mvalancy/j501-agx-orin/docs/README.md

[J501 AGX Orin](../README.md) / **docs**

# Docs

Reference material for reviewing and building the enclosure. Most of these files are generated by
[`tools/write_docs.py`](../tools/write_docs.py) from the CAD model, so edit the model, not the tables.

<p align="center">
  <a href="assembly/">Assembly step 3: heat-set inserts</a>
</p>

| File | What it is |
|---|---|
| [`assembly/`](assembly/) | Step pictures for [ASSEMBLY.md](../ASSEMBLY.md) |
| [`BOM.csv`](BOM.csv) | Bill of materials: printed parts, hardware and electronics, with dimensions |
| [`fastener-sources.csv`](fastener-sources.csv) | Where each fastener comes from, and how closely its model matches |
| [`check-sheet.pdf`](check-sheet.pdf) | Dimensioned drawings to check printed parts against |
| [`engineering-review.html`](engineering-review.html) | Every table below on one filterable page (download it, or run `tools/serve_preview.py`) |
| [`cad-agent-report.html`](cad-agent-report.html) | Pass or fail for every part, print file and design check |
| [`measurement-register.csv`](measurement-register.csv) | Every dimension the design relies on, and whether it was measured or assumed |
| [`cutout-register.csv`](cutout-register.csv) | Every cutout in the plates and walls, and what it is for |
| [`feature-review.csv`](feature-review.csv) | Feature-by-feature printability review |
| [`connector-inventory.csv`](connector-inventory.csv) | Connectors and components on the carrier, from the schematic |
| [`model-search.csv`](model-search.csv) | Where each vendor model was found, and which are still missing |
| [`img/hero/`](img/hero/) | The animated README banner, drawn from the STEP files by [mvalancy/mvalancy's `tools/hero`](https://github.com/mvalancy/mvalancy/tree/22437c66382b9fb908806cc1010b3036e4385004/tools/hero) |

GitHub shows the `.csv` files as searchable tables. The `.html` pages show as source on GitHub; open them locally to read them.

## Folders

| Folder | What is in it |
|---|---|
| [`assembly/`](assembly/) | Step pictures for ASSEMBLY.md |
