mvalancy/j501-agx-orin/preview/README.md

[J501 AGX Orin](../README.md) / **preview**

# Renders

Every picture of the Rev 0.9 design, rendered from the CAD by [`tools/render.py`](../tools/render.py). Click a picture for full size.

The same renders are on the local review site, which adds STL, 3MF and Bambu Studio download buttons:
`python tools/serve_preview.py` serves [`index.html`](index.html). The print files themselves are in [`exports/`](../exports/).

**Sections:** [Assembled](#assembled) · [Structure](#structure) · [Storage and cables](#storage-and-cables) · [Printed parts](#printed-parts) · [Hardware and electronics](#hardware-and-electronics) · [Carrier connectors](#carrier-connectors)

## Assembled

<table>
<tr>
<td width="33%" valign="top"><a href="assembled.png">Assembled: flush shell, framed I/O plates, finger-safe hex roof</a><br><b>Assembled</b>: flush shell, framed I/O plates, finger-safe hex roof</td>
<td width="33%" valign="top"><a href="exploded.png">Exploded: sliding plates captured by the lid, cooler tied to the floor</a><br><b>Exploded</b>: sliding plates captured by the lid, cooler tied to the floor</td>
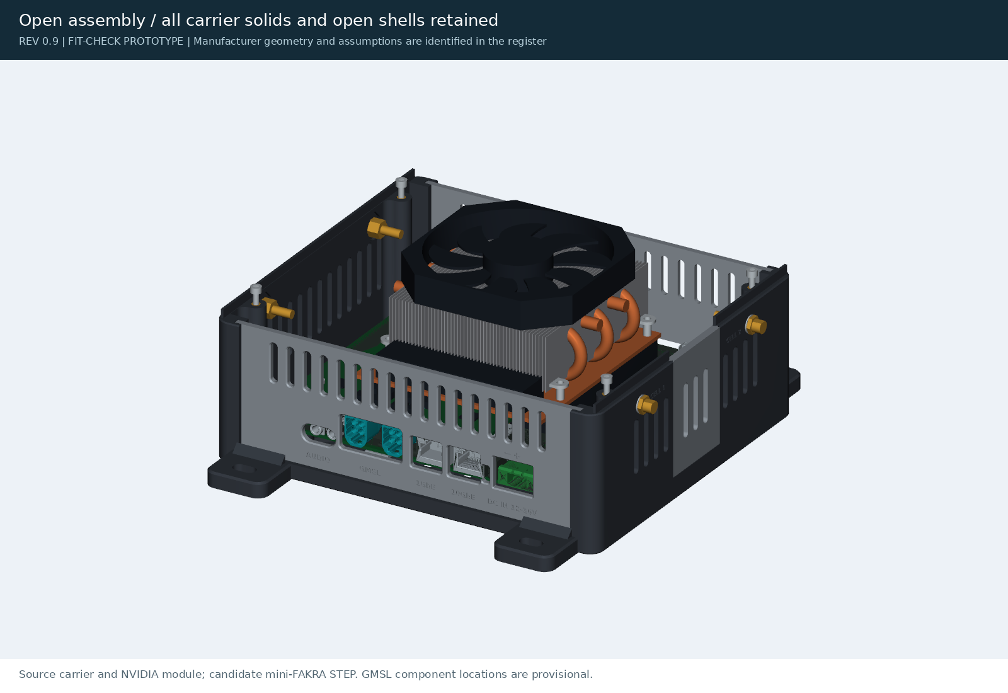
[picture p26: preview/open.png]
Open: every carrier solid and open shell kept
<td width="33%" valign="top"><br><b>Open</b>: every carrier solid and open shell kept</td>
</tr>
<tr>
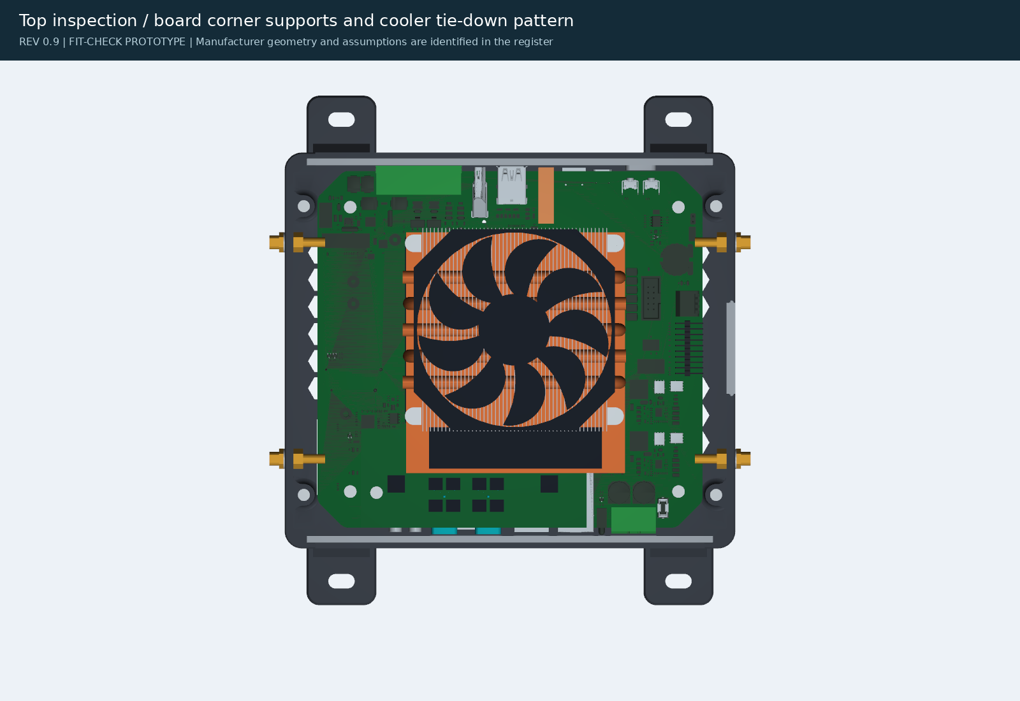
[picture p27: preview/top.png]
Top: board corner supports and cooler tie-down pattern
<td width="33%" valign="top"><br><b>Top</b>: board corner supports and cooler tie-down pattern</td>
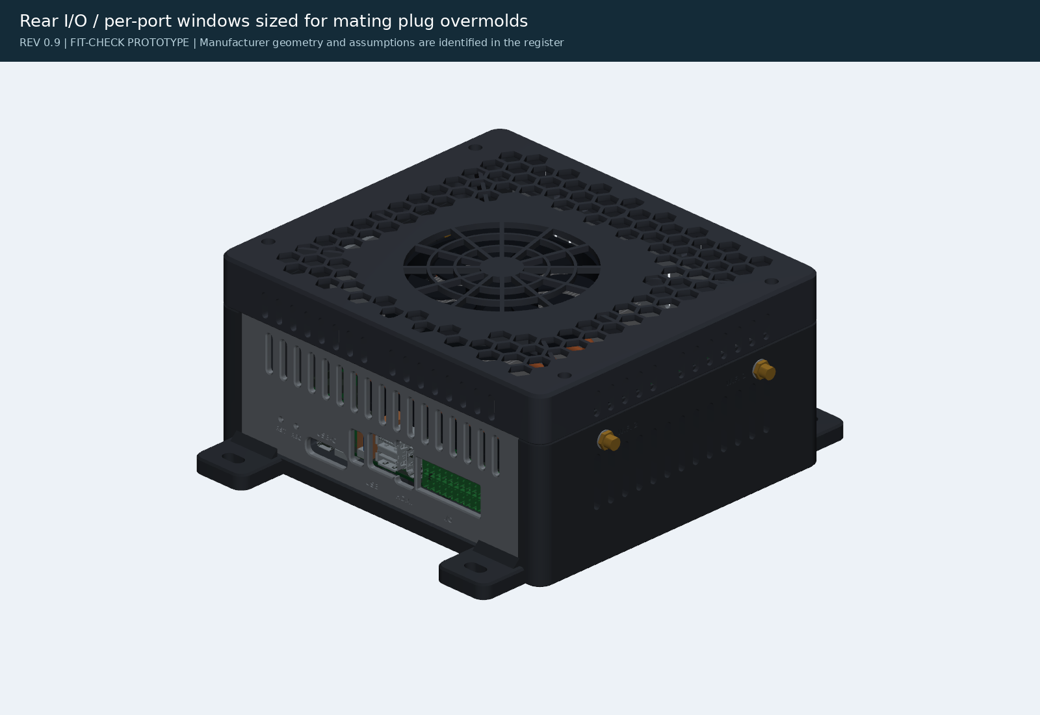
[picture p28: preview/rear.png]
Rear I/O: per-port windows sized for plug overmolds
<td width="33%" valign="top"><br><b>Rear I/O</b>: per-port windows sized for plug overmolds</td>
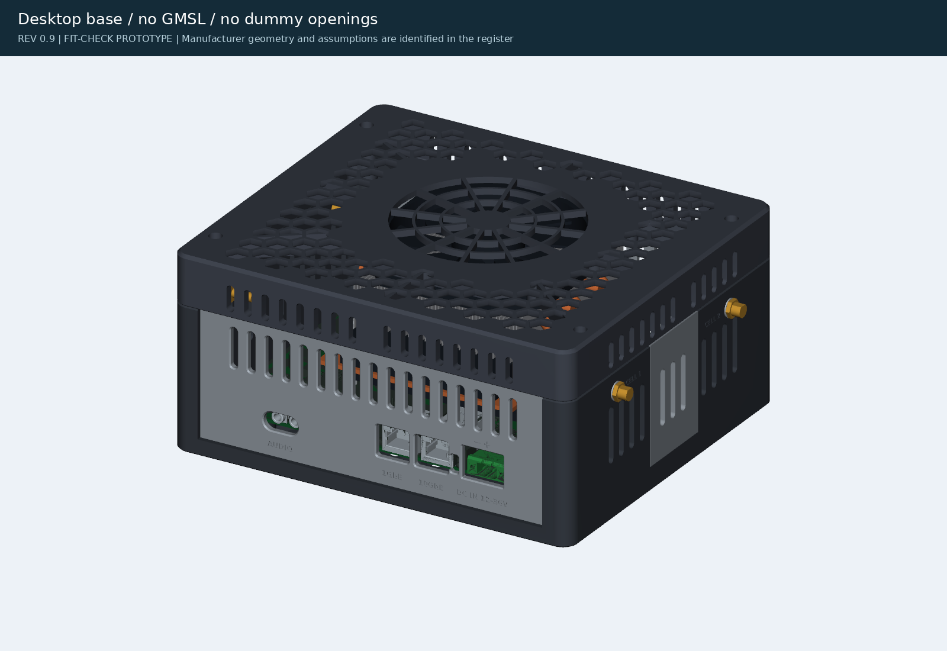
[picture p29: preview/no-gmsl.png]
Desktop, no GMSL: no dummy openings
<td width="33%" valign="top"><br><b>Desktop, no GMSL</b>: no dummy openings</td>
</tr>
<tr>
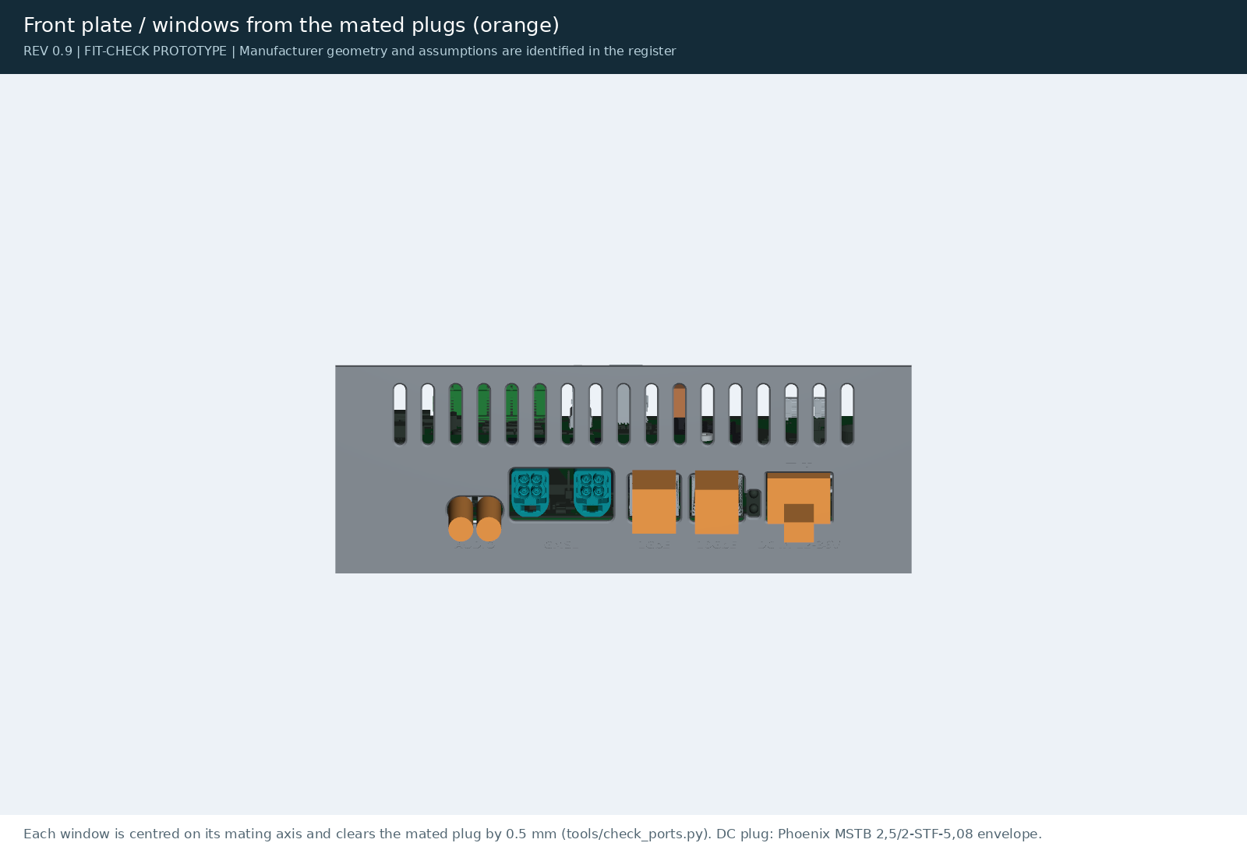
[picture p30: preview/front-fit.png]
Front plate: one window per connector group
<td width="33%" valign="top"><br><b>Front plate</b>: one window per connector group</td>
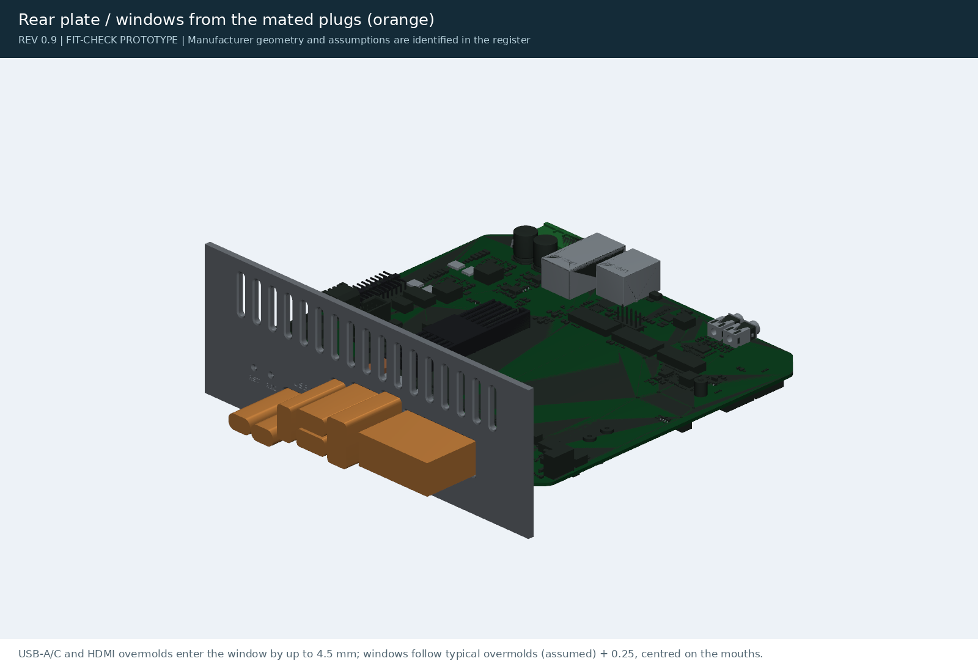
[picture p31: preview/rear-fit.png]
Rear plate: windows sized to plug overmolds
<td width="33%" valign="top"><br><b>Rear plate</b>: windows sized to plug overmolds</td>
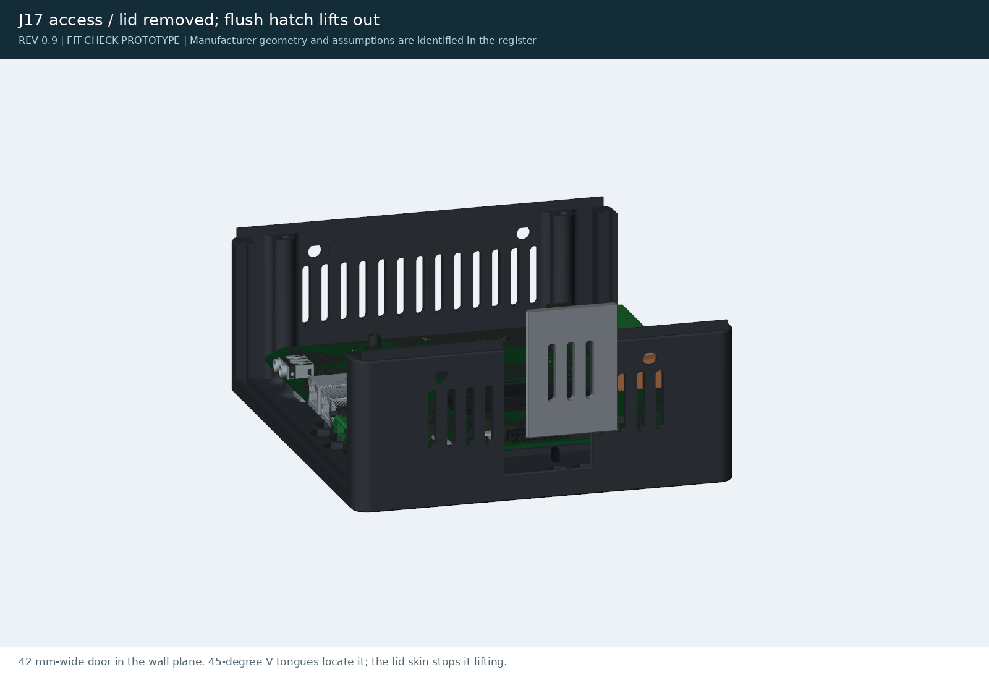
[picture p32: preview/side-access.png]
J17 access: lid off, the flush hatch lifts out
<td width="33%" valign="top"><br><b>J17 access</b>: lid off, the flush hatch lifts out</td>
</tr>
<tr>
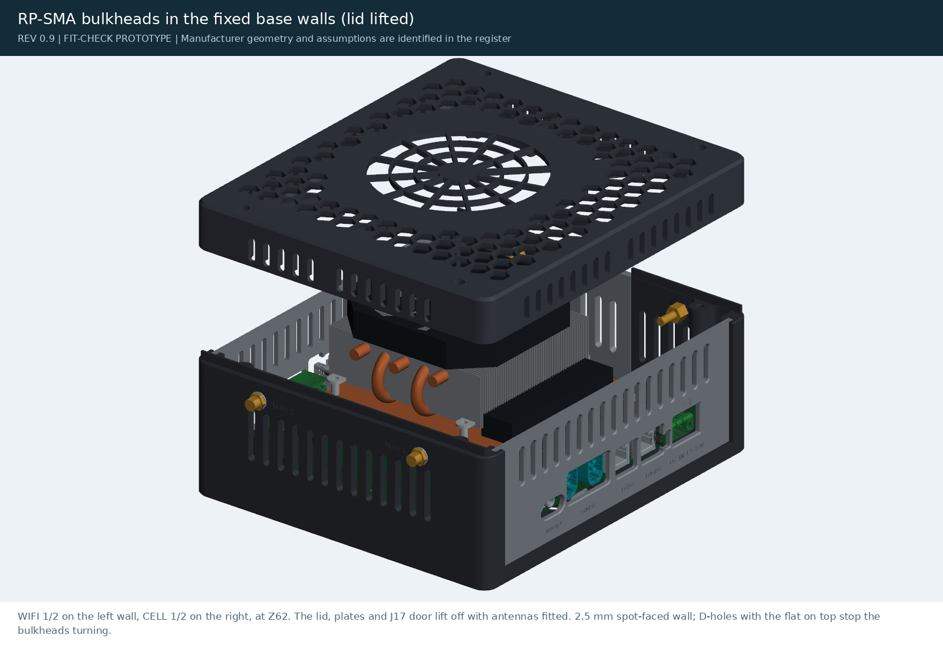
[picture p33: preview/antennas.png]
Antennas: RP-SMA bulkheads in the fixed base walls
<td width="33%" valign="top"><br><b>Antennas</b>: RP-SMA bulkheads in the fixed base walls</td>
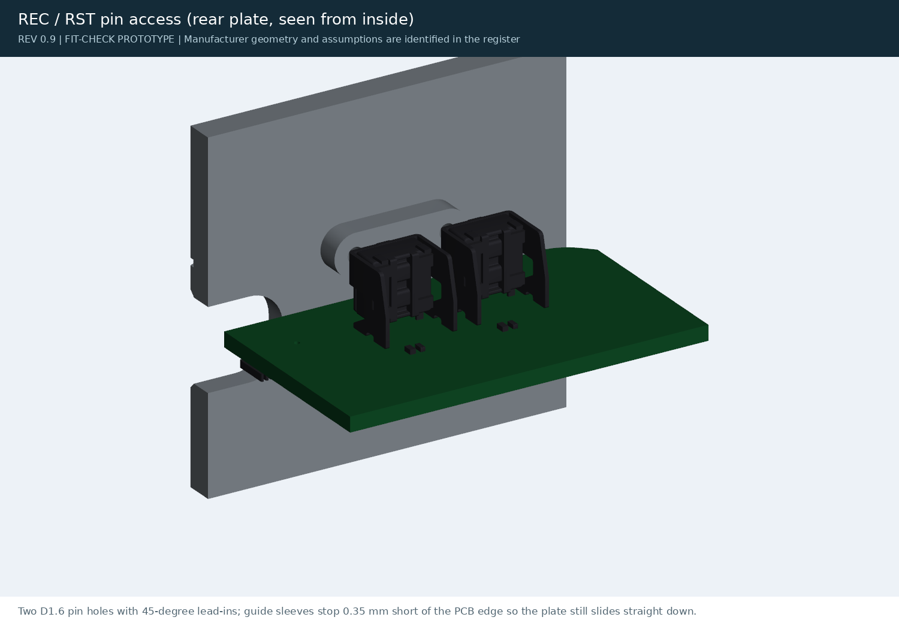
[picture p34: preview/service-buttons.png]
Reset and recovery: pin access through the rear plate
<td width="33%" valign="top"><br><b>Reset and recovery</b>: pin access through the rear plate</td>
<td width="33%"></td>
</tr>
</table>

## Structure

<table>
<tr>
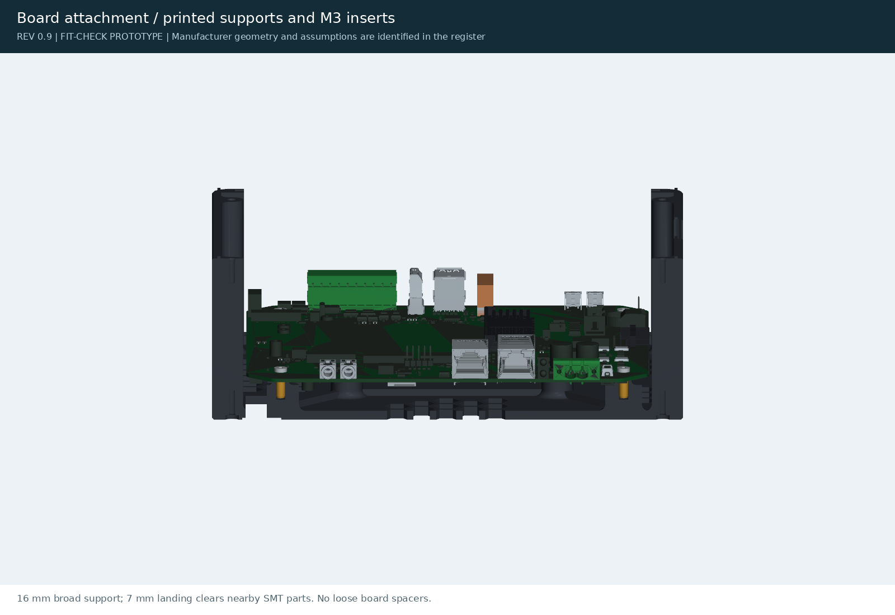
[picture p35: preview/board-mount.png]
Board mounting: printed supports and M3 inserts
<td width="33%" valign="top"><br><b>Board mounting</b>: printed supports and M3 inserts</td>
<td width="33%" valign="top"><a href="heatsink-tiedown.png">Cooler tie-down: section; the weight of the cooler goes into the floor</a><br><b>Cooler tie-down</b>: section; the weight of the cooler goes into the floor</td>
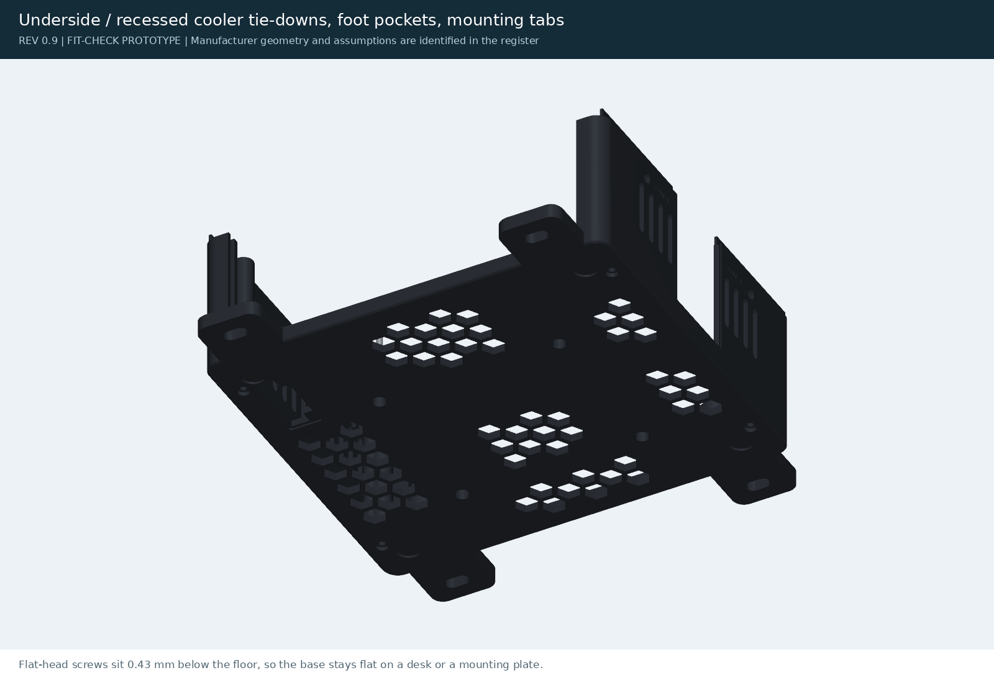
[picture p36: preview/bottom.png]
Underside: recessed tie-down screws, foot pockets, mounting tabs
<td width="33%" valign="top"><br><b>Underside</b>: recessed tie-down screws, foot pockets, mounting tabs</td>
</tr>
<tr>
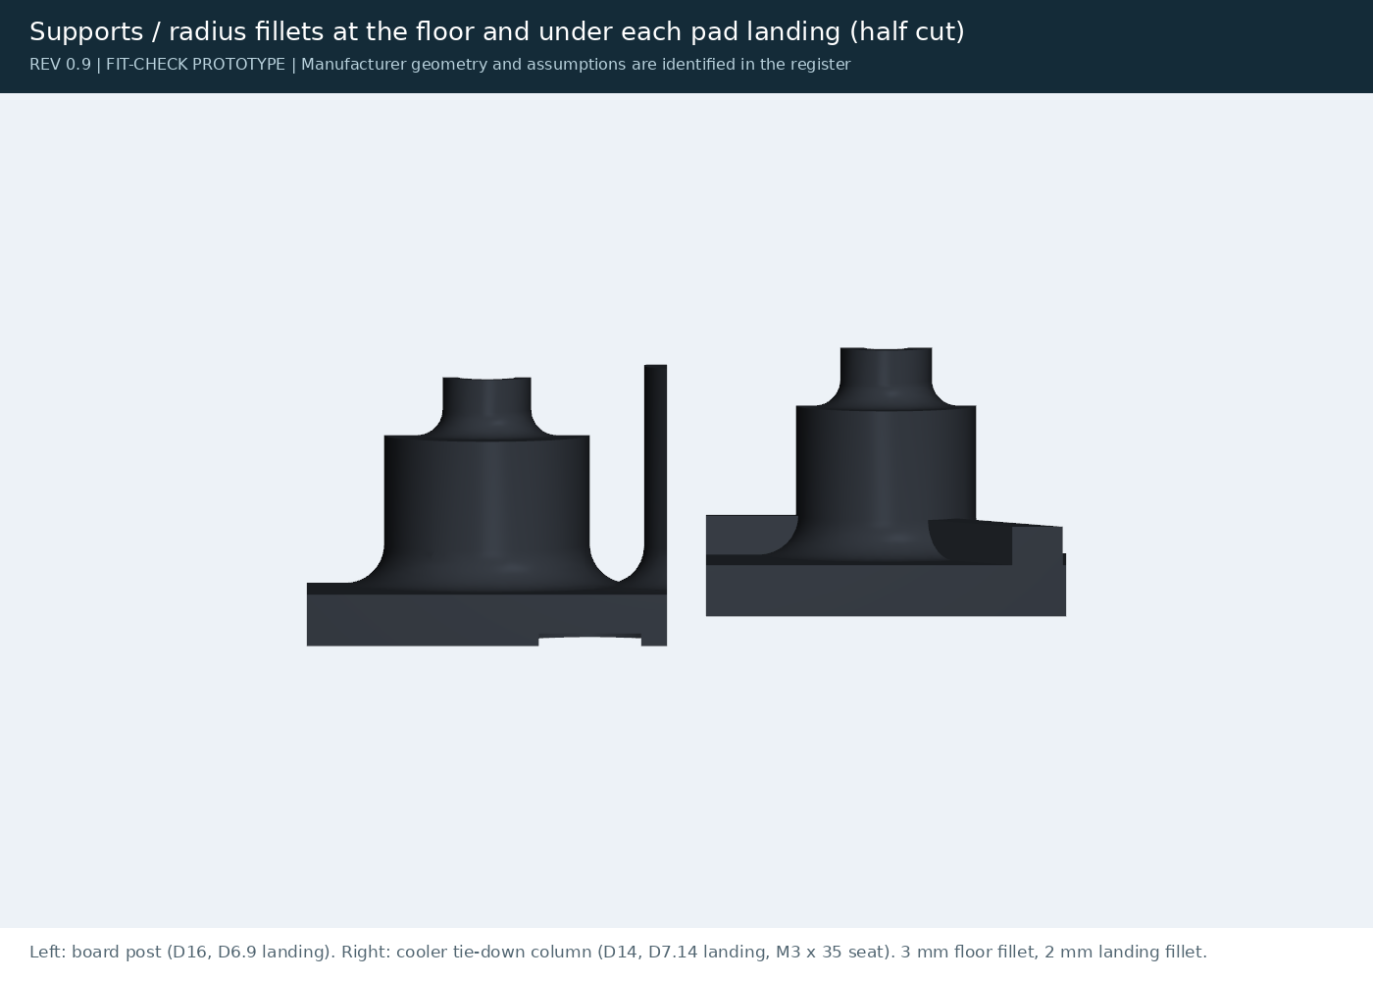
[picture p37: preview/support-detail.png]
Supports: radius fillets at the floor and under each pad (half cut)
<td width="33%" valign="top"><br><b>Supports</b>: radius fillets at the floor and under each pad (half cut)</td>
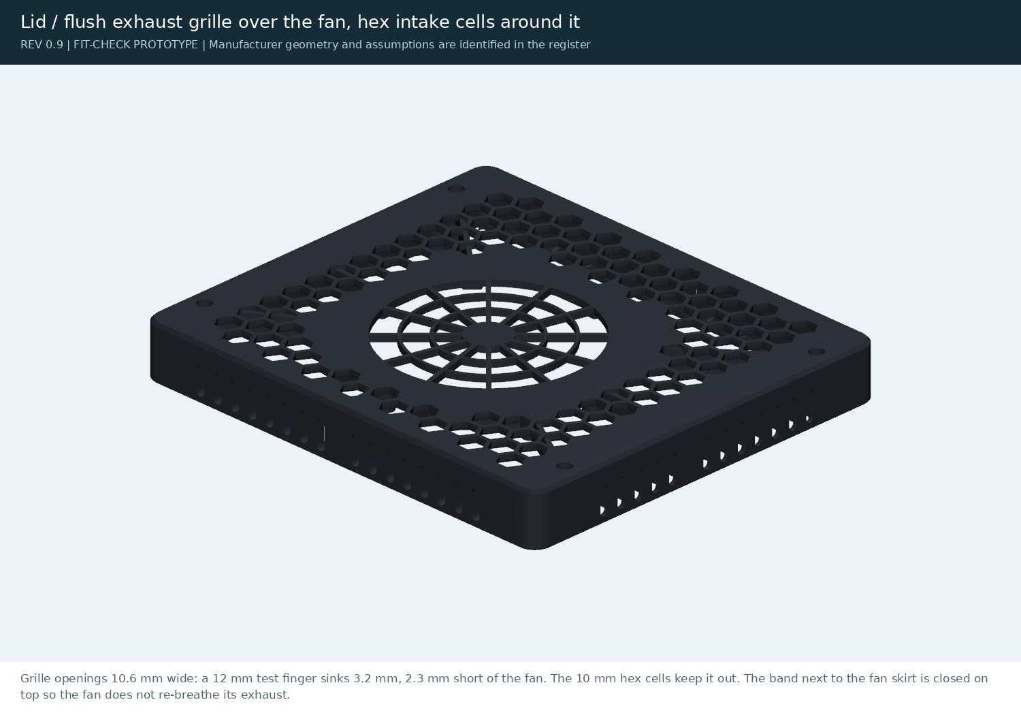
[picture p38: preview/lid-detail.png]
Lid: honeycomb grille over the cooler fan
<td width="33%" valign="top"><br><b>Lid</b>: honeycomb grille over the cooler fan</td>
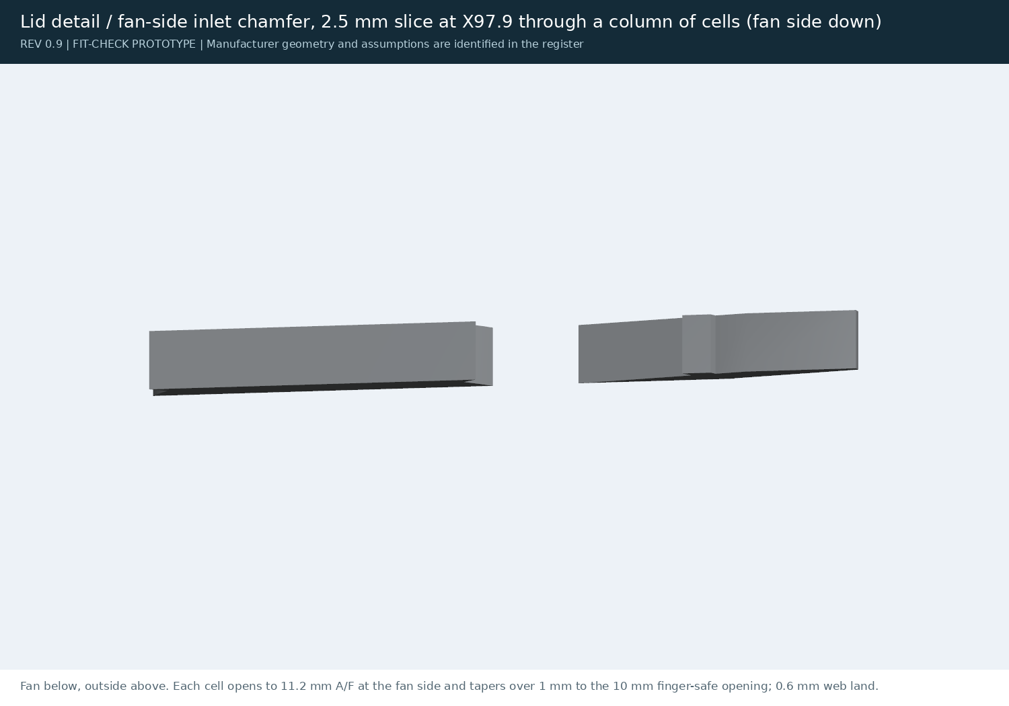
[picture p39: preview/hex-inlet.png]
Lid inlet: fan-side chamfer on the grille cells
<td width="33%" valign="top"><br><b>Lid inlet</b>: fan-side chamfer on the grille cells</td>
</tr>
<tr>
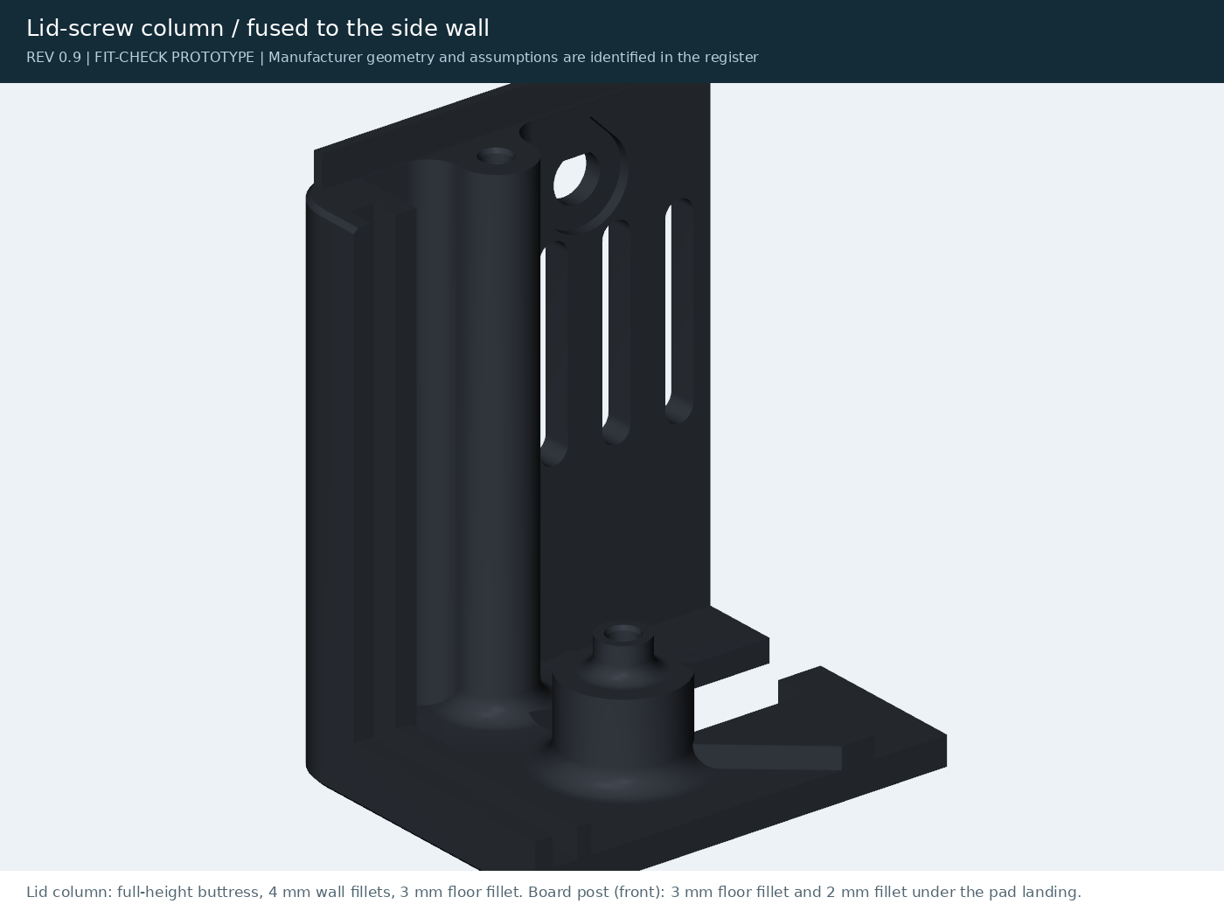
[picture p40: preview/lid-column-detail.png]
Lid-screw column: fused to the side wall
<td width="33%" valign="top"><br><b>Lid-screw column</b>: fused to the side wall</td>
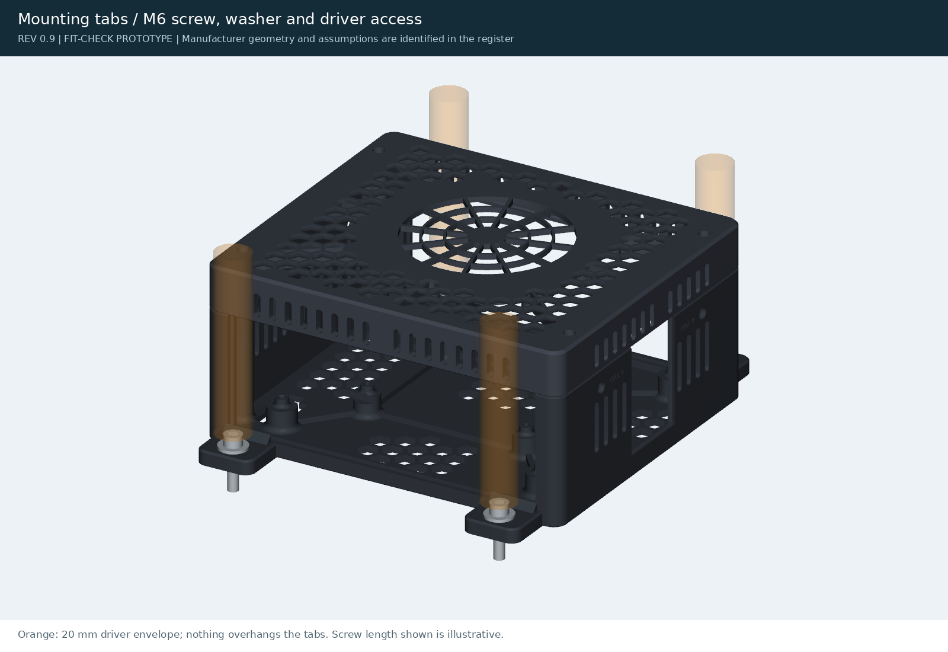
[picture p41: preview/mount-clearance.png]
Mounting tabs: M6 screw, washer and driver access
<td width="33%" valign="top"><br><b>Mounting tabs</b>: M6 screw, washer and driver access</td>
<td width="33%"></td>
</tr>
</table>

## Storage and cables

<table>
<tr>
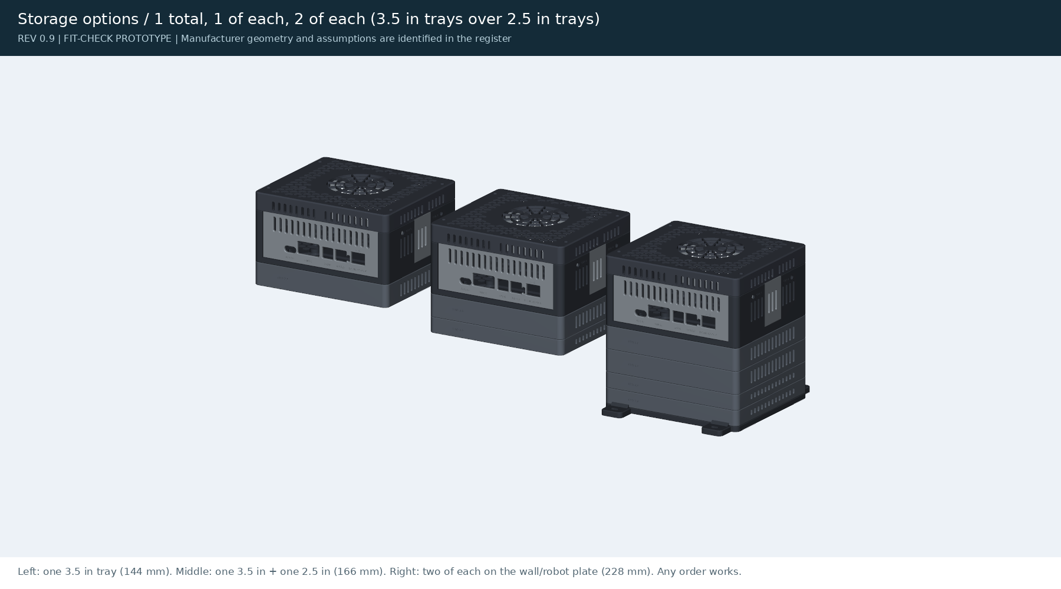
[picture p42: preview/storage-configs.png]
Storage options: 1 tray, 1 of each, 2 of each
<td width="33%" valign="top"><br><b>Storage options</b>: 1 tray, 1 of each, 2 of each</td>
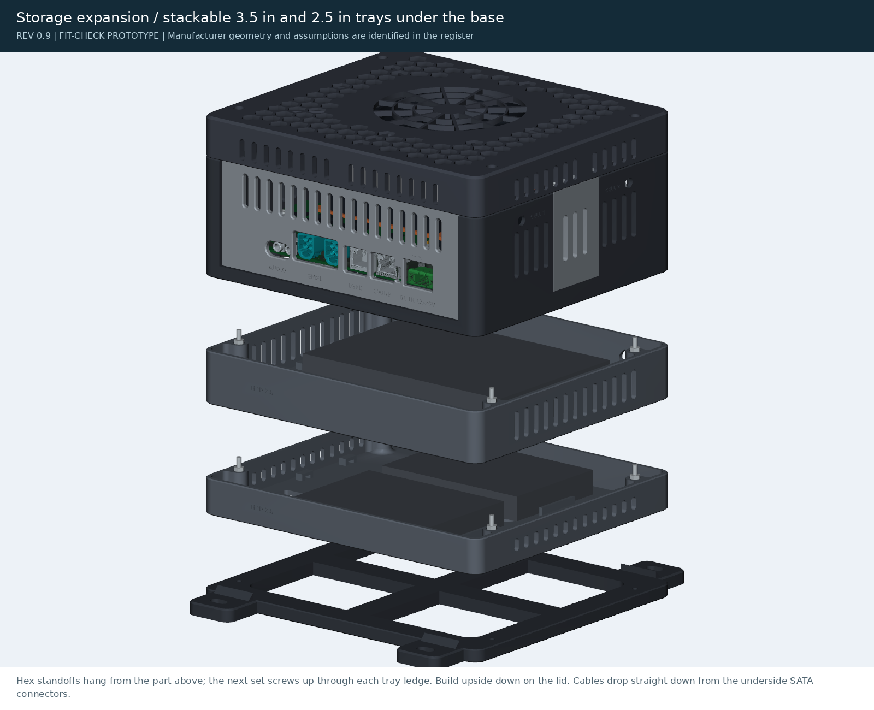
[picture p43: preview/storage-exploded.png]
Storage, exploded: trays stack under the base
<td width="33%" valign="top"><br><b>Storage, exploded</b>: trays stack under the base</td>
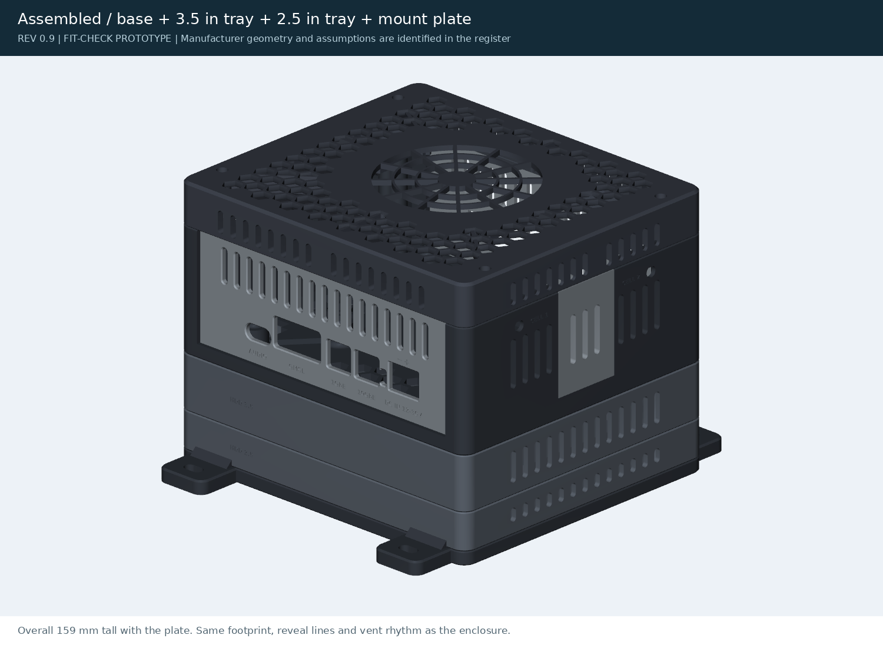
[picture p44: preview/storage-stack.png]
Stack: base, 3.5 in tray, 2.5 in tray, mounting plate
<td width="33%" valign="top"><br><b>Stack</b>: base, 3.5 in tray, 2.5 in tray, mounting plate</td>
</tr>
<tr>
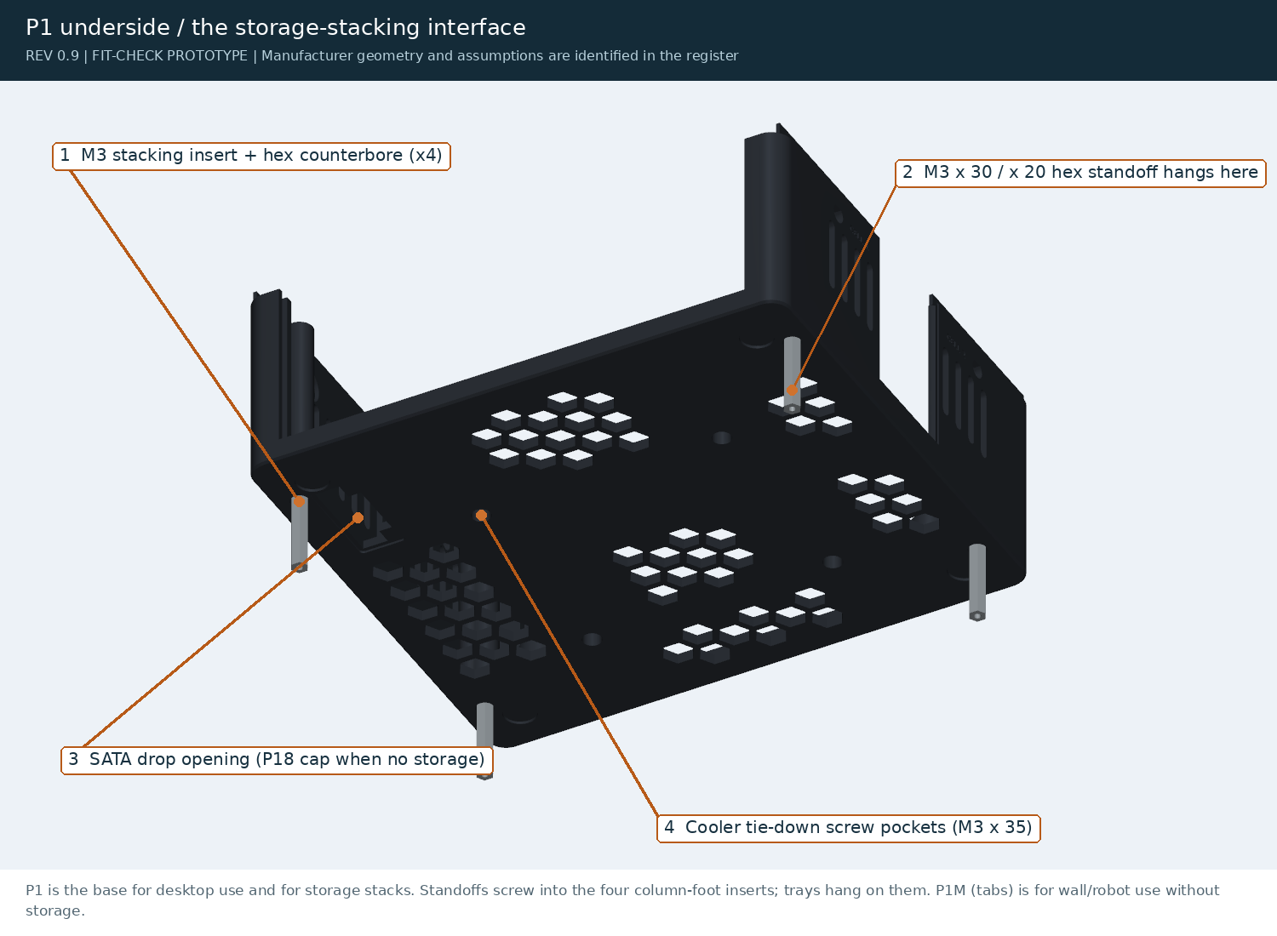
[picture p45: preview/base-stacking.png]
P1 underside: where the trays attach
<td width="33%" valign="top"><br><b>P1 underside</b>: where the trays attach</td>
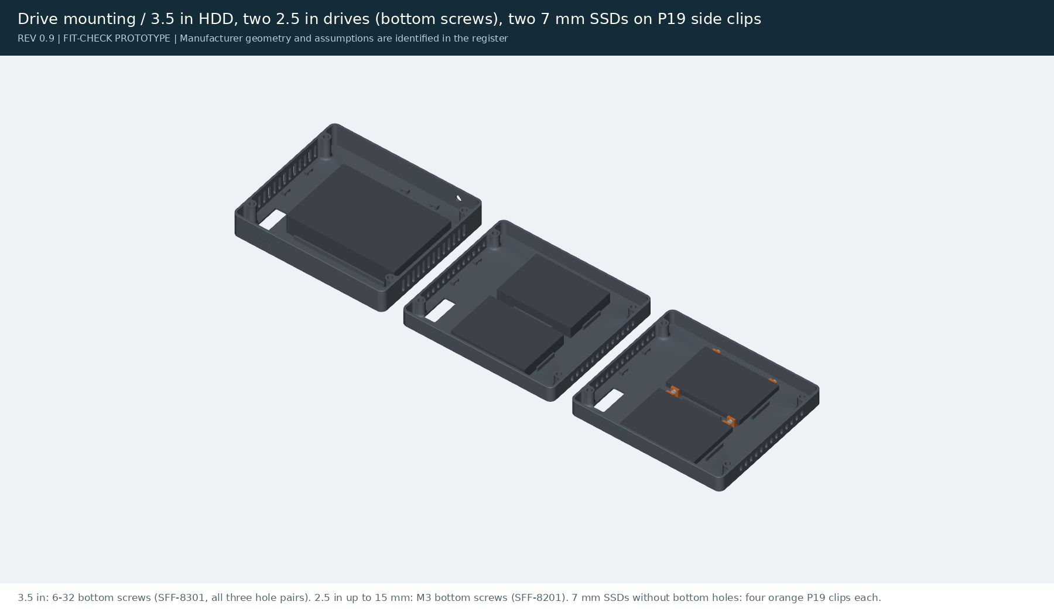
[picture p46: preview/drive-bays.png]
Drive mounting: 3.5 in, 2.5 in, and 7 mm SSDs on P19 clips
<td width="33%" valign="top"><br><b>Drive mounting</b>: 3.5 in, 2.5 in, and 7 mm SSDs on P19 clips</td>
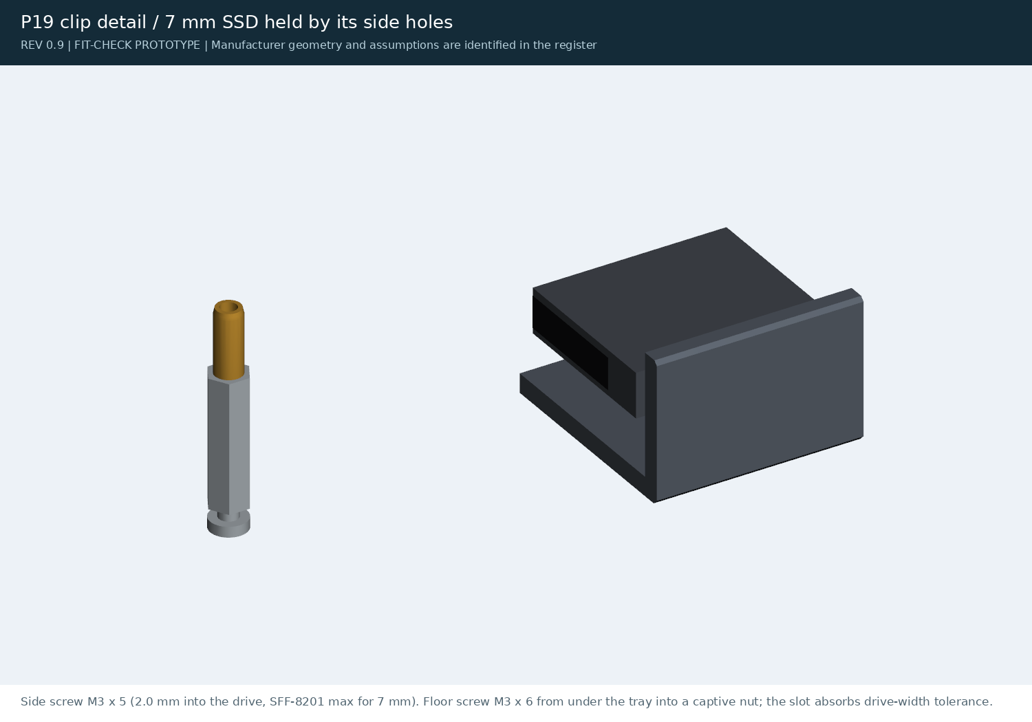
[picture p47: preview/ssd-clip-detail.png]
P19 clip: holds a 7 mm SSD by its side holes
<td width="33%" valign="top"><br><b>P19 clip</b>: holds a 7 mm SSD by its side holes</td>
</tr>
<tr>
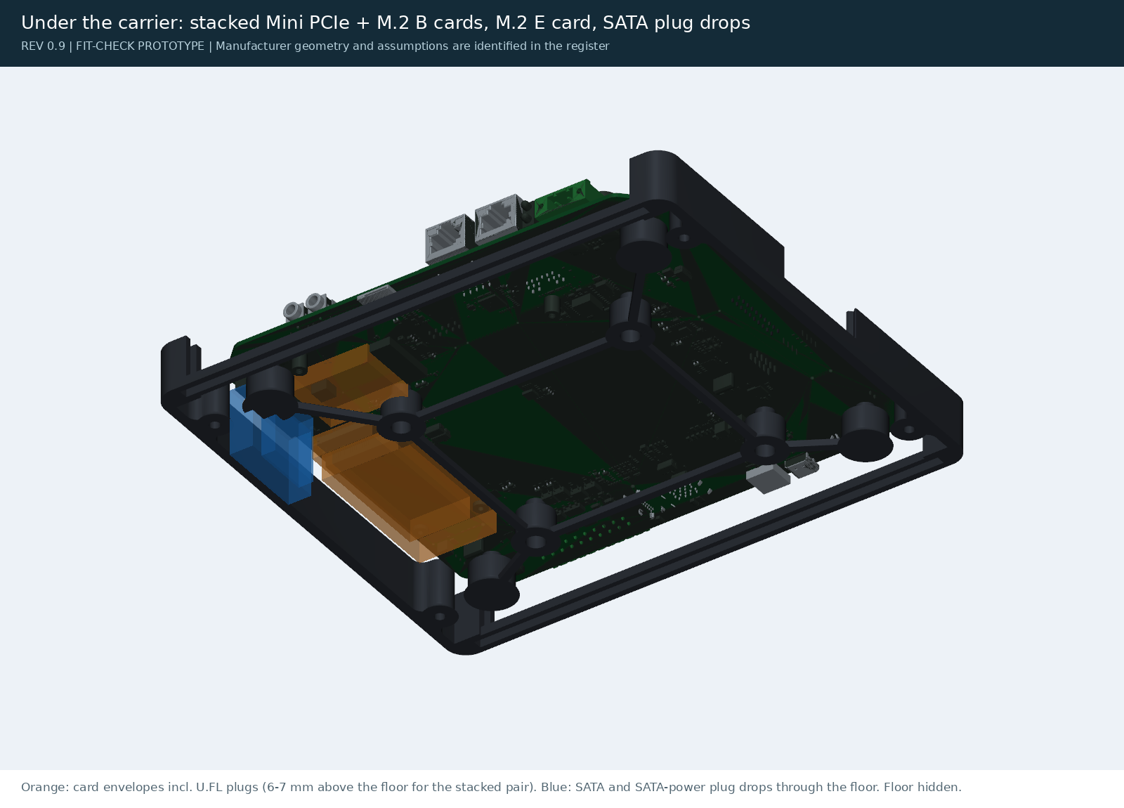
[picture p48: preview/underside-slots.png]
Under the board: Mini PCIe, M.2 B and M.2 E cards, SATA plugs
<td width="33%" valign="top"><br><b>Under the board</b>: Mini PCIe, M.2 B and M.2 E cards, SATA plugs</td>
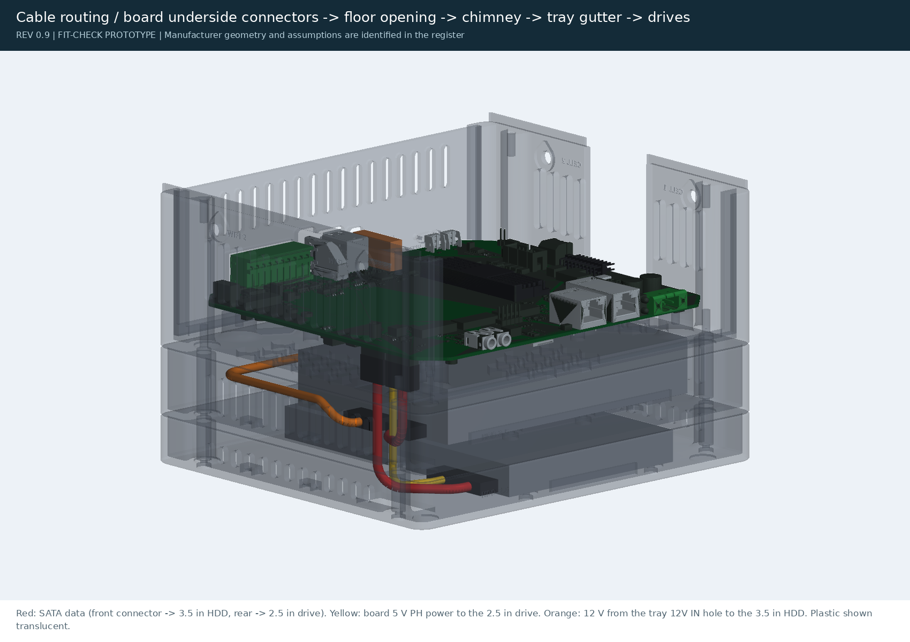
[picture p49: preview/cable-routing.png]
Cable routing: underside connectors, floor opening, chimney, drives
<td width="33%" valign="top"><br><b>Cable routing</b>: underside connectors, floor opening, chimney, drives</td>
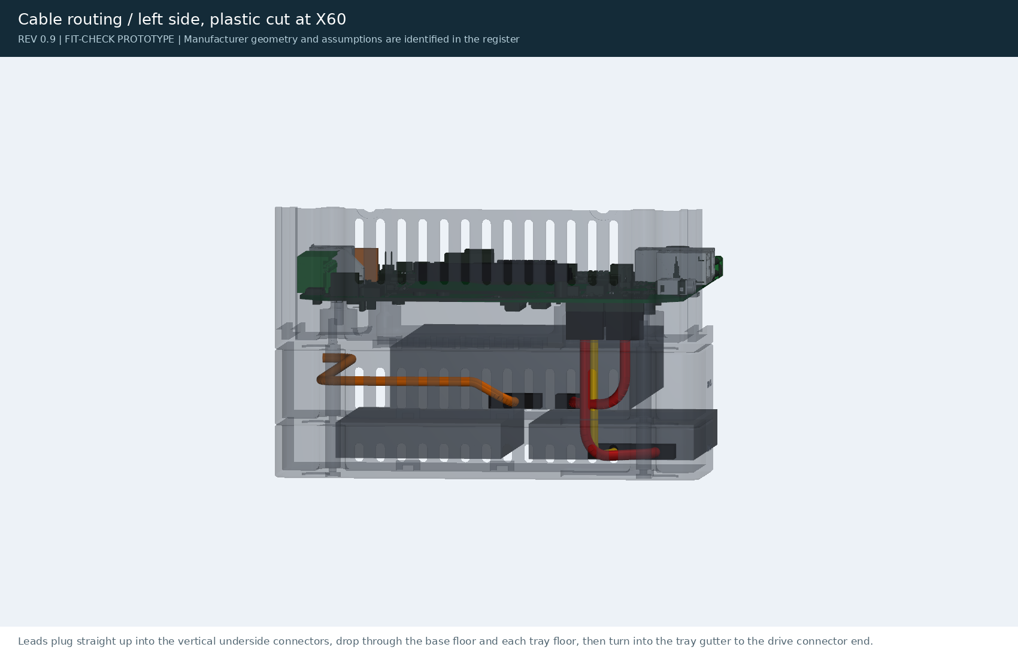
[picture p50: preview/cable-routing-side.png]
Cable routing, side cut
<td width="33%" valign="top"><br><b>Cable routing, side cut</b></td>
</tr>
<tr>
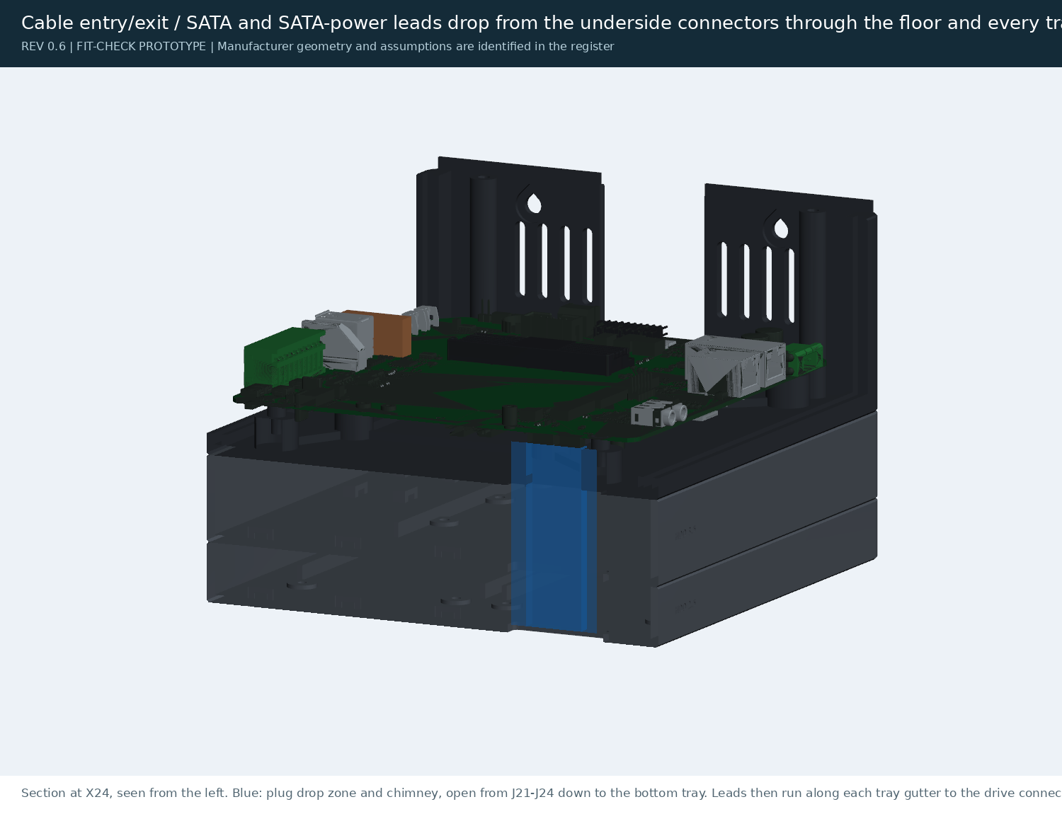
[picture p51: preview/cable-path.png]
Cable path: SATA leads drop through the floor into the trays
<td width="33%" valign="top"><br><b>Cable path</b>: SATA leads drop through the floor into the trays</td>
<td width="33%" valign="top"><a href="cable-route-diagram.png">Cable-route diagram: side elevation and tray plan</a><br><b>Cable-route diagram</b>: side elevation and tray plan</td>
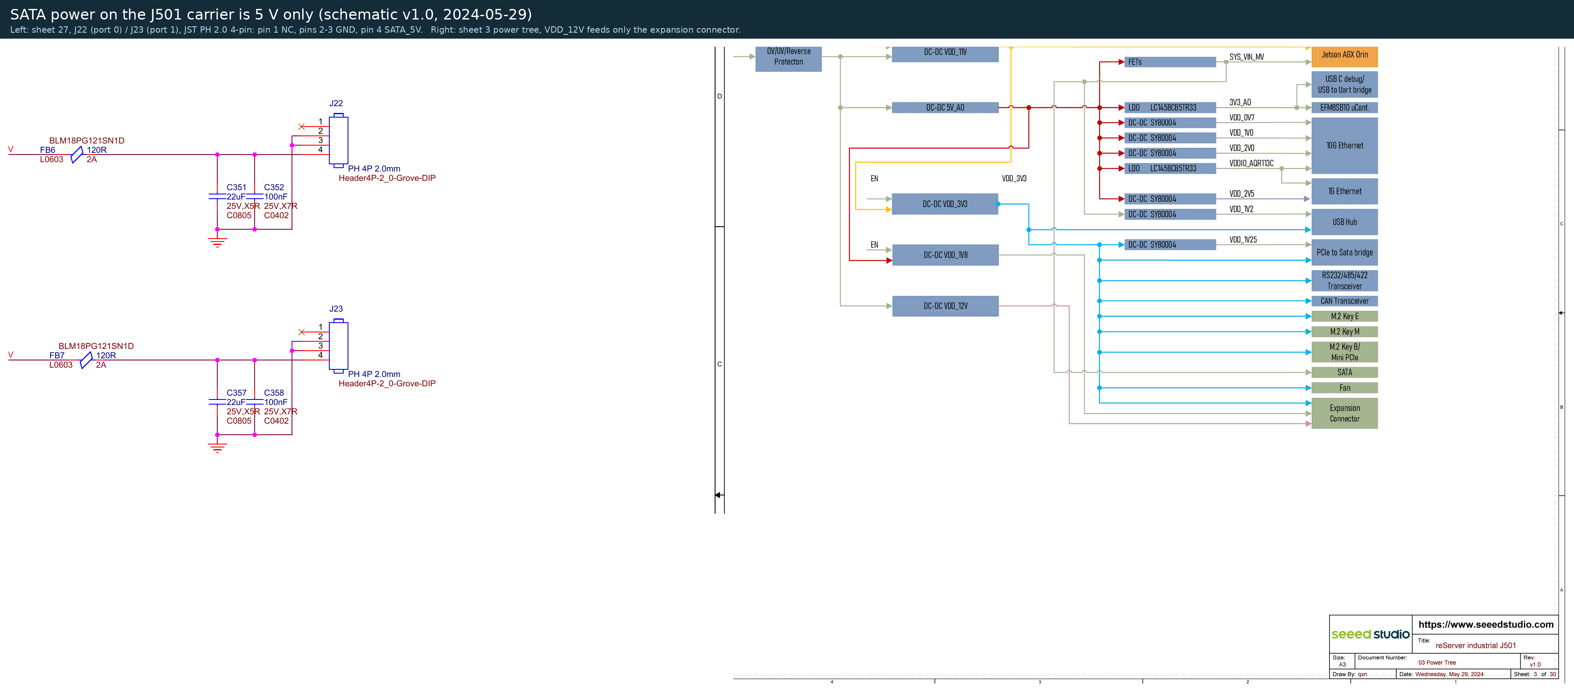
[picture p52: preview/sata-power-schematic.png]
SATA power: the board supplies 5 V only (schematic sheet 27)
<td width="33%" valign="top"><br><b>SATA power</b>: the board supplies 5 V only (schematic sheet 27)</td>
</tr>
</table>

## Printed parts

Click a part to open it in GitHub's 3D viewer. Download links for each part are in [`exports/`](../exports/).

<table>
<tr>
<td width="25%" valign="top"><a href="../exports/base.stl">P1 Base</a><br><b>P1</b> Base</td>
<td width="25%" valign="top"><a href="../exports/base_mount.stl">P1M Base with mounting tabs</a><br><b>P1M</b> Base with mounting tabs</td>
<td width="25%" valign="top"><a href="../exports/cover.stl">P2 Cover</a><br><b>P2</b> Cover</td>
<td width="25%" valign="top"><a href="../exports/front_gmsl.stl">P3 Front plate, GMSL</a><br><b>P3</b> Front plate, GMSL</td>
</tr>
<tr>
<td width="25%" valign="top"><a href="../exports/front_no_gmsl.stl">P4 Front plate</a><br><b>P4</b> Front plate</td>
<td width="25%" valign="top"><a href="../exports/rear_io.stl">P5 Rear plate</a><br><b>P5</b> Rear plate</td>
<td width="25%" valign="top"><a href="../exports/side_hatch.stl">P10 Side hatch</a><br><b>P10</b> Side hatch</td>
<td width="25%" valign="top"><a href="../exports/chimney_cap.stl">P18 Floor cap</a><br><b>P18</b> Floor cap</td>
</tr>
<tr>
<td width="25%" valign="top"><a href="../exports/storage_35.stl">P15 3.5 in tray</a><br><b>P15</b> 3.5 in tray</td>
<td width="25%" valign="top"><a href="../exports/storage_25.stl">P16 2.5 in tray</a><br><b>P16</b> 2.5 in tray</td>
<td width="25%" valign="top"><a href="../exports/storage_mount_plate.stl">P17 Mounting plate</a><br><b>P17</b> Mounting plate</td>
<td width="25%" valign="top"><a href="../exports/ssd_clip.stl">P19 SSD clip</a><br><b>P19</b> SSD clip</td>
</tr>
<tr>
<td width="25%" valign="top"><a href="../exports/mount_fit_template.stl">P9 Board fit template</a><br><b>P9</b> Board fit template</td>
<td width="25%" valign="top"><a href="../exports/m3_insert_coupon.stl">P11 Insert coupon</a><br><b>P11</b> Insert coupon</td>
<td width="25%" valign="top"><a href="../exports/rail_coupon.stl">P12 Rail coupon</a><br><b>P12</b> Rail coupon</td>
<td width="25%" valign="top"><a href="../exports/rail_key.stl">P13 Rail key</a><br><b>P13</b> Rail key</td>
</tr>
<tr>
<td width="25%" valign="top"><a href="../exports/countersink_coupon.stl">P14 Countersink coupon</a><br><b>P14</b> Countersink coupon</td>
<td width="25%" valign="top"><a href="../exports/rpsma_coupon.stl">P20 Antenna hole coupon</a><br><b>P20</b> Antenna hole coupon</td>
<td width="25%"></td>
<td width="25%"></td>
</tr>
</table>

## Hardware and electronics

Bought parts and vendor models, shown for fit. Fastener threads, cooler internals and the GMSL component positions are approximate.

<table>
<tr>
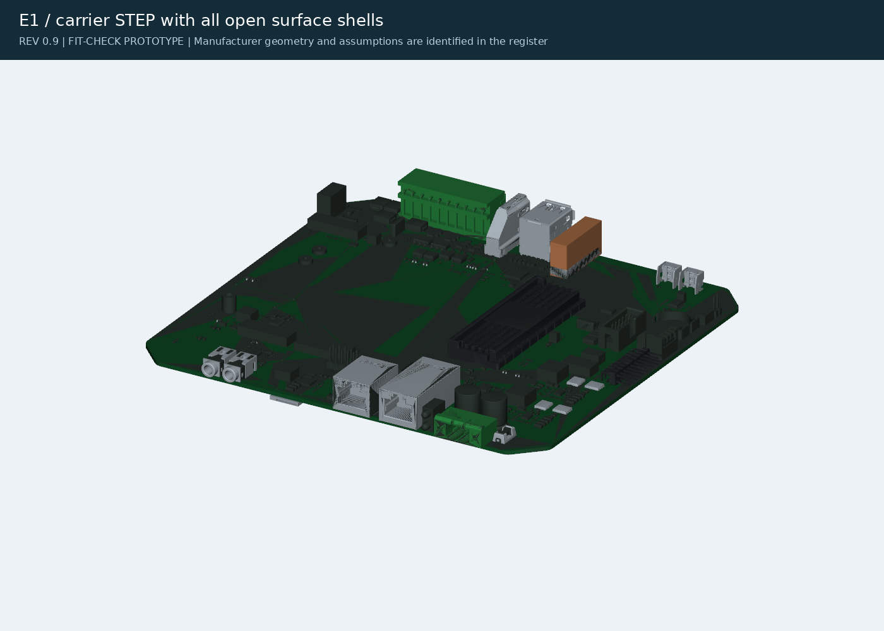
[picture p53: preview/part-carrier.png]
E1 J501 carrier board
<td width="25%" valign="top"><br><b>E1</b> J501 carrier board</td>
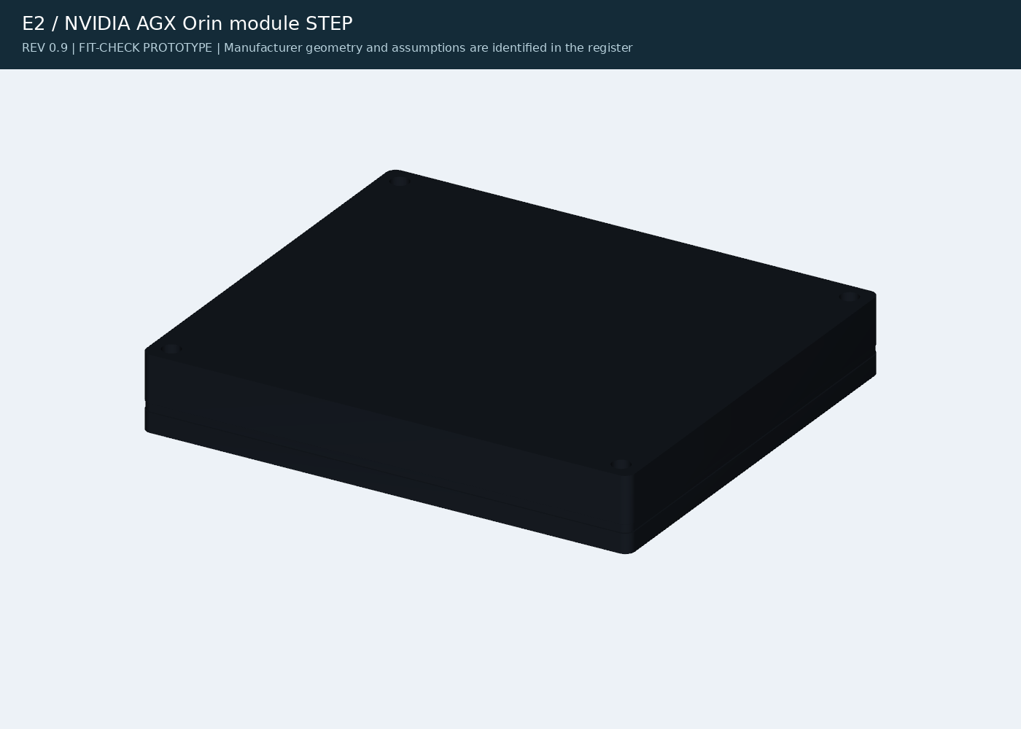
[picture p54: preview/part-module.png]
E2 Jetson AGX Orin module
<td width="25%" valign="top"><br><b>E2</b> Jetson AGX Orin module</td>
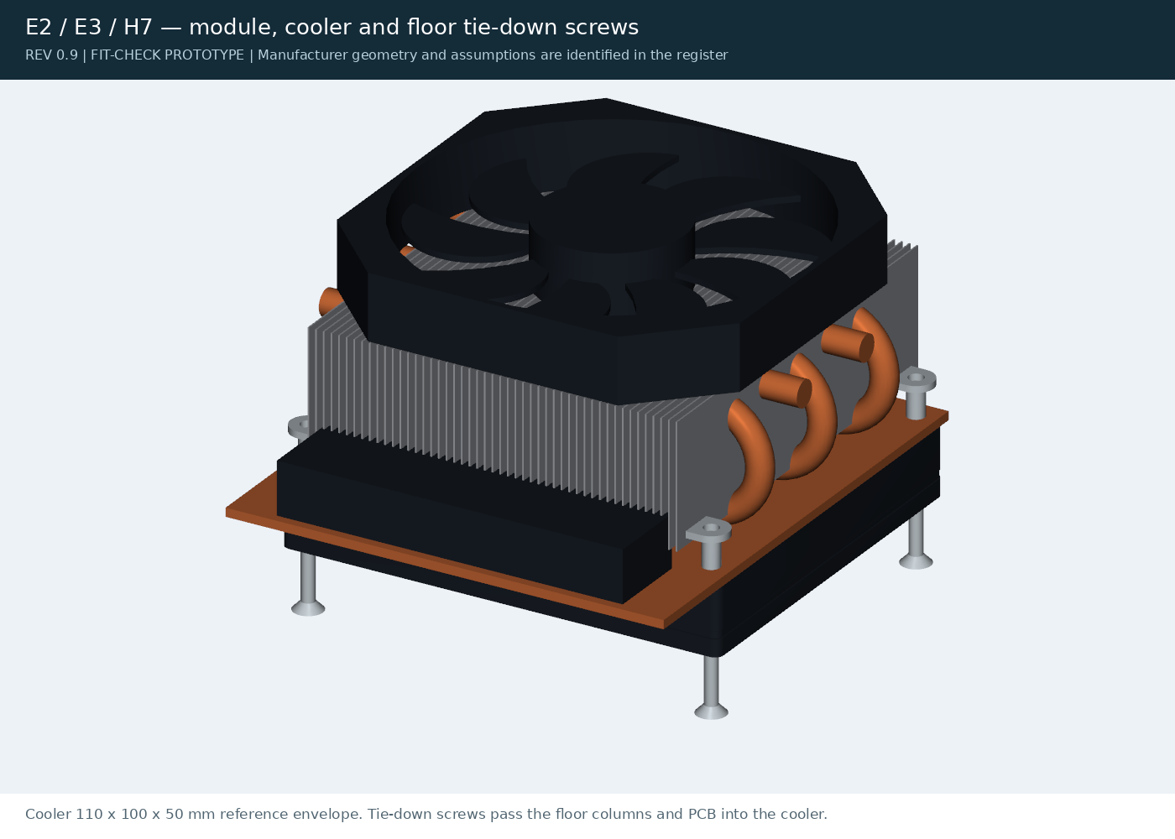
[picture p55: preview/part-cooler.png]
E2 / E3 / H7 module, cooler and tie-down screws
<td width="25%" valign="top"><br><b>E2 / E3 / H7</b> module, cooler and tie-down screws</td>
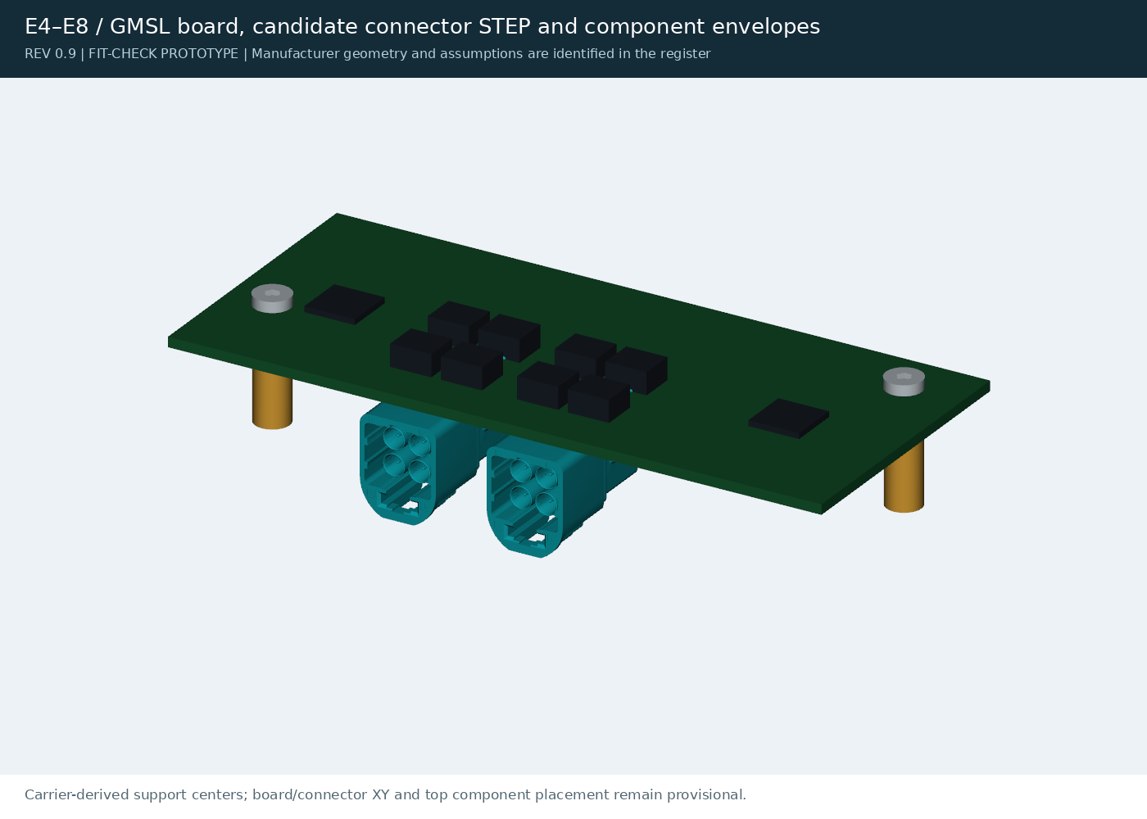
[picture p56: preview/part-gmsl.png]
E4–E8 GMSL extension board
<td width="25%" valign="top"><br><b>E4–E8</b> GMSL extension board</td>
</tr>
<tr>
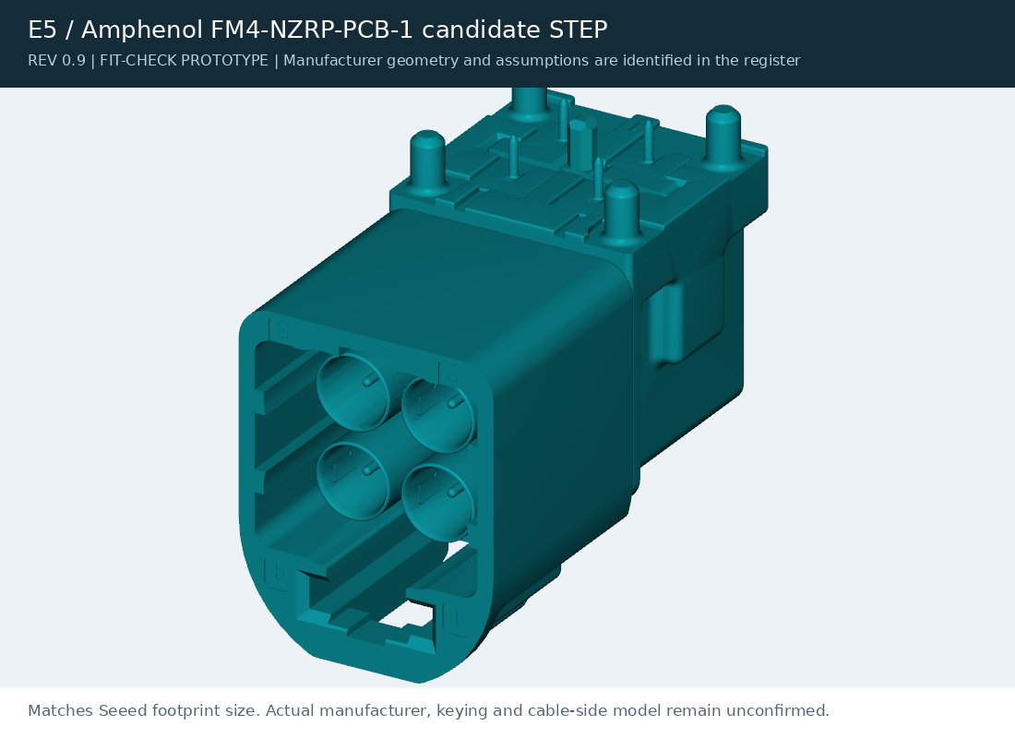
[picture p57: preview/part-fakra.png]
E5 mini-FAKRA connector (candidate model)
<td width="25%" valign="top"><br><b>E5</b> mini-FAKRA connector (candidate model)</td>
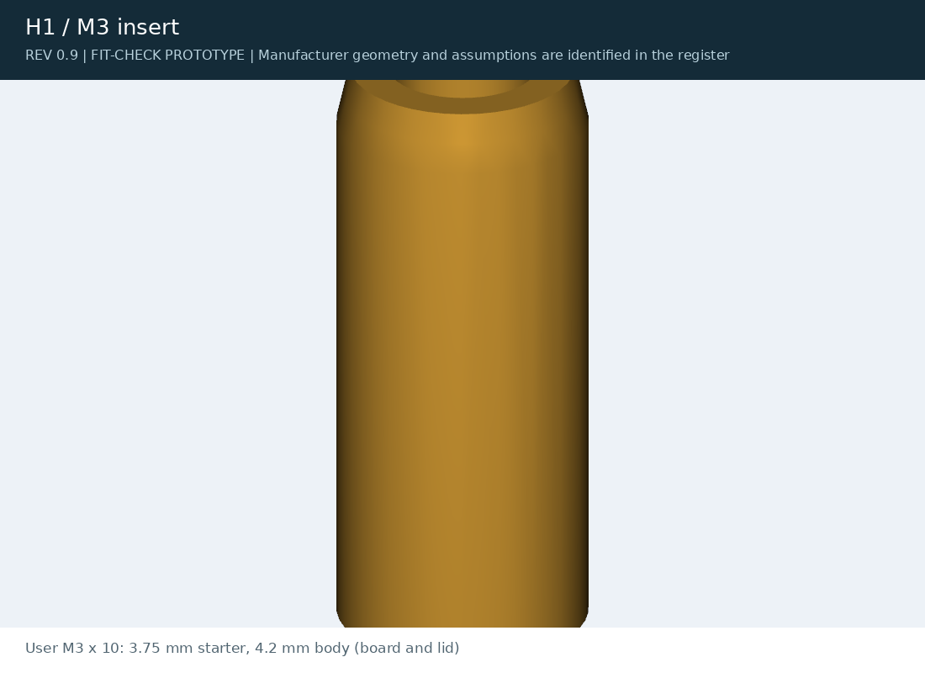
[picture p58: preview/part-M3_insert.png]
H1 M3 × 10 heat-set insert
<td width="25%" valign="top"><br><b>H1</b> M3 × 10 heat-set insert</td>
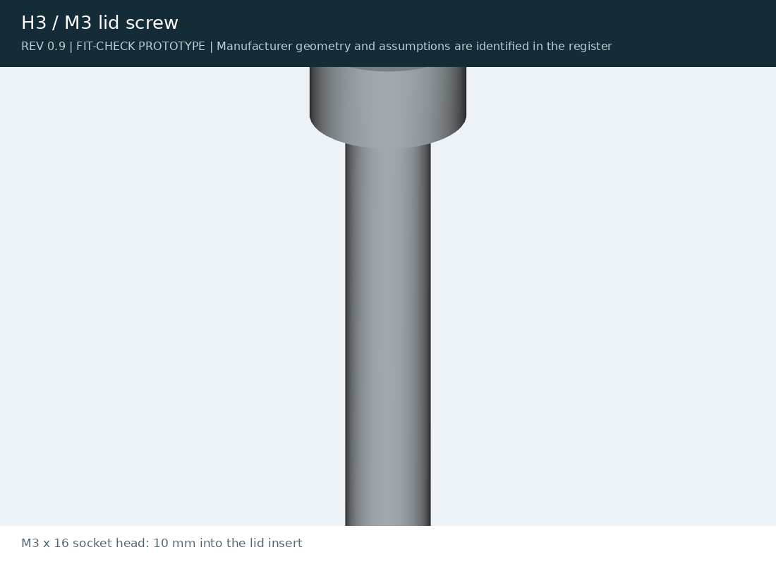
[picture p59: preview/part-M3_lid_screw.png]
H3 M3 × 16 lid screw
<td width="25%" valign="top"><br><b>H3</b> M3 × 16 lid screw</td>
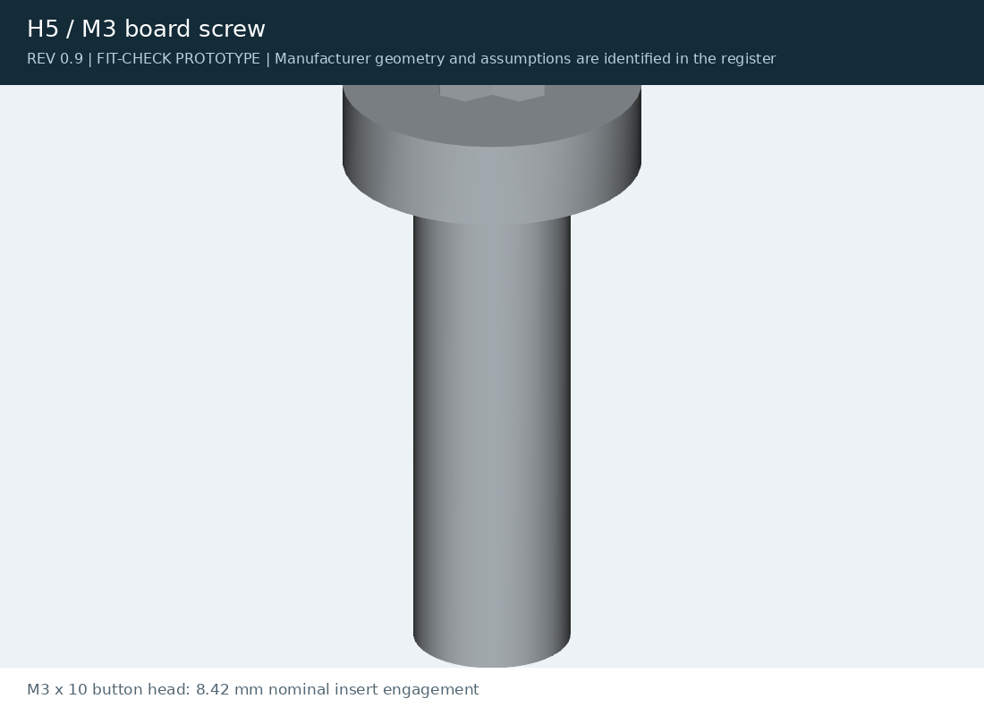
[picture p60: preview/part-M3_board_screw.png]
H5 M3 × 10 board screw
<td width="25%" valign="top"><br><b>H5</b> M3 × 10 board screw</td>
</tr>
<tr>
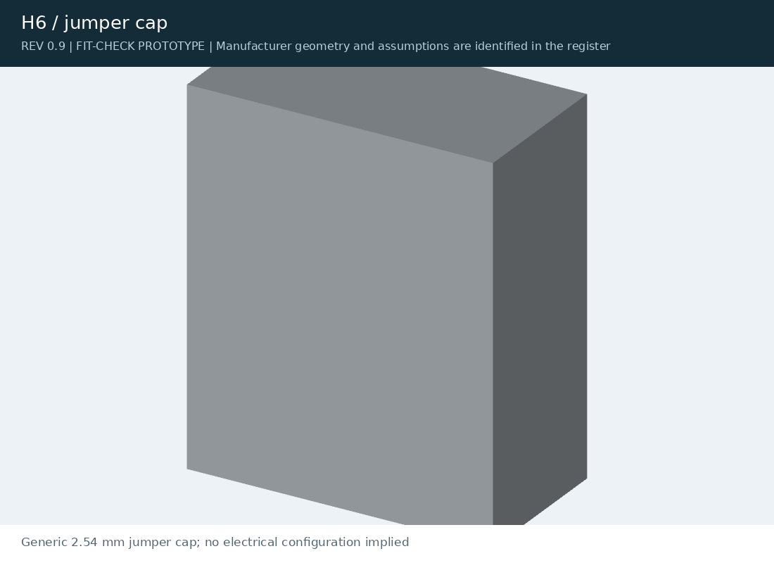
[picture p61: preview/part-jumper_cap.png]
H6 2.54 mm jumper cap
<td width="25%" valign="top"><br><b>H6</b> 2.54 mm jumper cap</td>
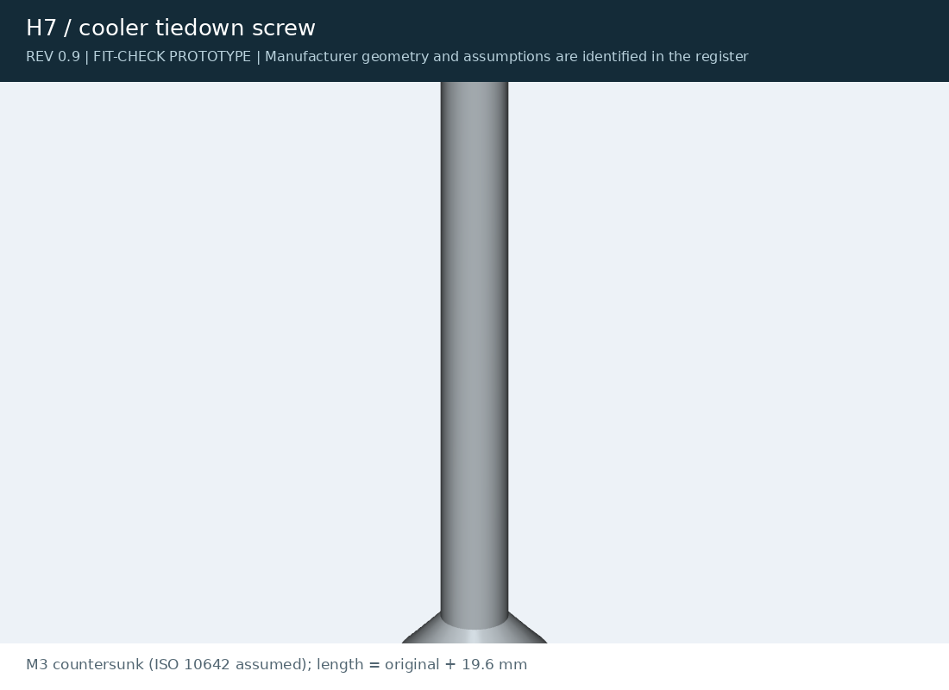
[picture p62: preview/part-cooler_tiedown_screw.png]
H7 cooler tie-down screw
<td width="25%" valign="top"><br><b>H7</b> cooler tie-down screw</td>
<td width="25%"></td>
<td width="25%"></td>
</tr>
</table>

## Carrier connectors

Connector bodies extracted from the carrier board's STEP model, used for the plate cutouts and clearance checks.

<table>
<tr>
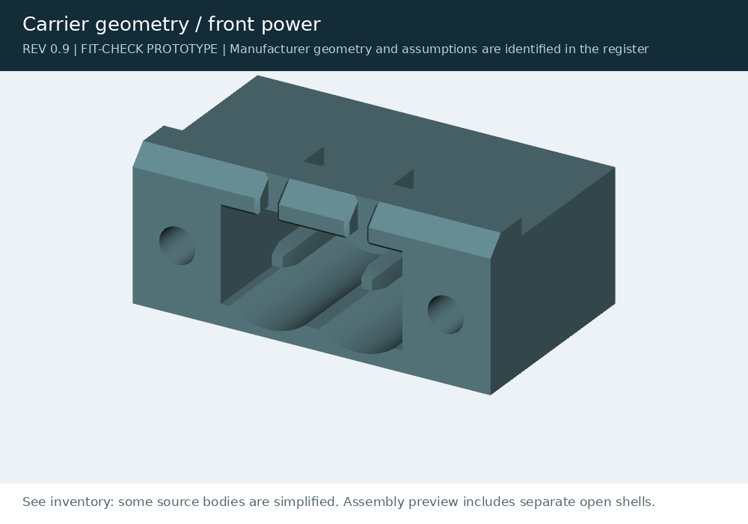
[picture p63: preview/connector-front_power.png]
DC power input
<td width="25%" valign="top"><br>DC power input</td>
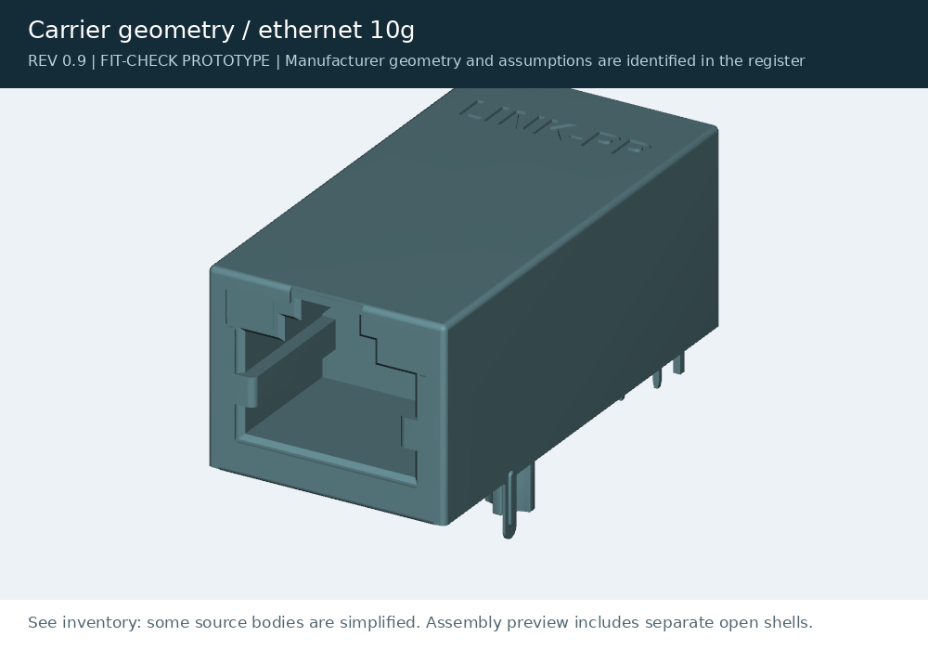
[picture p64: preview/connector-ethernet_10g.png]
10G Ethernet
<td width="25%" valign="top"><br>10G Ethernet</td>
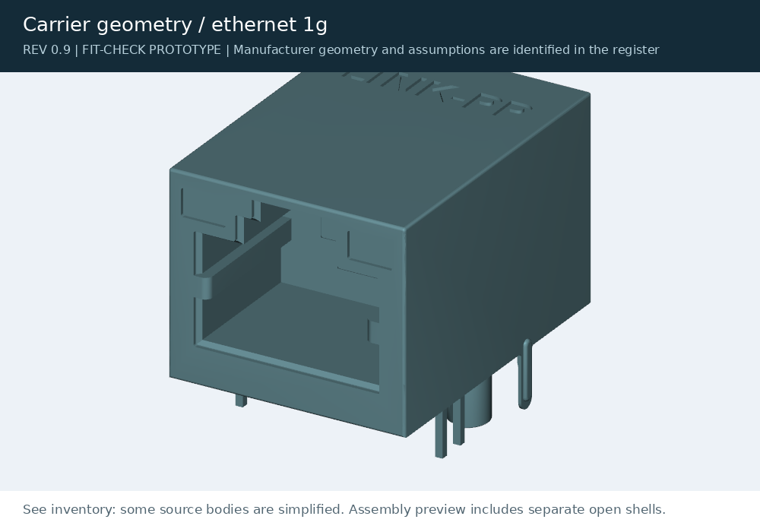
[picture p65: preview/connector-ethernet_1g.png]
1G Ethernet
<td width="25%" valign="top"><br>1G Ethernet</td>
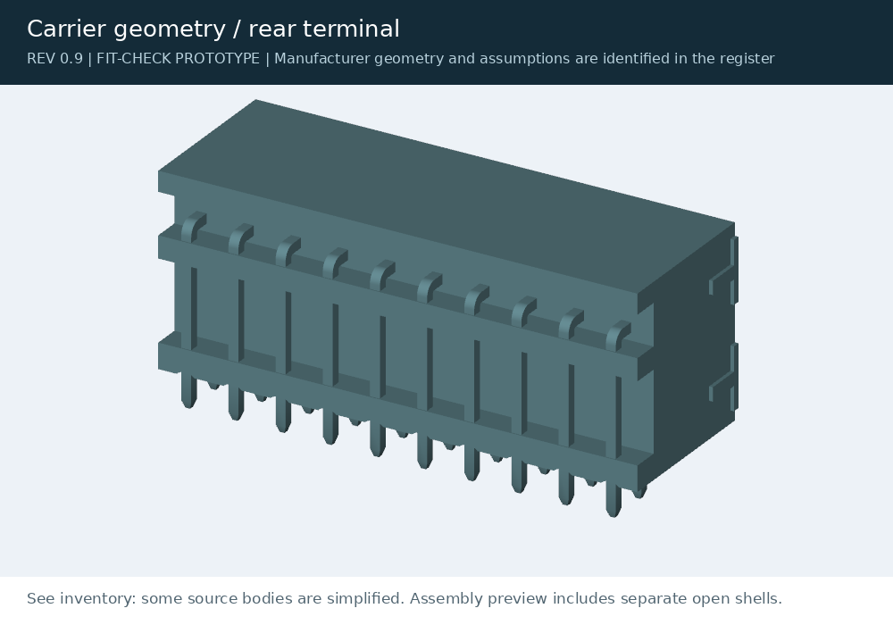
[picture p66: preview/connector-rear_terminal.png]
I/O terminal block
<td width="25%" valign="top"><br>I/O terminal block</td>
</tr>
<tr>
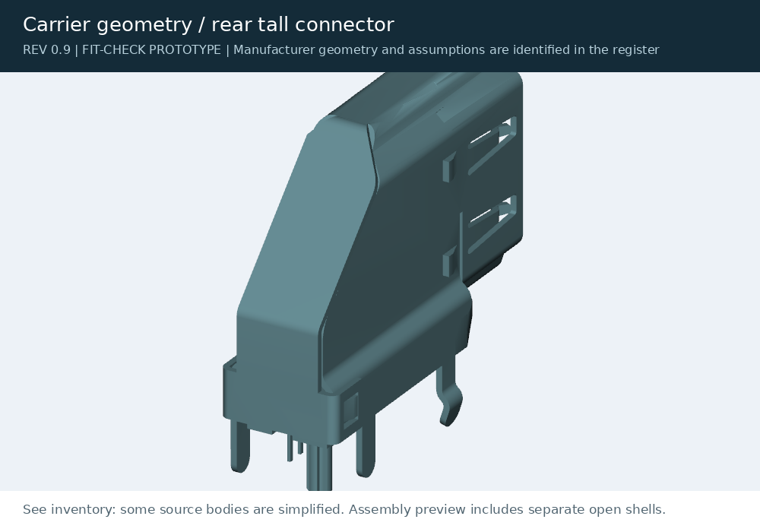
[picture p67: preview/connector-rear_tall_connector.png]
Rear tall connector
<td width="25%" valign="top"><br>Rear tall connector</td>
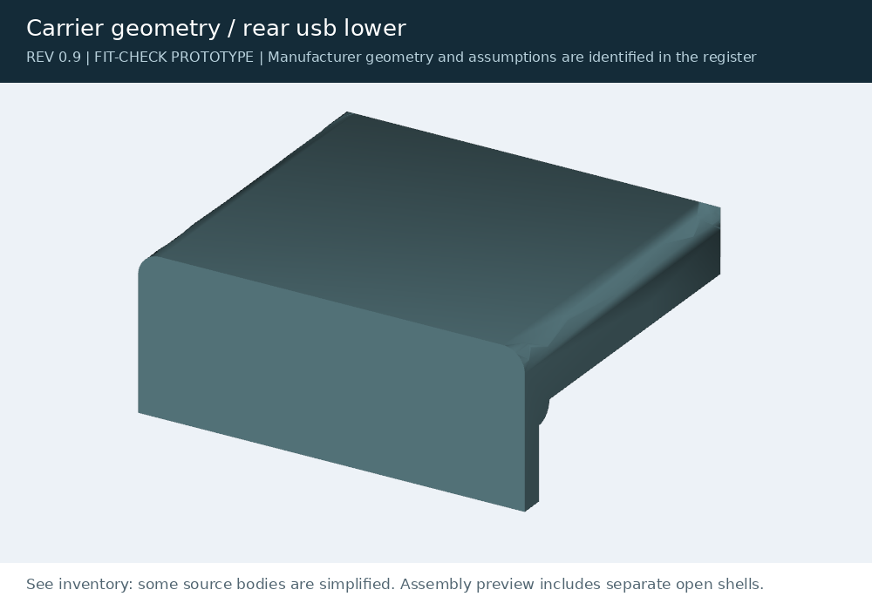
[picture p68: preview/connector-rear_usb_lower.png]
USB, lower
<td width="25%" valign="top"><br>USB, lower</td>
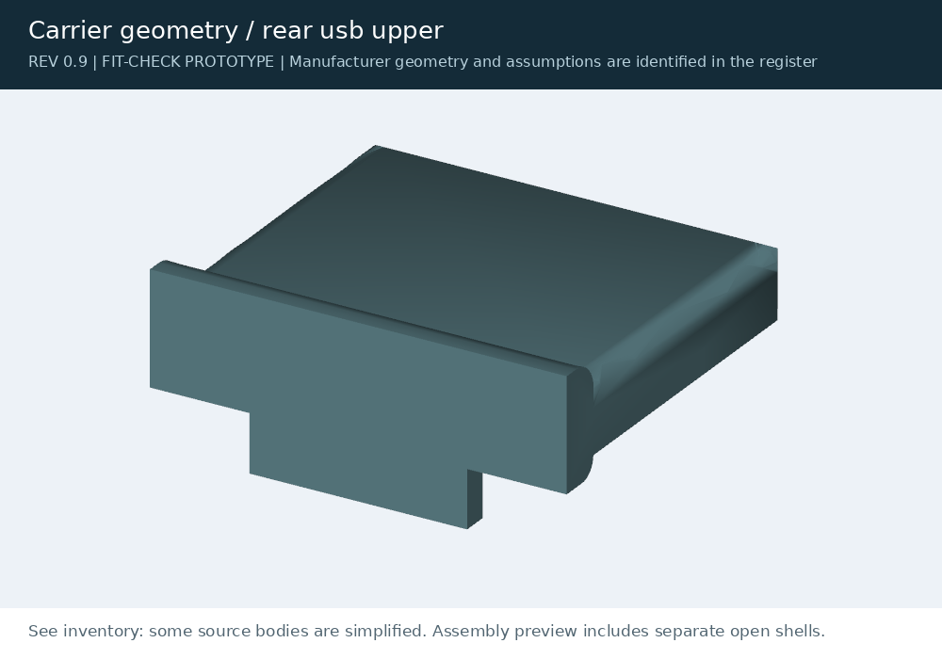
[picture p69: preview/connector-rear_usb_upper.png]
USB, upper
<td width="25%" valign="top"><br>USB, upper</td>
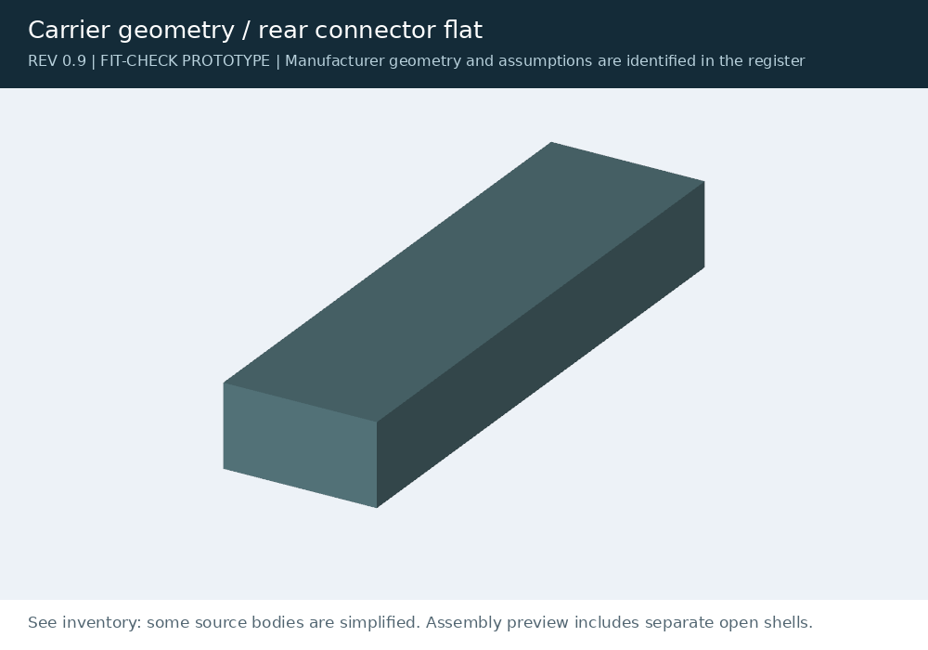
[picture p70: preview/connector-rear_connector_flat.png]
Rear flat connector
<td width="25%" valign="top"><br>Rear flat connector</td>
</tr>
<tr>
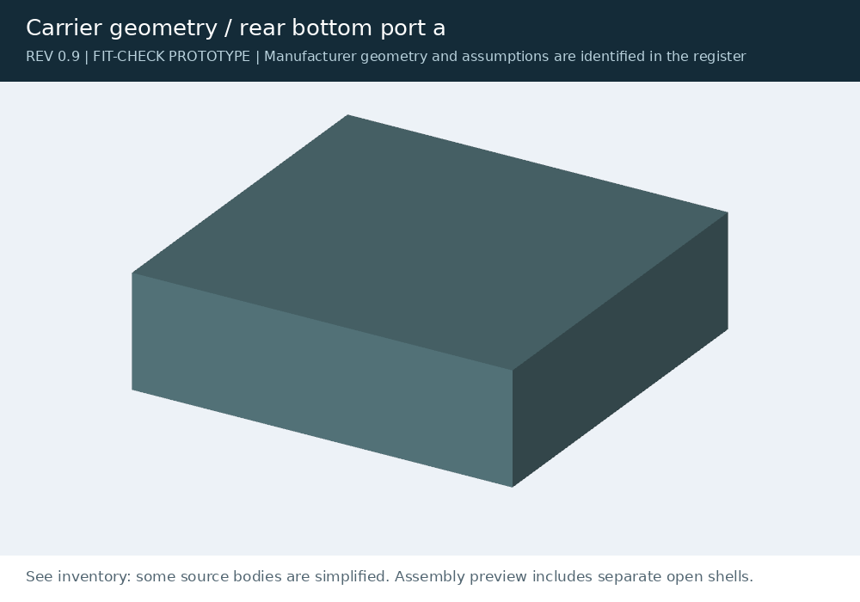
[picture p71: preview/connector-rear_bottom_port_a.png]
Rear bottom port A
<td width="25%" valign="top"><br>Rear bottom port A</td>
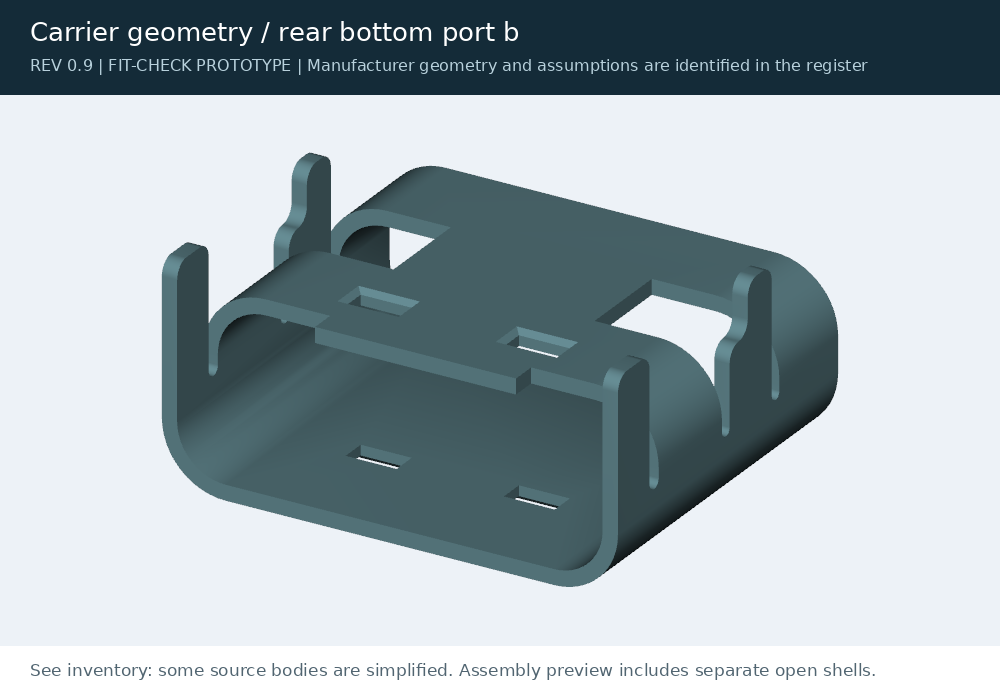
[picture p72: preview/connector-rear_bottom_port_b.png]
Rear bottom port B
<td width="25%" valign="top"><br>Rear bottom port B</td>
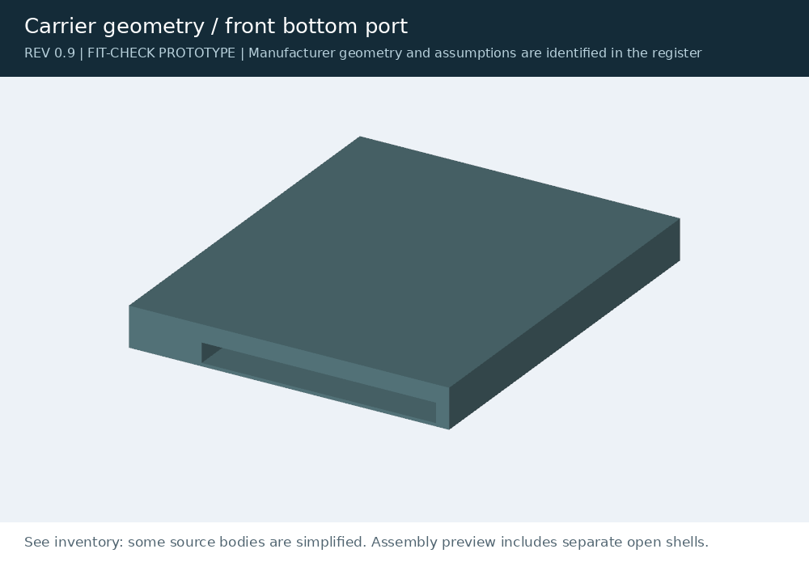
[picture p73: preview/connector-front_bottom_port.png]
J18 nano-SIM
<td width="25%" valign="top"><br>J18 nano-SIM</td>
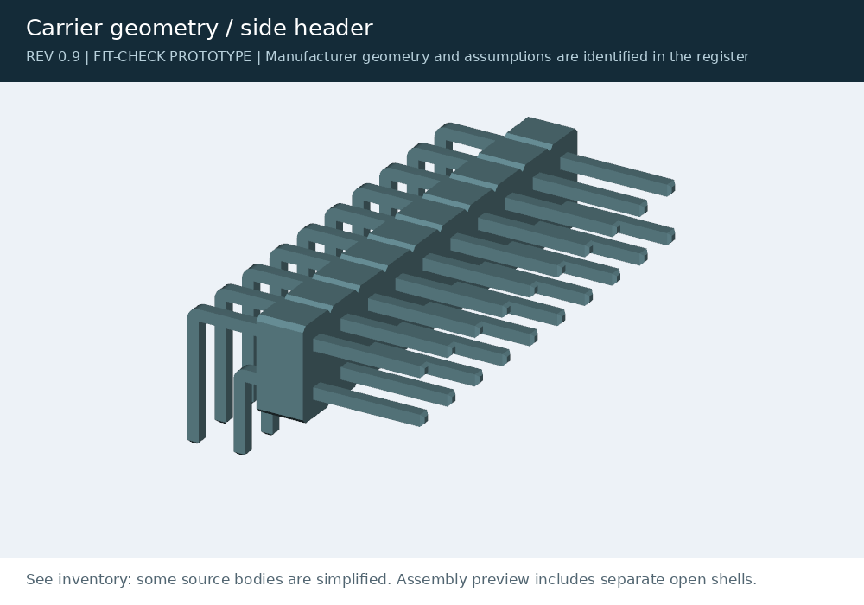
[picture p74: preview/connector-side_header.png]
J17 side header
<td width="25%" valign="top"><br>J17 side header</td>
</tr>
<tr>
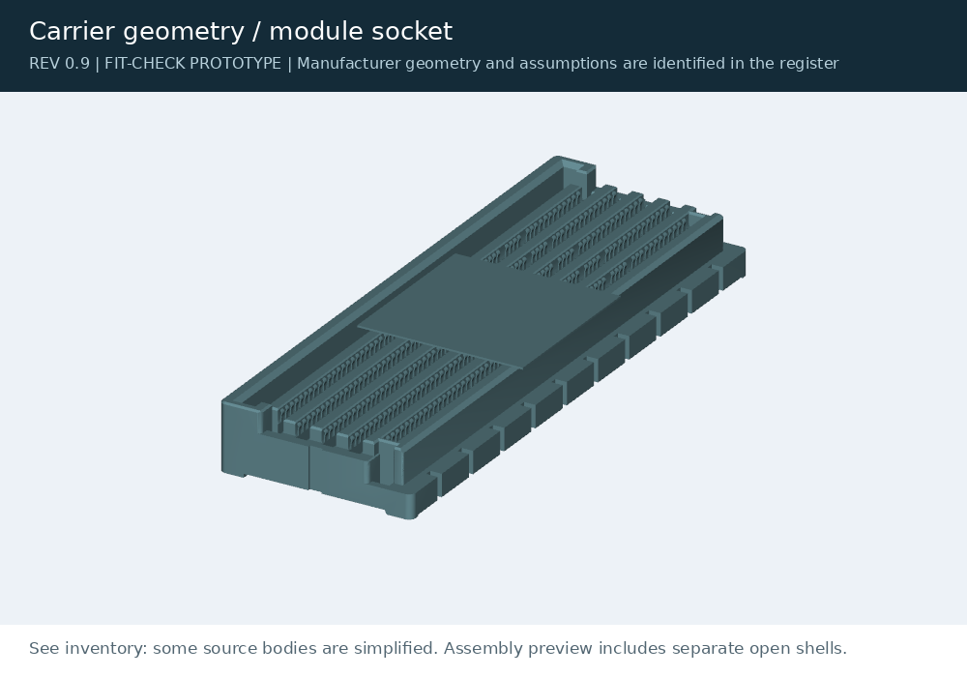
[picture p75: preview/connector-module_socket.png]
Module socket
<td width="25%" valign="top"><br>Module socket</td>
<td width="25%"></td>
<td width="25%"></td>
<td width="25%"></td>
</tr>
</table>
