mvalancy/j501-agx-orin/references/hardware/README.md

[J501 AGX Orin](../../README.md) / [references](../) / **hardware**

# Connector meshes

Meshes of the carrier board's connectors, cut out of the vendor board model by [`tools/export_hardware.py`](../../tools/export_hardware.py).
They are used for the plate cutouts, the clearance checks and the renders.

Only [`indices.json`](indices.json), which maps each connector to its solids in the board model, is in the repository. The meshes are
rebuilt by `tools/fetch_references.py`. These are the renders of each one:

<table>
<tr>
<td width="25%" valign="top"><a href="../../preview/connector-front_power.png">DC power input</a><br>DC power input</td>
<td width="25%" valign="top"><a href="../../preview/connector-ethernet_10g.png">10G Ethernet</a><br>10G Ethernet</td>
<td width="25%" valign="top"><a href="../../preview/connector-ethernet_1g.png">1G Ethernet</a><br>1G Ethernet</td>
<td width="25%" valign="top"><a href="../../preview/connector-rear_terminal.png">I/O terminal block</a><br>I/O terminal block</td>
</tr>
<tr>
<td width="25%" valign="top"><a href="../../preview/connector-rear_tall_connector.png">Rear tall connector</a><br>Rear tall connector</td>
<td width="25%" valign="top"><a href="../../preview/connector-rear_usb_lower.png">USB, lower</a><br>USB, lower</td>
<td width="25%" valign="top"><a href="../../preview/connector-rear_usb_upper.png">USB, upper</a><br>USB, upper</td>
<td width="25%" valign="top"><a href="../../preview/connector-rear_connector_flat.png">Rear flat connector</a><br>Rear flat connector</td>
</tr>
<tr>
<td width="25%" valign="top"><a href="../../preview/connector-rear_bottom_port_a.png">Rear bottom port A</a><br>Rear bottom port A</td>
<td width="25%" valign="top"><a href="../../preview/connector-rear_bottom_port_b.png">Rear bottom port B</a><br>Rear bottom port B</td>
<td width="25%" valign="top"><a href="../../preview/connector-front_bottom_port.png">J18 nano-SIM</a><br>J18 nano-SIM</td>
<td width="25%" valign="top"><a href="../../preview/connector-side_header.png">J17 side header</a><br>J17 side header</td>
</tr>
<tr>
<td width="25%" valign="top"><a href="../../preview/connector-module_socket.png">Module socket</a><br>Module socket</td>
<td width="25%"></td>
<td width="25%"></td>
<td width="25%"></td>
</tr>
</table>
