mvalancy/j501-agx-orin/.agents/inbox/README.md

# Dated engineering lessons

Each entry records the symptom, evidence, cause, corrective rule and limits. Carry entries through review with their related fix. Promote repeated procedures or failure classes into dedicated guidance when there is enough evidence to justify it.

- [2026-10-27 — Separate cooler variants and thermal seating datums](2026-10-27-cooler-datum-and-variant.md)
- [2026-10-29 — Cut every hole last, and check every hole of every part](2026-10-29-holes-cut-last.md)
- [2026-10-30 — Make exports byte-reproducible](2026-10-30-reproducible-step.md)
- [2026-11-12 — Separate antenna seating and generated bounds](2026-11-12-antenna-seating-and-envelope.md)

[Project lesson index](../README.md)
