mvalancy/j501-agx-orin/docs/cad-agent-report.html

# reServer J501 / Jetson AGX Orin enclosure · CAD verification

- project: j501-agx
- revision: rev 0.9-g48r
- generated: 2026-10-31 06:53 UTC

all pass66 pass0 fail0 skip

CAD verification onlyCAD checks only. They do not verify physical fit, print quality, slicer output, fastener engagement, thermal behaviour or load capacity.

## passPrinted parts18 pass · 0 fail · 0 skip

pass

P1 · base

P1 · base

valid single solid · watertight · 206 × 181 × 76.5 mm · fits Bambu Lab P1S bed 256 × 256 × 256 mm

pass

P1M · base mount

P1M · base mount

valid single solid · watertight · 206 × 233 × 76.5 mm · fits Bambu Lab P1S bed 256 × 256 × 256 mm

pass

P2 · cover

P2 · cover

valid single solid · watertight · 206 × 181 × 25 mm · fits Bambu Lab P1S bed 256 × 256 × 256 mm

pass

P4 · front no gmsl

P4 · front no gmsl

valid single solid · watertight · 185.5 × 67.8 × 3 mm · fits Bambu Lab P1S bed 256 × 256 × 256 mm

pass

P3 · front gmsl

P3 · front gmsl

valid single solid · watertight · 185.5 × 67.8 × 3 mm · fits Bambu Lab P1S bed 256 × 256 × 256 mm

pass

P5 · rear io

P5 · rear io

valid single solid · watertight · 185.5 × 67.8 × 5.4 mm · fits Bambu Lab P1S bed 256 × 256 × 256 mm

pass

P10 · side hatch

P10 · side hatch

valid single solid · watertight · 60.6 × 43.6 × 4 mm · fits Bambu Lab P1S bed 256 × 256 × 256 mm

pass

P9 · mount fit template

P9 · mount fit template

valid single solid · watertight · 171.979 × 151.978 × 12.01 mm · fits Bambu Lab P1S bed 256 × 256 × 256 mm

pass

P11 · m3 insert coupon

P11 · m3 insert coupon

valid single solid · watertight · 90 × 20 × 14 mm · fits Bambu Lab P1S bed 256 × 256 × 256 mm

pass

P14 · countersink coupon

P14 · countersink coupon

valid single solid · watertight · 40 × 20 × 17.248 mm · fits Bambu Lab P1S bed 256 × 256 × 256 mm

pass

P20 · rpsma coupon

P20 · rpsma coupon

valid single solid · watertight · 60 × 14 × 20 mm · fits Bambu Lab P1S bed 256 × 256 × 256 mm

pass

P12 · rail coupon

P12 · rail coupon

valid single solid · watertight · 16 × 9 × 24 mm · fits Bambu Lab P1S bed 256 × 256 × 256 mm

pass

P13 · rail key

P13 · rail key

valid single solid · watertight · 10 × 3 × 18 mm · fits Bambu Lab P1S bed 256 × 256 × 256 mm

pass

P15 · storage 35

P15 · storage 35

valid single solid · watertight · 206 × 181 × 32 mm · fits Bambu Lab P1S bed 256 × 256 × 256 mm

pass

P16 · storage 25

P16 · storage 25

valid single solid · watertight · 206 × 181 × 22 mm · fits Bambu Lab P1S bed 256 × 256 × 256 mm

pass

P17 · storage mount plate

P17 · storage mount plate

valid single solid · watertight · 206 × 233 × 11.99 mm · fits Bambu Lab P1S bed 256 × 256 × 256 mm

pass

P18 · chimney cap

P18 · chimney cap

valid single solid · watertight · 16.5 × 36.9 × 4 mm · fits Bambu Lab P1S bed 256 × 256 × 256 mm

pass

P19 · ssd clip

P19 · ssd clip

valid single solid · watertight · 10 × 11 × 10.5 mm · fits Bambu Lab P1S bed 256 × 256 × 256 mm

## passPrint files18 pass · 0 fail · 0 skip

pass

P1 · base

base.3mf

STL + 3MF (print orientation), STEP (assembly)

pass

P1M · base mount

base_mount.3mf

STL + 3MF (print orientation), STEP (assembly)

pass

P2 · cover

cover.3mf

STL + 3MF (print orientation), STEP (assembly)

pass

P4 · front no gmsl

front_no_gmsl.3mf

STL + 3MF (print orientation), STEP (assembly)

pass

P3 · front gmsl

front_gmsl.3mf

STL + 3MF (print orientation), STEP (assembly)

pass

P5 · rear io

rear_io.3mf

STL + 3MF (print orientation), STEP (assembly)

pass

P10 · side hatch

side_hatch.3mf

STL + 3MF (print orientation), STEP (assembly)

pass

P9 · mount fit template

mount_fit_template.3mf

STL + 3MF (print orientation), STEP (assembly)

pass

P11 · m3 insert coupon

m3_insert_coupon.3mf

STL + 3MF (print orientation), STEP (assembly)

pass

P14 · countersink coupon

countersink_coupon.3mf

STL + 3MF (print orientation), STEP (assembly)

pass

P20 · rpsma coupon

rpsma_coupon.3mf

STL + 3MF (print orientation), STEP (assembly)

pass

P12 · rail coupon

rail_coupon.3mf

STL + 3MF (print orientation), STEP (assembly)

pass

P13 · rail key

rail_key.3mf

STL + 3MF (print orientation), STEP (assembly)

pass

P15 · storage 35

storage_35.3mf

STL + 3MF (print orientation), STEP (assembly)

pass

P16 · storage 25

storage_25.3mf

STL + 3MF (print orientation), STEP (assembly)

pass

P17 · storage mount plate

storage_mount_plate.3mf

STL + 3MF (print orientation), STEP (assembly)

pass

P18 · chimney cap

chimney_cap.3mf

STL + 3MF (print orientation), STEP (assembly)

pass

P19 · ssd clip

ssd_clip.3mf

STL + 3MF (print orientation), STEP (assembly)

## passHoles clear18 pass · 0 fail · 0 skip

pass

P1 · base

48 hole(s) clear, 4 listed exception(s)

pass

P1M · base mount

48 hole(s) clear, 4 listed exception(s)

pass

P2 · cover

8 hole(s) clear

pass

P4 · front no gmsl

0 hole(s) clear

pass

P3 · front gmsl

0 hole(s) clear

pass

P5 · rear io

2 hole(s) clear

pass

P10 · side hatch

0 hole(s) clear

pass

P9 · mount fit template

8 hole(s) clear

pass

P11 · m3 insert coupon

5 hole(s) clear

pass

P14 · countersink coupon

4 hole(s) clear

pass

P20 · rpsma coupon

4 hole(s) clear, 4 listed exception(s)

pass

P12 · rail coupon

0 hole(s) clear

pass

P13 · rail key

0 hole(s) clear

pass

P15 · storage 35

29 hole(s) clear, 4 ledge(s) between coaxial bores (confirm they are designed)

pass

P16 · storage 25

32 hole(s) clear, 4 ledge(s) between coaxial bores (confirm they are designed)

pass

P17 · storage mount plate

8 hole(s) clear

pass

P18 · chimney cap

0 hole(s) clear

pass

P19 · ssd clip

1 hole(s) clear

## passDesign checks8 pass · 0 fail · 0 skip

pass

carrier · Carrier and hardware clearances

Carrier and hardware clearances

pass true in exports/carrier-clearances.json

pass

shells · Open-shell clearances

exports/shell-clearances.json

pass true in exports/shell-clearances.json

pass

paths · Plate insertion paths

Plate insertion paths

pass true in exports/assembly-paths.json

pass

ports · Mated plug fit at every port

Mated plug fit at every port

pass true in exports/port-checks.json

pass

mounts · Mounting tabs and driver access

Mounting tabs and driver access

pass true in exports/mount-checks.json

pass

storage · Storage trays, cable routes and underside slots

Storage trays, cable routes and underside slots

pass true in exports/storage-checks.json

pass

simulation · Strength, airflow and filament (simulation)

Strength, airflow and filament (simulation)

pass true in exports/simulation-checks.json

pass

review · Review validation

exports/review-validation.json

all_parts_single_valid_watertight, plastic_intersections_zero, carrier_and_hardware_pass, open_shell_pass, port_plug_fit_pass, mount_checks_pass, storage_checks_pass, assembly_paths_pass, nominal_P1S_bounds_pass true in exports/review-validation.json · physical fit not verified

## passReview pages and links4 pass · 0 fail · 0 skip

pass

preview/index.html

all local links resolve

pass

README.md

all local links resolve

pass

ASSEMBLY.md

all local links resolve

pass

docs/engineering-review.html

all local links resolve

## Print files

STL and 3MF are in print orientation (3MF centred on the bed); STEP is in assembly coordinates.

| Part | STL | 3MF | STEP | Slicer
base | P1 · base | STL | 3MF | STEP | 3MF (serve over http for Bambu Studio)
base_mount | P1M · base mount | STL | 3MF | STEP | 3MF (serve over http for Bambu Studio)
cover | P2 · cover | STL | 3MF | STEP | 3MF (serve over http for Bambu Studio)
front_no_gmsl | P4 · front no gmsl | STL | 3MF | STEP | 3MF (serve over http for Bambu Studio)
front_gmsl | P3 · front gmsl | STL | 3MF | STEP | 3MF (serve over http for Bambu Studio)
rear_io | P5 · rear io | STL | 3MF | STEP | 3MF (serve over http for Bambu Studio)
side_hatch | P10 · side hatch | STL | 3MF | STEP | 3MF (serve over http for Bambu Studio)
mount_fit_template | P9 · mount fit template | STL | 3MF | STEP | 3MF (serve over http for Bambu Studio)
m3_insert_coupon | P11 · m3 insert coupon | STL | 3MF | STEP | 3MF (serve over http for Bambu Studio)
countersink_coupon | P14 · countersink coupon | STL | 3MF | STEP | 3MF (serve over http for Bambu Studio)
rpsma_coupon | P20 · rpsma coupon | STL | 3MF | STEP | 3MF (serve over http for Bambu Studio)
rail_coupon | P12 · rail coupon | STL | 3MF | STEP | 3MF (serve over http for Bambu Studio)
rail_key | P13 · rail key | STL | 3MF | STEP | 3MF (serve over http for Bambu Studio)
storage_35 | P15 · storage 35 | STL | 3MF | STEP | 3MF (serve over http for Bambu Studio)
storage_25 | P16 · storage 25 | STL | 3MF | STEP | 3MF (serve over http for Bambu Studio)
storage_mount_plate | P17 · storage mount plate | STL | 3MF | STEP | 3MF (serve over http for Bambu Studio)
chimney_cap | P18 · chimney cap | STL | 3MF | STEP | 3MF (serve over http for Bambu Studio)
ssd_clip | P19 · ssd clip | STL | 3MF | STEP | 3MF (serve over http for Bambu Studio)

- checks: 66 pass / 0 fail / 0 skip
- physical fit: physical fit NOT verified (CAD only)
- slicer: sliced (Bambu Studio (command line)): 1014.5 g, 28.65 h for 18 part(s), 0.20mm Standard @BBL X1C, Bambu PLA Basic @BBL P1S 0.4 nozzle
