mvalancy/j501-agx-orin/archive/rev02/README.md

[J501 AGX Orin](../../README.md) / [archive](../) / **rev02**

# Rev 0.2: first fit-check build

The first fit-check version. Mounting ears (P6) and desktop feet (P7) were separate printed parts, and the board sat on metal M3 spacers.
Superseded; the current parts are in [`exports/`](../../exports/).

<table>
<tr>
<td width="33%" valign="top"><a href="preview/part-mount_ear.png">P6 mounting ear</a><br><b>P6</b> mounting ear</td>
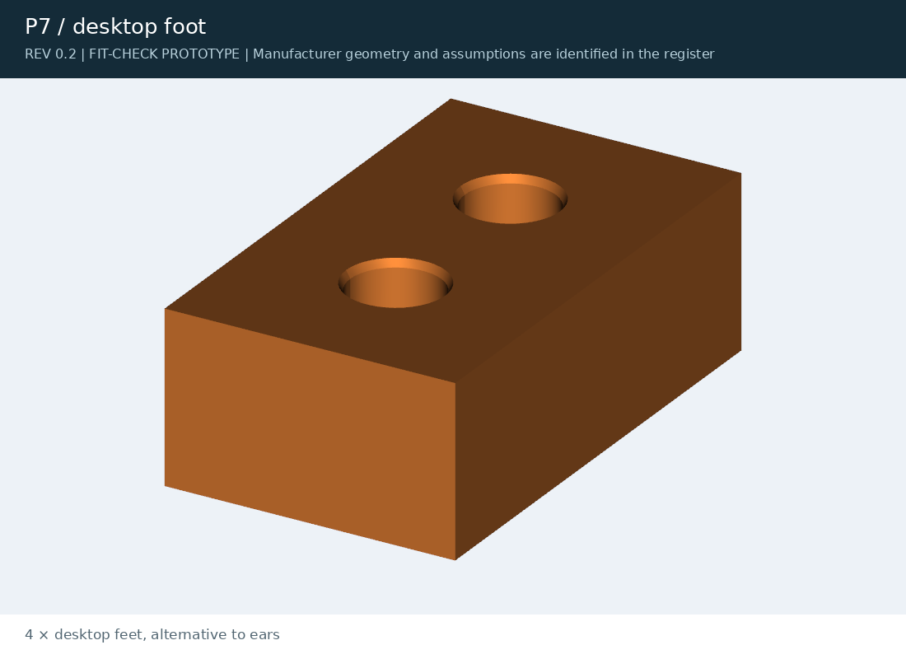
[picture p82: archive/rev02/preview/part-desktop_foot.png]
P7 desktop foot
<td width="33%" valign="top"><br><b>P7</b> desktop foot</td>
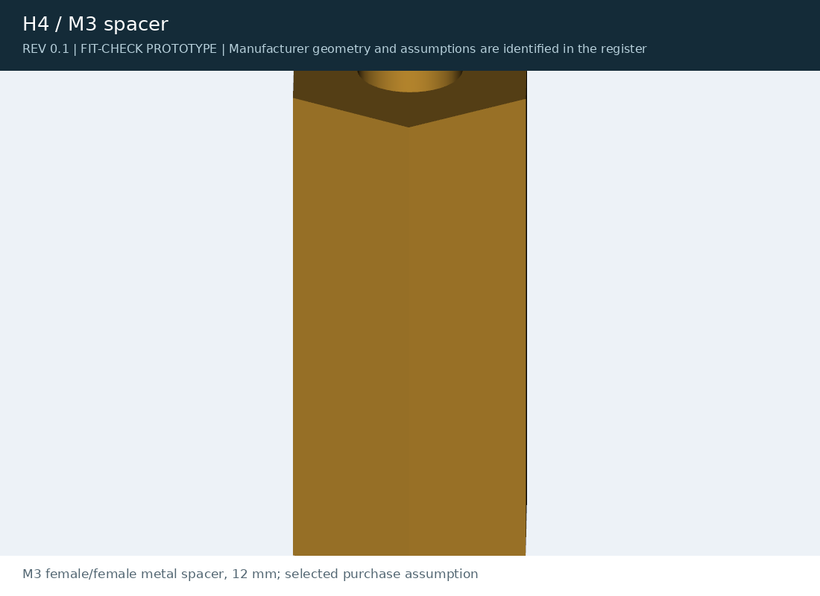
[picture p83: archive/rev02/preview/part-M3_spacer.png]
H4 M3 spacer
<td width="33%" valign="top"><br><b>H4</b> M3 spacer</td>
</tr>
</table>

| File | What it is |
|---|---|
| [`parameters.json`](parameters.json) | Rev 0.2 dimensions |
| [`build.py`](build.py), [`hardware.py`](hardware.py), [`render.py`](render.py) | Rev 0.2 source |
| [`exports/`](exports/) | The ear and foot print files |
| [`preview/`](preview/) | Renders of the parts that changed |

## Folders

| Folder | What is in it |
|---|---|
| [`exports/`](exports/) | Rev 0.2 print files |
| [`preview/`](preview/) | Rev 0.2 renders |
