mvalancy/j501-agx-orin/archive/rev03/README.md

[J501 AGX Orin](../../README.md) / [archive](../) / **rev03**

# Rev 0.3: print review

A print-review pass on Rev 0.2. It added the rail coupon and key (now P12 and P13) and vents. Only the source and parameters were kept; there are no renders or print files.

| File | What it is |
|---|---|
| [`parameters.json`](parameters.json) | Rev 0.3 dimensions |
| [`build.py`](build.py) | Rev 0.3 source |

See [Rev 0.4](../rev04/) for the next version with pictures, or [`exports/`](../../exports/) for the current parts.
