mvalancy/j501-agx-orin/archive/rev04/README.md

[J501 AGX Orin](../../README.md) / [archive](../) / **rev04**

# Rev 0.4: open ribbed lid

An open ribbed lid, a rounded shell and larger mounting tabs held with M6 inserts. Superseded by Rev 0.6, which has a flush shell, a hex
roof, cooler tie-down columns and drive trays. The current parts are in [`exports/`](../../exports/).

<table>
<tr>
<td width="33%" valign="top"><a href="preview/assembled.png">Assembled</a><br><b>Assembled</b></td>
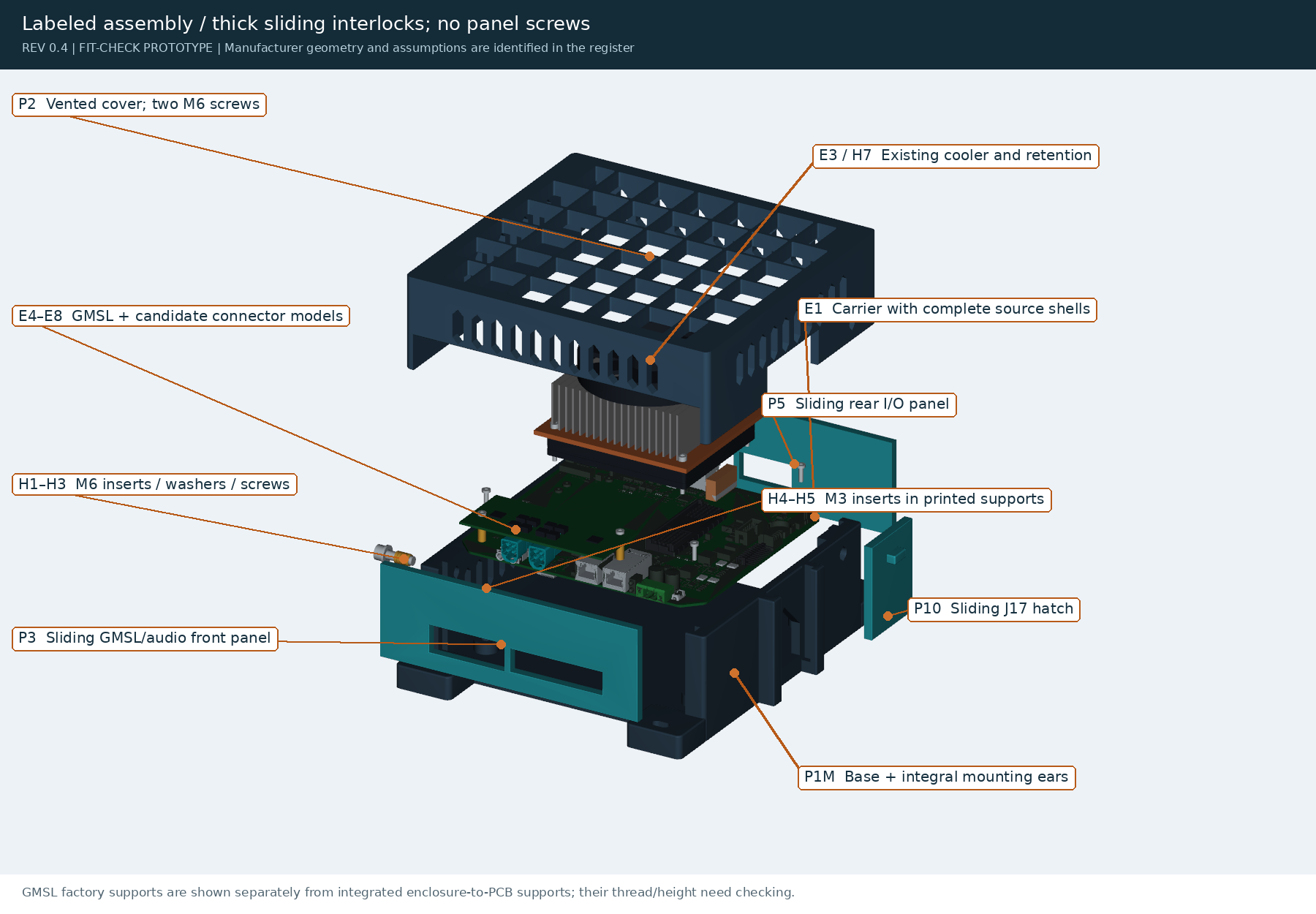
[picture p84: archive/rev04/preview/exploded.png]
Exploded
<td width="33%" valign="top"><br><b>Exploded</b></td>
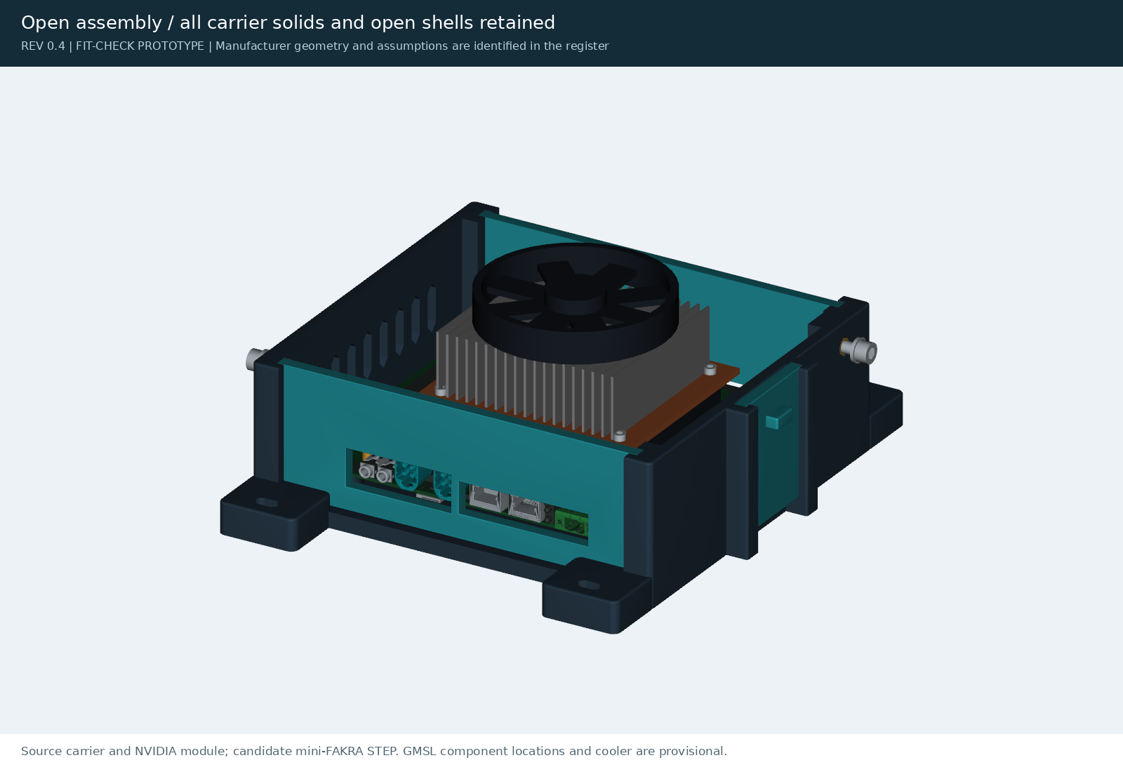
[picture p85: archive/rev04/preview/open.png]
Open
<td width="33%" valign="top"><br><b>Open</b></td>
</tr>
</table>

| File | What it is |
|---|---|
| [`parameters.json`](parameters.json) | Rev 0.4 dimensions |
| [`build.py`](build.py), [`hardware.py`](hardware.py) | Rev 0.4 source |
| `assembly_paths.py`, `check_*.py`, `design_metrics.py`, `render.py`, `write_docs.py` | The Rev 0.4 versions of the [`tools/`](../../tools/) scripts |
| [`exports/`](exports/) | Rev 0.4 check results, the insert coupon and the Rev 0.3 and 0.4 review zips |
| [`preview/`](preview/) | All the Rev 0.4 renders |

## Folders

| Folder | What is in it |
|---|---|
| [`exports/`](exports/) | Rev 0.4 check results and review packages |
| [`preview/`](preview/) | Rev 0.4 renders |
