mvalancy/j501-agx-orin/archive/rev02/exports/README.md

[J501 AGX Orin](../../../README.md) / [archive](../../) / [rev02](../) / **exports**

# Rev 0.2 print files

Superseded parts, kept for reference. The current print files are in [`exports/`](../../../exports/).

<table>
<tr>
<td width="50%" valign="top"><a href="mount_ear.stl">P6 mounting ear: STL · STEP</a><br><b>P6</b> mounting ear: <a href="mount_ear.stl">STL</a> · <a href="mount_ear.step?raw=true">STEP</a></td>
<td width="50%" valign="top"><a href="desktop_foot.stl">P7 desktop foot: STL · STEP</a><br><b>P7</b> desktop foot: <a href="desktop_foot.stl">STL</a> · <a href="desktop_foot.step?raw=true">STEP</a></td>
</tr>
</table>
