mvalancy/j501-agx-orin/archive/rev02/preview/README.md

[J501 AGX Orin](../../../README.md) / [archive](../../) / [rev02](../) / **preview**

# Rev 0.2 renders

<table>
<tr>
<td width="33%" valign="top"><a href="part-mount_ear.png">P6 mounting ear</a><br><b>P6</b> mounting ear</td>
<td width="33%" valign="top"><a href="part-desktop_foot.png">P7 desktop foot</a><br><b>P7</b> desktop foot</td>
<td width="33%" valign="top"><a href="part-M3_spacer.png">H4 M3 × 12 spacer</a><br><b>H4</b> M3 × 12 spacer</td>
</tr>
<tr>
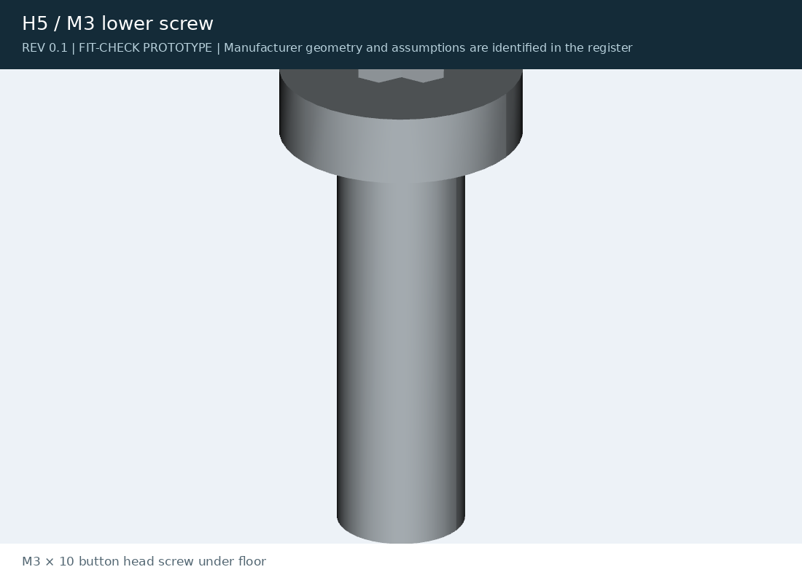
[picture p86: archive/rev02/preview/part-M3_lower_screw.png]
H5 M3 × 10 screw under the floor
<td width="33%" valign="top"><br><b>H5</b> M3 × 10 screw under the floor</td>
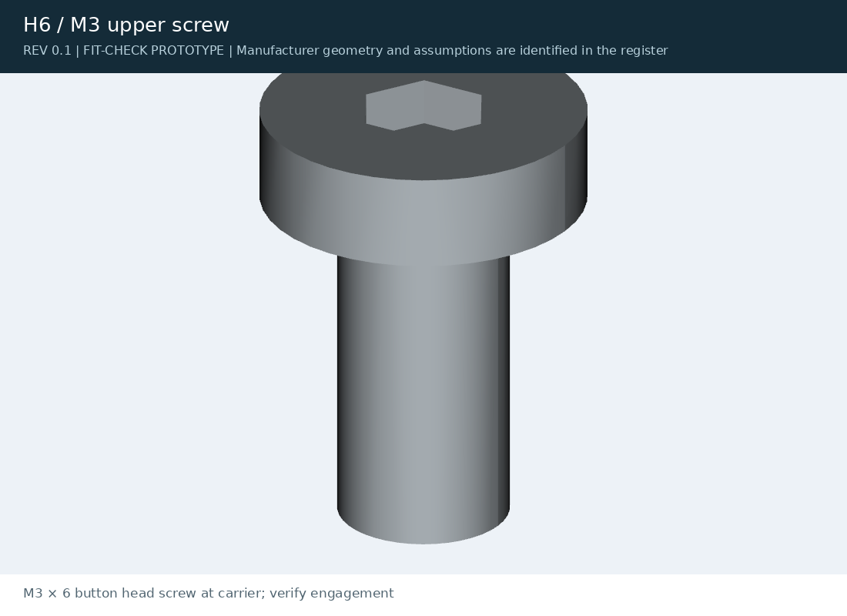
[picture p87: archive/rev02/preview/part-M3_upper_screw.png]
H6 M3 × 6 screw at the carrier
<td width="33%" valign="top"><br><b>H6</b> M3 × 6 screw at the carrier</td>
<td width="33%"></td>
</tr>
</table>
