mvalancy/j501-agx-orin/preview/cooler-fit.png

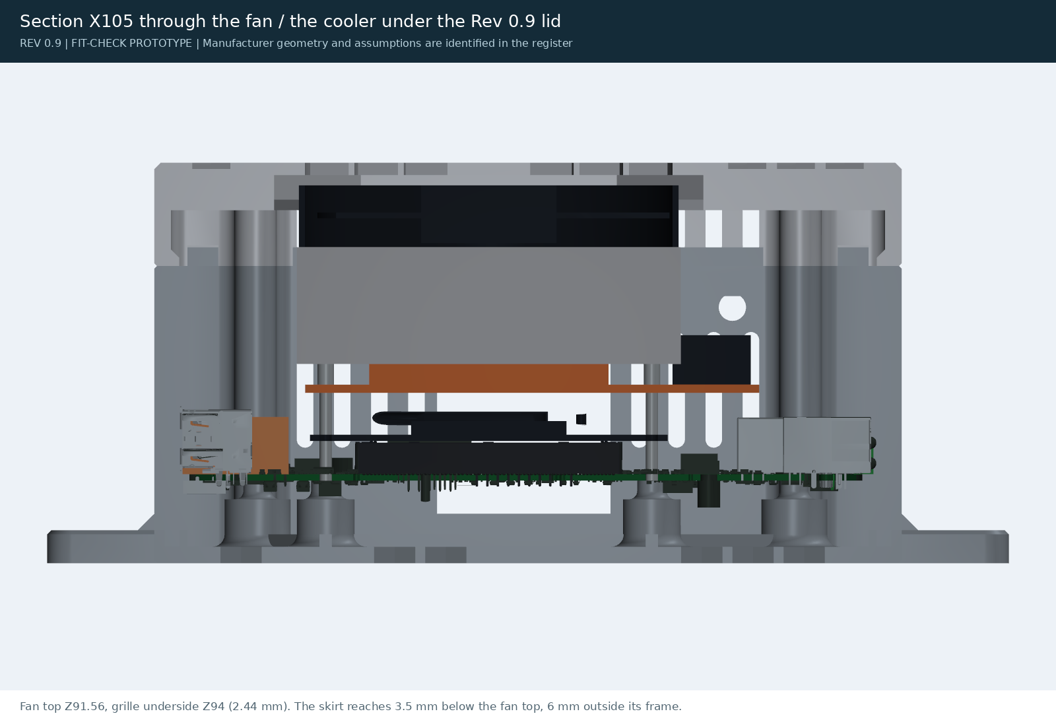
preview/cooler-fit.png
