mvalancy/j501-agx-orin/preview/cooler-study-side.png

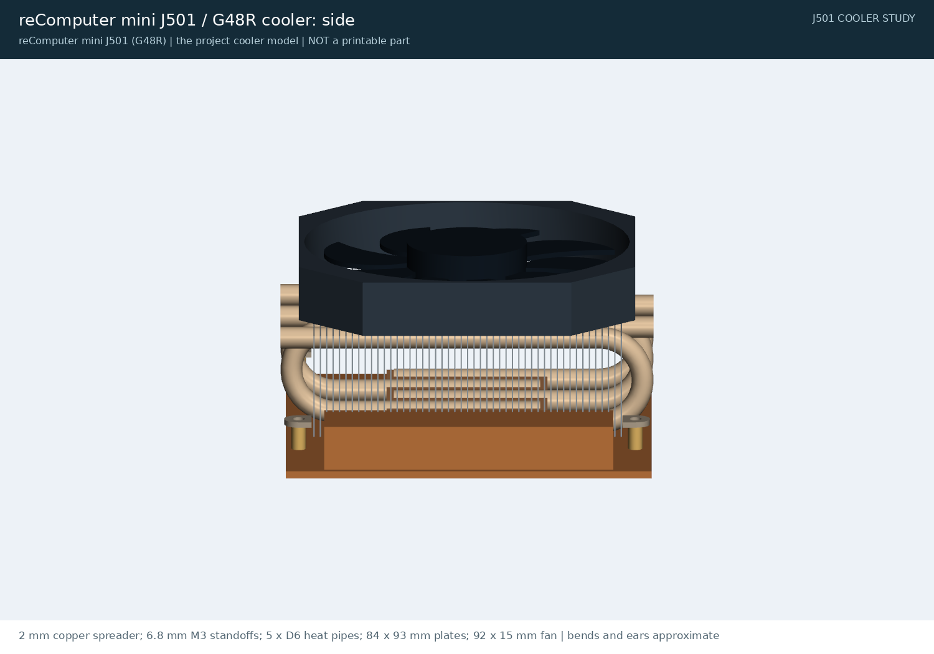
preview/cooler-study-side.png
