mvalancy/j501-agx-orin/preview/cooler-study-top.png

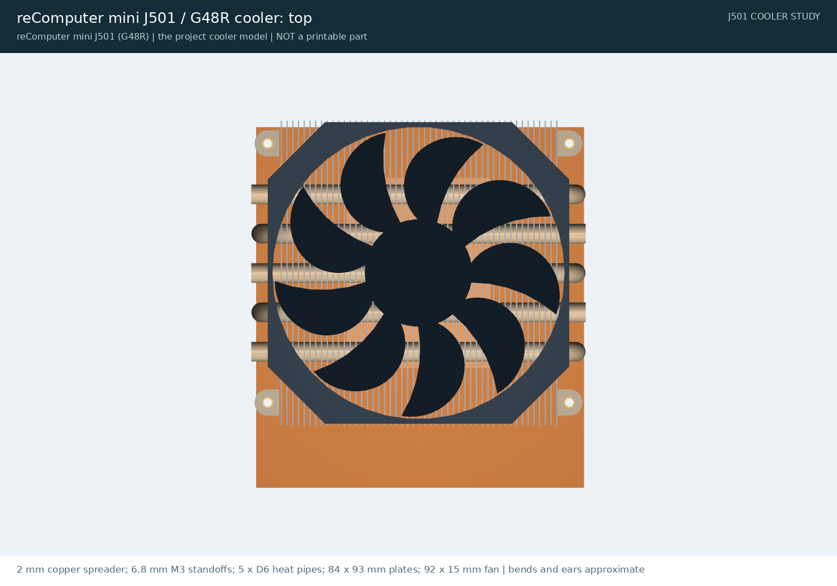
preview/cooler-study-top.png
