mvalancy/j501-agx-orin/preview/heatsink-study.png

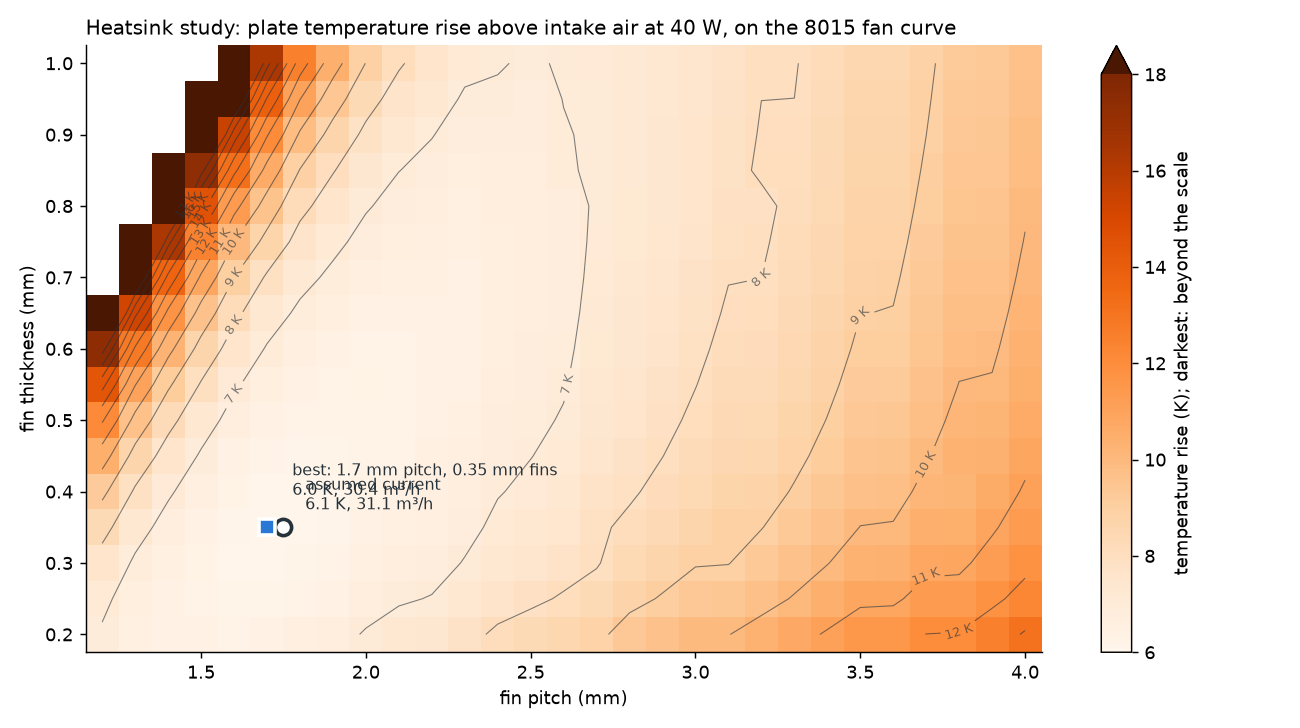
preview/heatsink-study.png
