mvalancy/j501-agx-orin/preview/lid-sweep-0.9.png

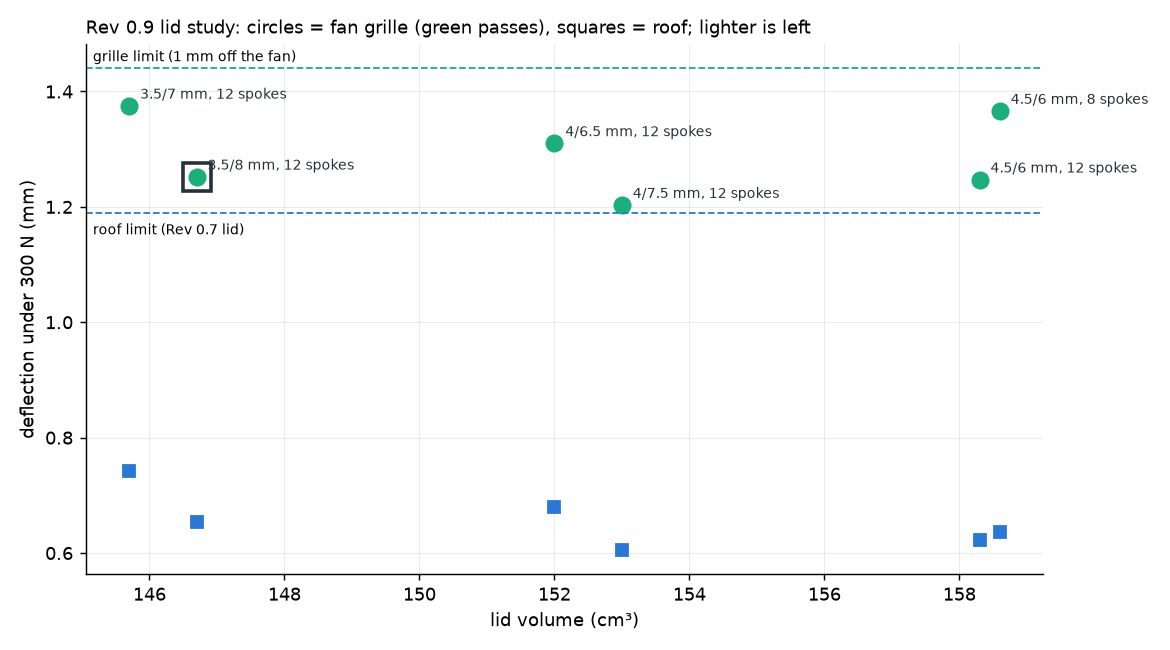
preview/lid-sweep-0.9.png
