mvalancy/j501-agx-orin/preview/roof-sweep.png

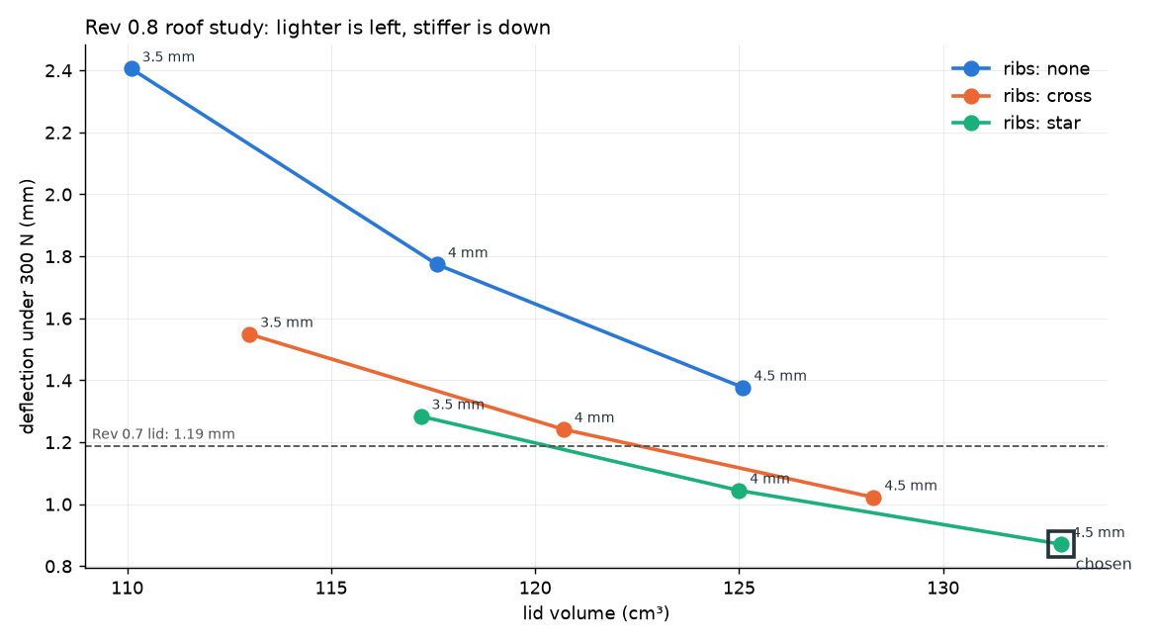
preview/roof-sweep.png
