mvalancy/j501-agx-orin/preview/structure-base_mount-0.8.png

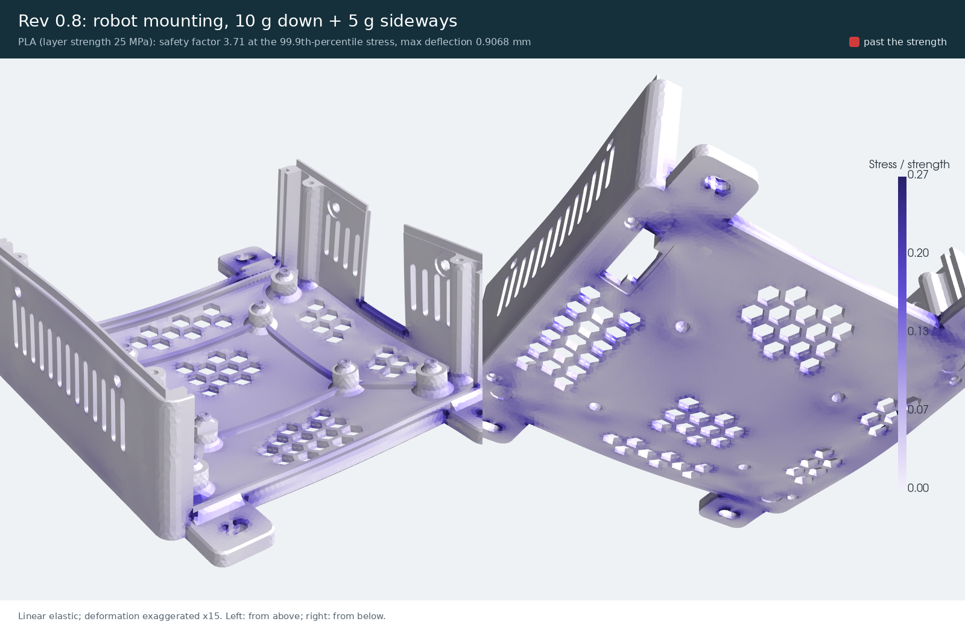
preview/structure-base_mount-0.8.png
