mvalancy/j501-agx-orin/preview/structure-lid_press-0.7.png

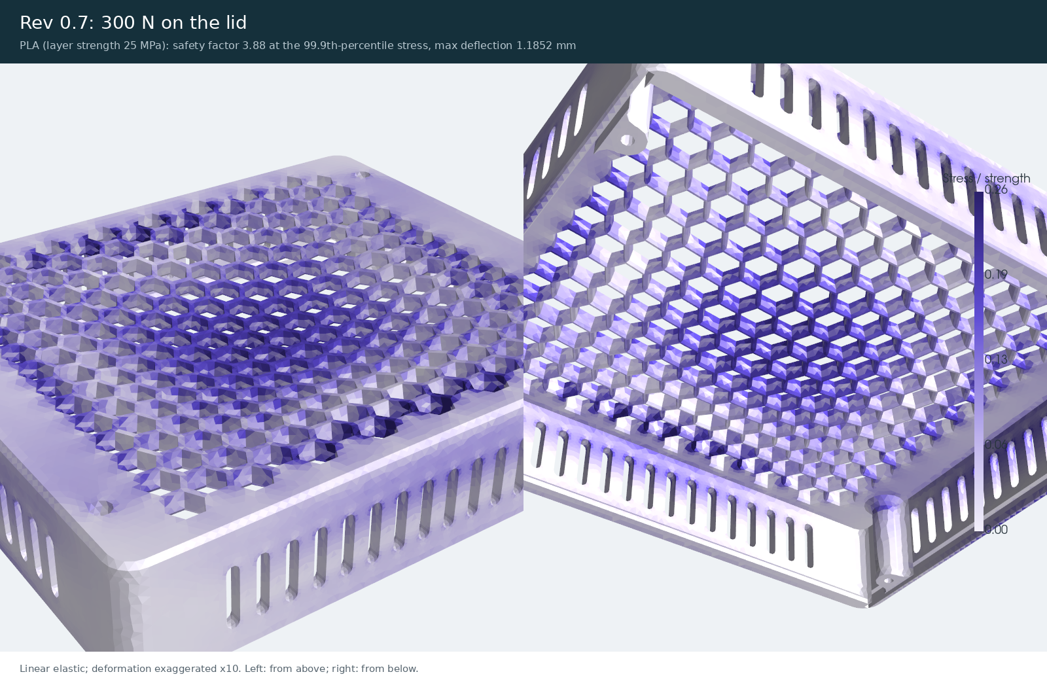
preview/structure-lid_press-0.7.png
