mvalancy/j501-agx-orin/preview/structure-lid_press-0.9.png

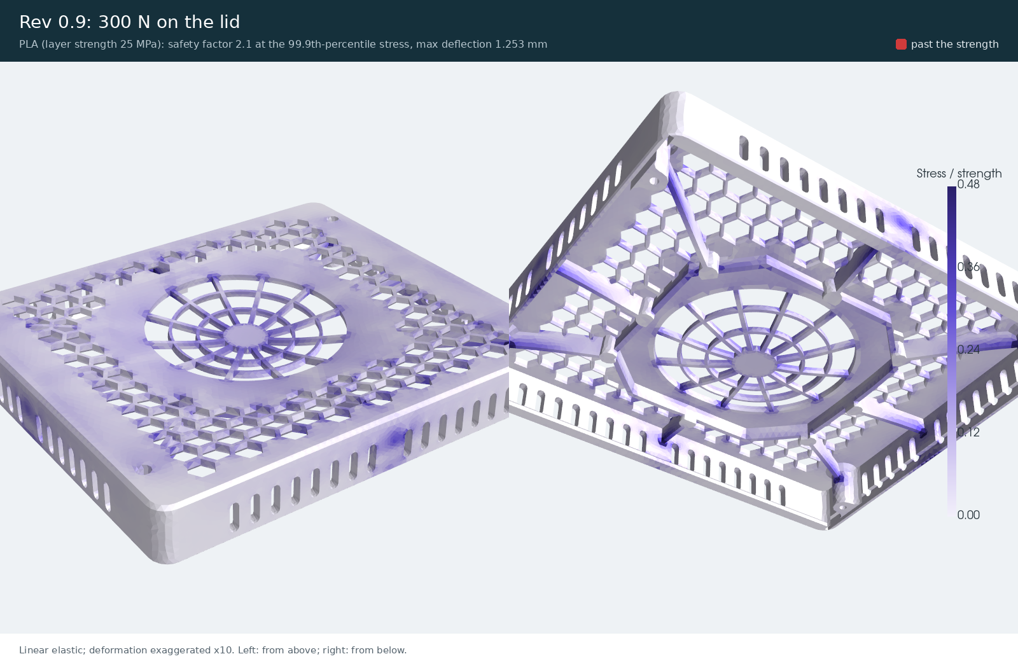
preview/structure-lid_press-0.9.png
