mvalancy/j501-agx-orin/preview/thermal/bare15-convergence.png

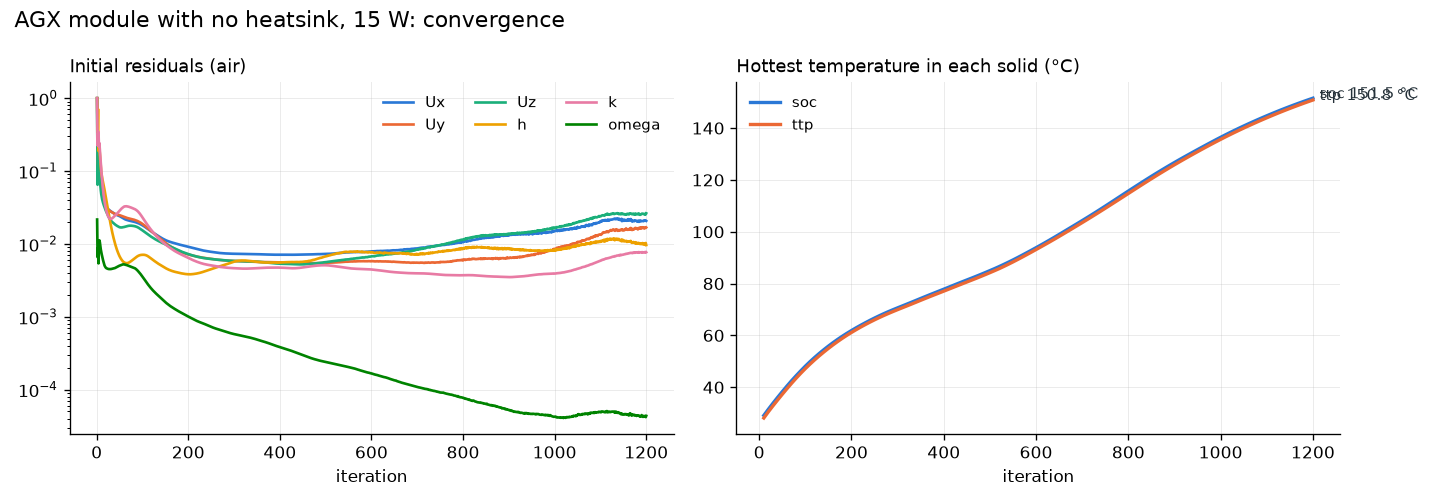
preview/thermal/bare15-convergence.png
