mvalancy/j501-agx-orin/preview/thermal/bare15-flow.png

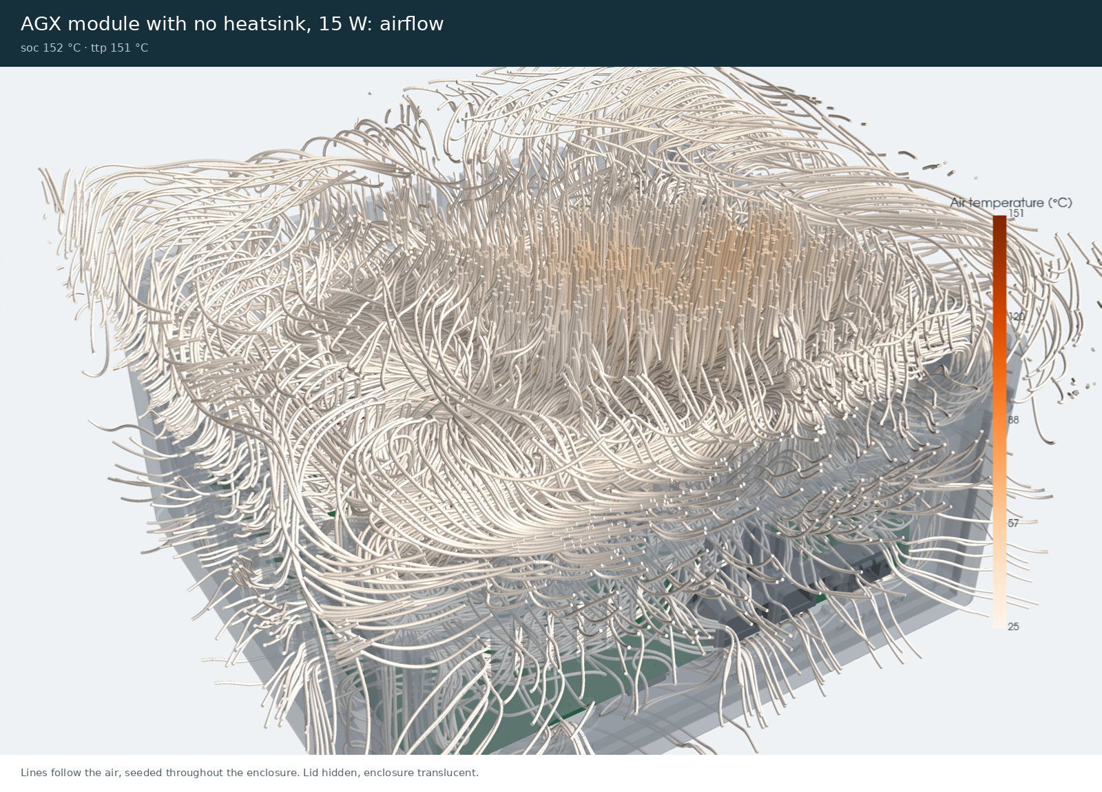
preview/thermal/bare15-flow.png
