mvalancy/j501-agx-orin/preview/thermal/bare15-section-x.png

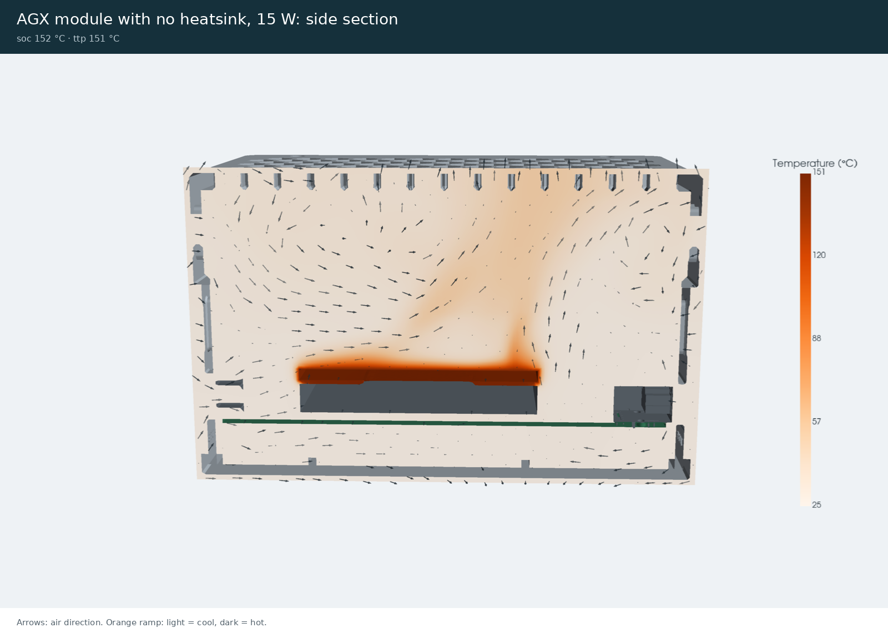
preview/thermal/bare15-section-x.png
