mvalancy/j501-agx-orin/preview/thermal/bare15-section-y.png

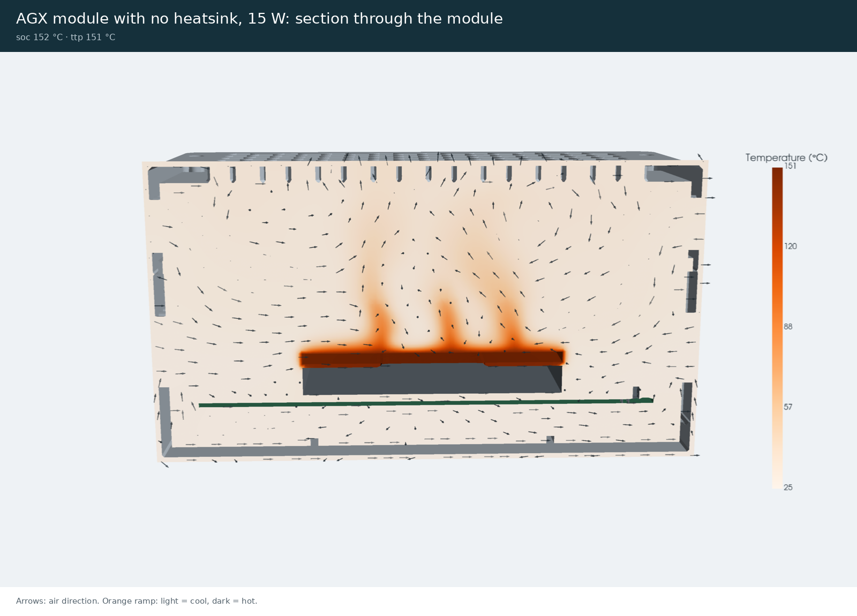
preview/thermal/bare15-section-y.png
