mvalancy/j501-agx-orin/preview/thermal/bare15-walls.png

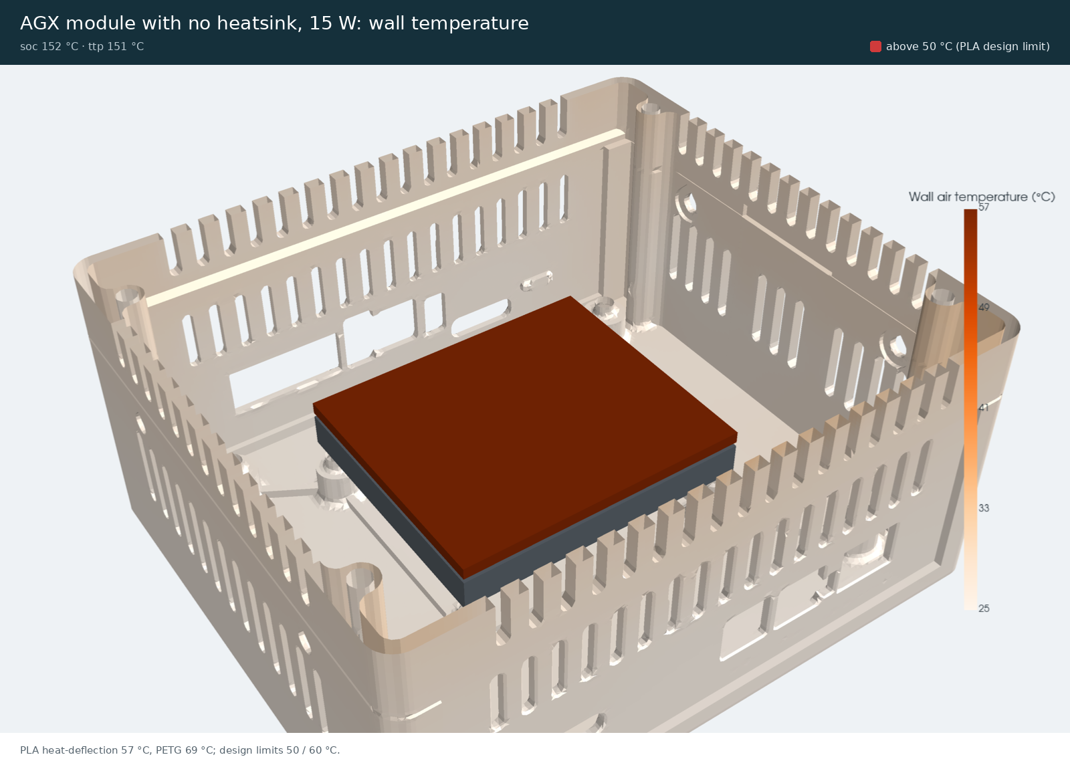
preview/thermal/bare15-walls.png
