mvalancy/j501-agx-orin/preview/thermal/cooled-0.8-section-y.png

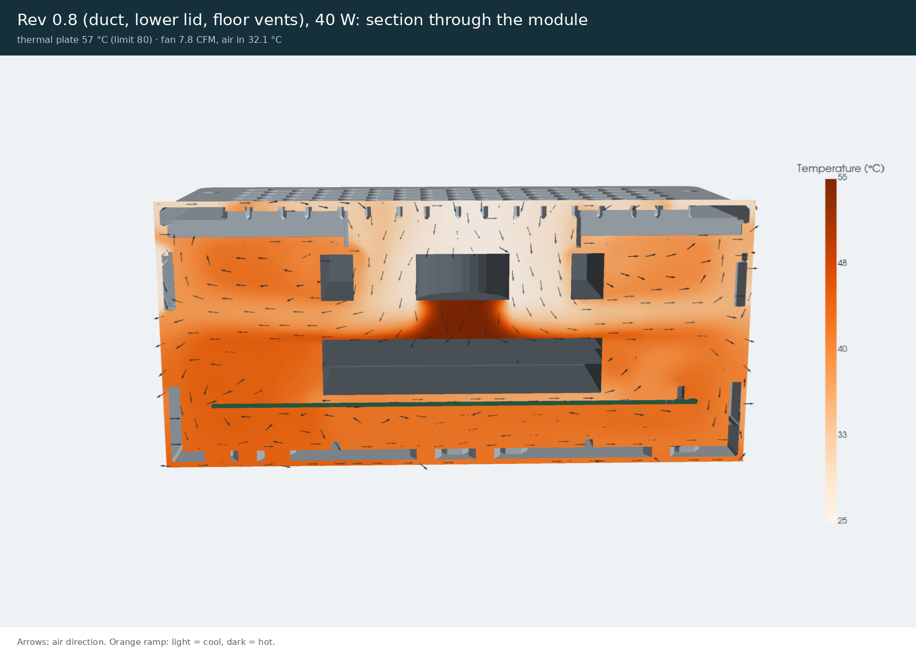
preview/thermal/cooled-0.8-section-y.png
