mvalancy/j501-agx-orin/preview/thermal/cooled-0.8-walls.png

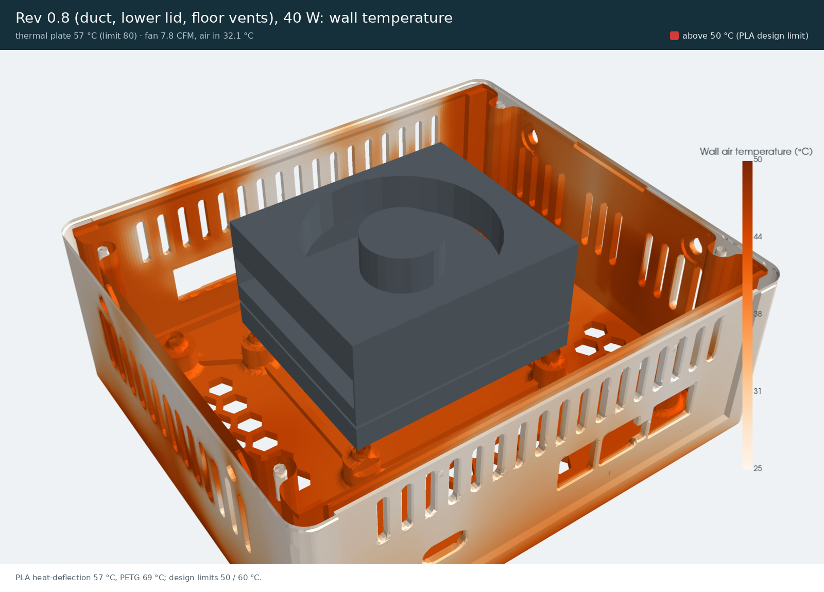
preview/thermal/cooled-0.8-walls.png
