mvalancy/j501-agx-orin/preview/thermal/cooled-0.9-convergence.png

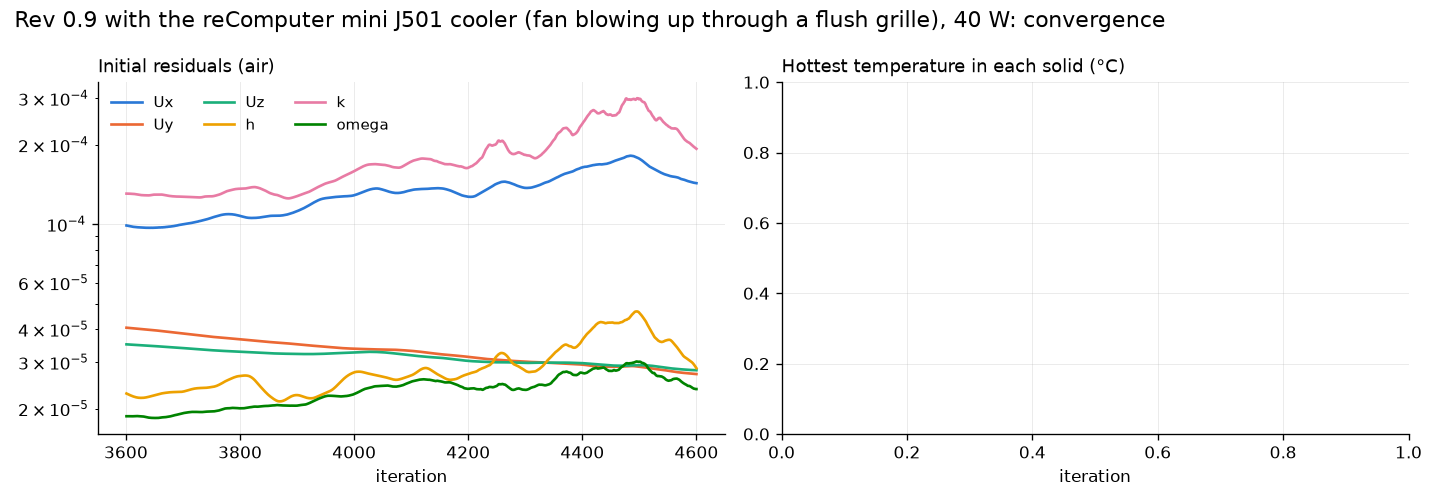
preview/thermal/cooled-0.9-convergence.png
