mvalancy/j501-agx-orin/preview/thermal/cooled-0.9-section-x.png

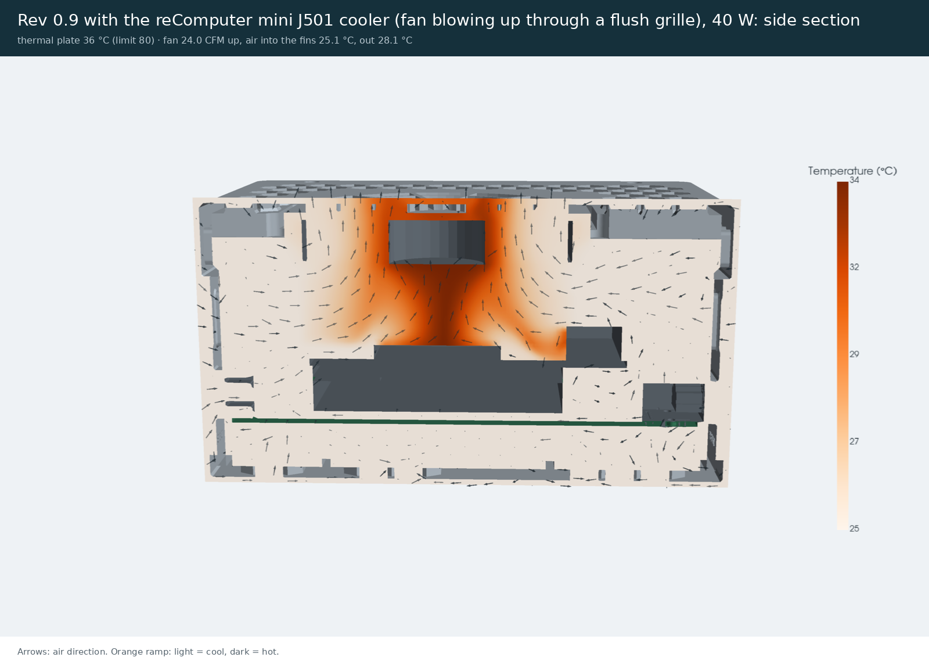
preview/thermal/cooled-0.9-section-x.png
