mvalancy/j501-agx-orin/preview/thermal/cooled-convergence.png

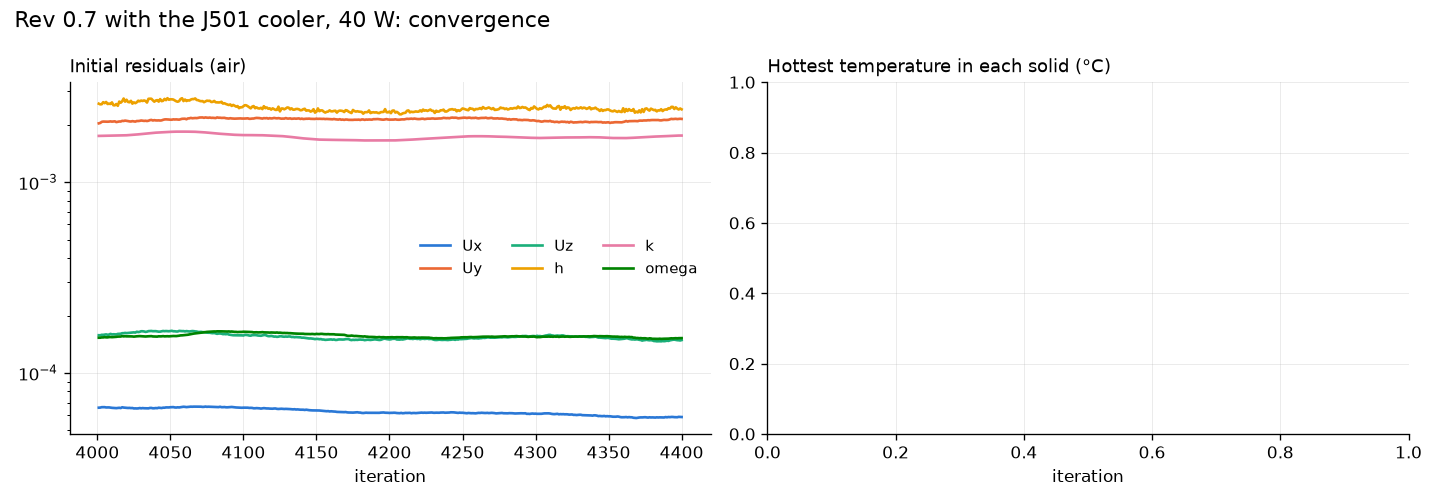
preview/thermal/cooled-convergence.png
