mvalancy/j501-agx-orin/preview/thermal/cooled-flow.png

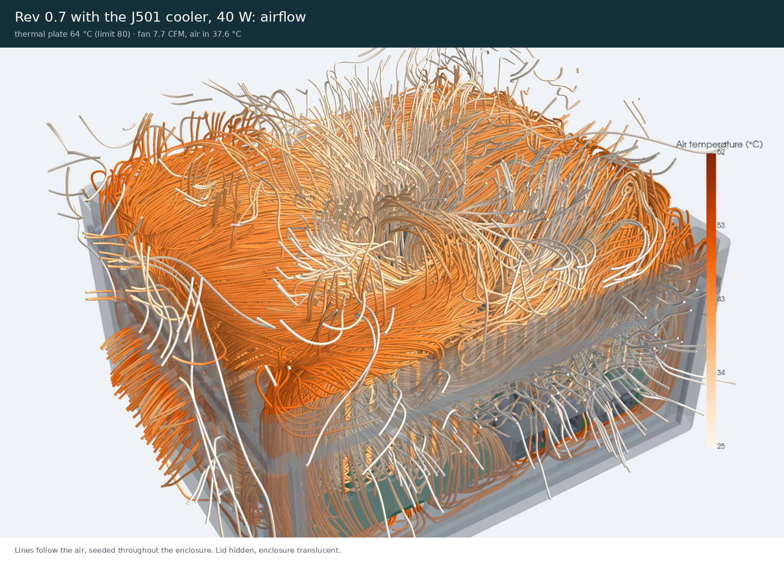
preview/thermal/cooled-flow.png
