mvalancy/j501-agx-orin/preview/thermal/cooled-section-x.png

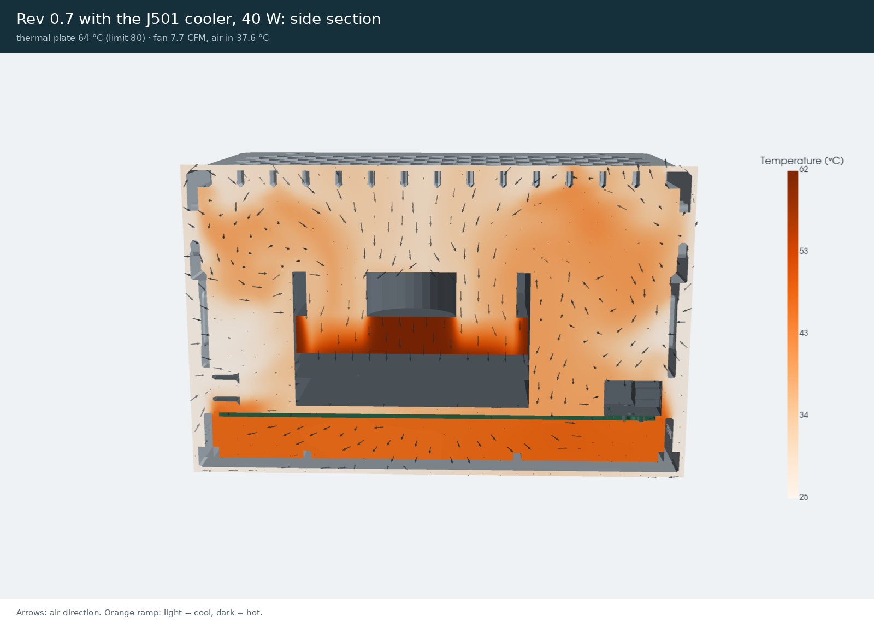
preview/thermal/cooled-section-x.png
