mvalancy/j501-agx-orin/preview/thermal/cooled-walls.png

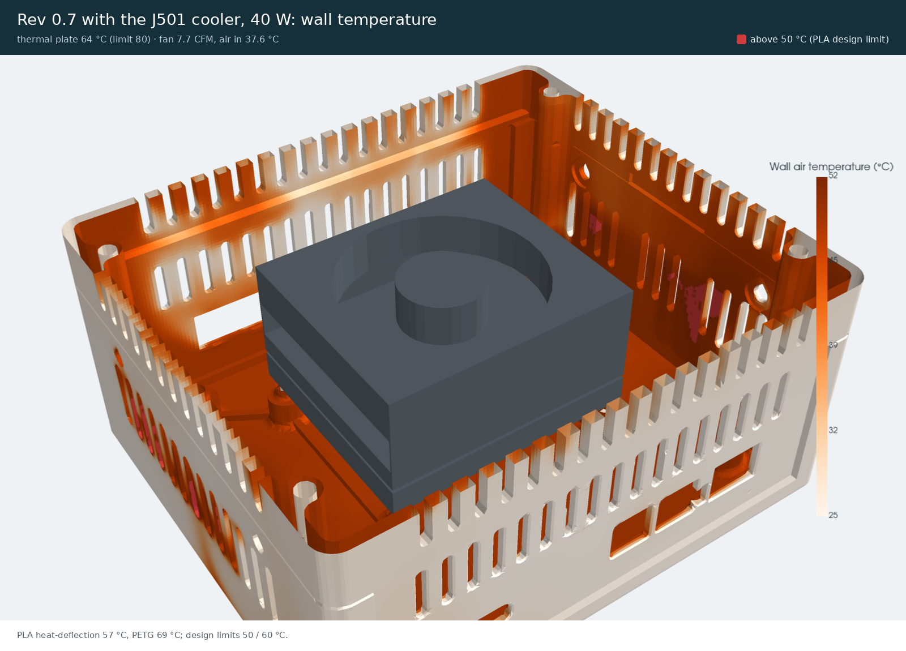
preview/thermal/cooled-walls.png
