mvalancy/j501-agx-orin/preview/topology-floor.png

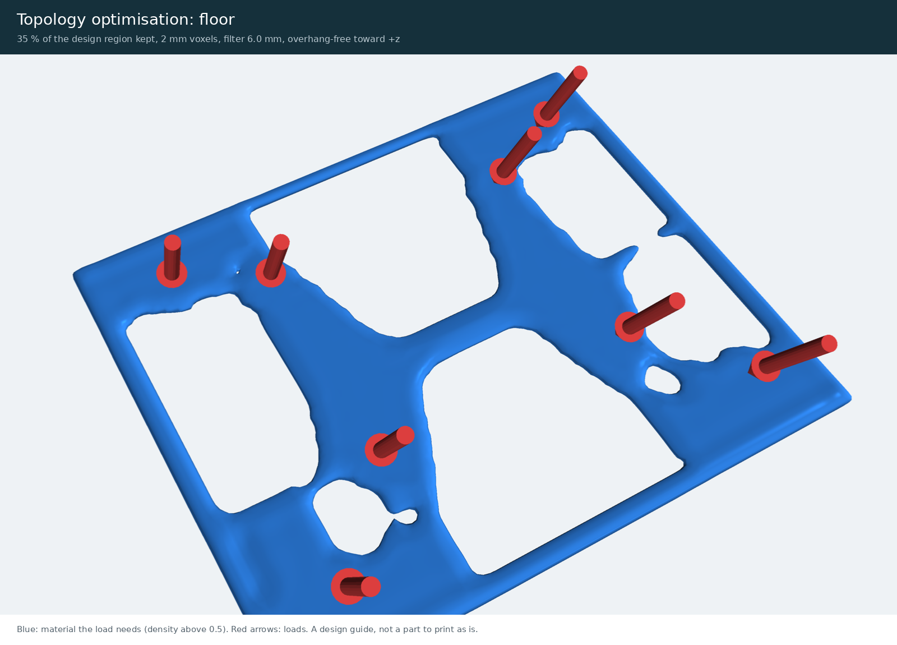
preview/topology-floor.png
