mvalancy/j501-agx-orin/preview/topology-roof.png

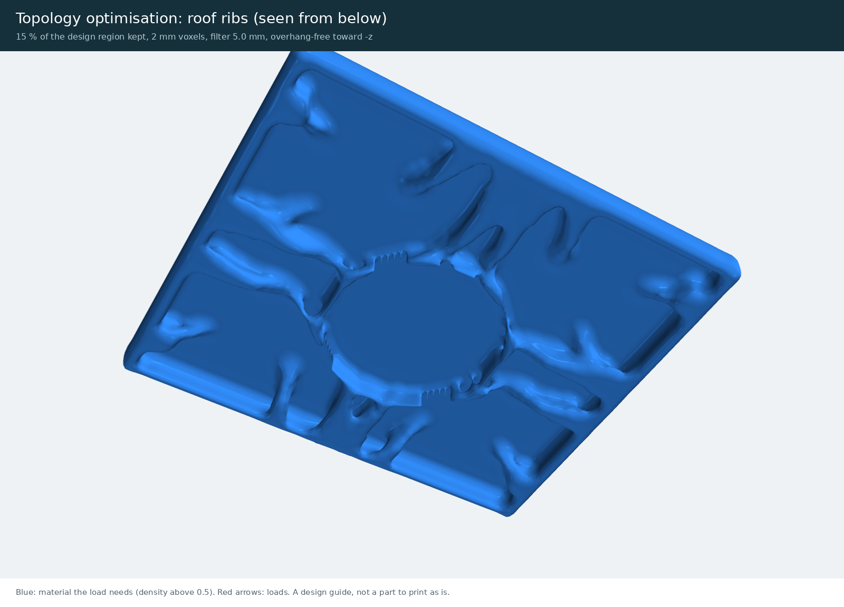
preview/topology-roof.png
