mvalancy/j501-agx-orin/docs/measurement-register.csv

id | parameter | value | units | status | source | how_to_check | limitations
M001 | revision | 0.9-g48r | mm unless stated | design selection | cad/parameters.json + cad/build.py | Compare parameter to exported STEP; print a coupon for fits. | Nominal CAD dimension; printer/material compensation not applied.
M002 | release | 0.9.1 | mm unless stated | design selection | cad/parameters.json + cad/build.py | Compare parameter to exported STEP; print a coupon for fits. | Nominal CAD dimension; printer/material compensation not applied.
M003 | release_note | Release 0.9.1 (2026-10-29) fixes the Rev 0.9 parts without changing the design revision: the owner found the cover's roof ribs reaching into the four lid-screw counterbores in exports/cover.stl (issue #9). The counterbores and clearance holes are now cut after the ribs, and cad-agent holes checks every hole of every part. | mm unless stated | design selection | cad/parameters.json + cad/build.py | Compare parameter to exported STEP; print a coupon for fits. | Nominal CAD dimension; printer/material compensation not applied.
M004 | units | mm | mm unless stated | design selection | cad/parameters.json + cad/build.py | Compare parameter to exported STEP; print a coupon for fits. | Nominal CAD dimension; printer/material compensation not applied.
M005 | pcb.width | 176.0 | mm unless stated | CAD derived | S01 carrier STEP; references/solids.json and mount-features.json | Measure board edges and mounting centers using the printed template. | Mount centers from separate proxy solids, not drilled holes in the PCB solid. M3 hole/thread suitability is unconfirmed.
M006 | pcb.depth | 163.0 | mm unless stated | CAD derived | S01 carrier STEP; references/solids.json and mount-features.json | Measure board edges and mounting centers using the printed template. | Mount centers from separate proxy solids, not drilled holes in the PCB solid. M3 hole/thread suitability is unconfirmed.
M007 | pcb.thickness | 1.578 | mm unless stated | CAD derived | S01 carrier STEP; references/solids.json and mount-features.json | Measure board edges and mounting centers using the printed template. | Mount centers from separate proxy solids, not drilled holes in the PCB solid. M3 hole/thread suitability is unconfirmed.
M008 | pcb.origin_in_source_step | [32.199, -510.506, -1.578] | mm unless stated | CAD derived | S01 carrier STEP; references/solids.json and mount-features.json | Measure board edges and mounting centers using the printed template. | Mount centers from separate proxy solids, not drilled holes in the PCB solid. M3 hole/thread suitability is unconfirmed.
M009 | pcb.mount_holes | [[15, 16.5], [165, 16.5], [15, 146.5], [165, 146.5]] | mm unless stated | CAD derived | S01 carrier STEP; references/solids.json and mount-features.json | Measure board edges and mounting centers using the printed template. | Mount centers from separate proxy solids, not drilled holes in the PCB solid. M3 hole/thread suitability is unconfirmed.
M010 | pcb.module_mount_centers | [[44, 51], [136, 51], [44, 130], [136, 130]] | mm unless stated | CAD derived | S01 carrier STEP; references/solids.json and mount-features.json | Measure board edges and mounting centers using the printed template. | Mount centers from separate proxy solids, not drilled holes in the PCB solid. M3 hole/thread suitability is unconfirmed.
M011 | pcb.lowest_component | -6.5 | mm unless stated | CAD derived | S01 carrier STEP; references/solids.json and mount-features.json | Measure board edges and mounting centers using the printed template. | Mount centers from separate proxy solids, not drilled holes in the PCB solid. M3 hole/thread suitability is unconfirmed.
M012 | enclosure.pcb_margin | 15.0 | mm unless stated | design selection | cad/parameters.json + cad/build.py | Compare parameter to exported STEP; print a coupon for fits. | Nominal CAD dimension; printer/material compensation not applied.
M013 | enclosure.width | 206.0 | mm unless stated | design selection | cad/parameters.json + cad/build.py | Compare parameter to exported STEP; print a coupon for fits. | Nominal CAD dimension; printer/material compensation not applied.
M014 | enclosure.front_y | 5.5 | mm unless stated | design selection | cad/parameters.json + cad/build.py | Compare parameter to exported STEP; print a coupon for fits. | Nominal CAD dimension; printer/material compensation not applied.
M015 | enclosure.rear_y | 186.5 | mm unless stated | design selection | cad/parameters.json + cad/build.py | Compare parameter to exported STEP; print a coupon for fits. | Nominal CAD dimension; printer/material compensation not applied.
M016 | enclosure.floor | 4.0 | mm unless stated | design selection | cad/parameters.json + cad/build.py | Compare parameter to exported STEP; print a coupon for fits. | Nominal CAD dimension; printer/material compensation not applied.
M017 | enclosure.wall | 4.0 | mm unless stated | design selection | cad/parameters.json + cad/build.py | Compare parameter to exported STEP; print a coupon for fits. | Nominal CAD dimension; printer/material compensation not applied.
M018 | enclosure.base_height | 72.0 | mm unless stated | design selection | cad/parameters.json + cad/build.py | Compare parameter to exported STEP; print a coupon for fits. | Nominal CAD dimension; printer/material compensation not applied.
M019 | enclosure.height | 97.0 | mm unless stated | design selection | cad/parameters.json + cad/build.py | Compare parameter to exported STEP; print a coupon for fits. | Nominal CAD dimension; printer/material compensation not applied.
M020 | enclosure.roof_thickness | 3.5 | mm unless stated | design selection | cad/parameters.json + cad/build.py | Compare parameter to exported STEP; print a coupon for fits. | Nominal CAD dimension; printer/material compensation not applied.
M021 | enclosure.outer_corner_radius | 8.0 | mm unless stated | design selection | cad/parameters.json + cad/build.py | Compare parameter to exported STEP; print a coupon for fits. | Nominal CAD dimension; printer/material compensation not applied.
M022 | enclosure.cavity_corner_radius | 4.0 | mm unless stated | design selection | cad/parameters.json + cad/build.py | Compare parameter to exported STEP; print a coupon for fits. | Nominal CAD dimension; printer/material compensation not applied.
M023 | enclosure.base_bottom_chamfer | 0.8 | mm unless stated | design selection | cad/parameters.json + cad/build.py | Compare parameter to exported STEP; print a coupon for fits. | Nominal CAD dimension; printer/material compensation not applied.
M024 | enclosure.split_chamfer | 0.6 | mm unless stated | design selection | cad/parameters.json + cad/build.py | Compare parameter to exported STEP; print a coupon for fits. | Nominal CAD dimension; printer/material compensation not applied.
M025 | enclosure.roof_edge_chamfer | 1.5 | mm unless stated | design selection | cad/parameters.json + cad/build.py | Compare parameter to exported STEP; print a coupon for fits. | Nominal CAD dimension; printer/material compensation not applied.
M026 | enclosure.board_support_height | 16.0 | mm unless stated | design selection | cad/parameters.json + cad/build.py | Compare parameter to exported STEP; print a coupon for fits. | Nominal CAD dimension; printer/material compensation not applied.
M027 | enclosure.board_post_diameter | 16.0 | mm unless stated | design selection | cad/parameters.json + cad/build.py | Compare parameter to exported STEP; print a coupon for fits. | Nominal CAD dimension; printer/material compensation not applied.
M028 | enclosure.board_landing_diameter | 6.9 | mm unless stated | design selection | cad/parameters.json + cad/build.py | Compare parameter to exported STEP; print a coupon for fits. | Nominal CAD dimension; printer/material compensation not applied.
M029 | enclosure.board_landing_height | 4.5 | mm unless stated | design selection | cad/parameters.json + cad/build.py | Compare parameter to exported STEP; print a coupon for fits. | Nominal CAD dimension; printer/material compensation not applied.
M030 | enclosure.board_insert_pilot | 3.9 | mm unless stated | design selection | cad/parameters.json + cad/build.py | Compare parameter to exported STEP; print a coupon for fits. | Nominal CAD dimension; printer/material compensation not applied.
M031 | enclosure.board_insert_depth | 11.0 | mm unless stated | design selection | cad/parameters.json + cad/build.py | Compare parameter to exported STEP; print a coupon for fits. | Nominal CAD dimension; printer/material compensation not applied.
M032 | enclosure.board_insert_length | 10 | mm unless stated | design selection | cad/parameters.json + cad/build.py | Compare parameter to exported STEP; print a coupon for fits. | Nominal CAD dimension; printer/material compensation not applied.
M033 | enclosure.panel_thickness | 3.0 | mm unless stated | design selection | cad/parameters.json + cad/build.py | Compare parameter to exported STEP; print a coupon for fits. | Nominal CAD dimension; printer/material compensation not applied.
M034 | enclosure.panel_clearance | 0.25 | mm unless stated | design selection | cad/parameters.json + cad/build.py | Compare parameter to exported STEP; print a coupon for fits. | Nominal CAD dimension; printer/material compensation not applied.
M035 | enclosure.panel_x | [10.25, 195.75] | mm unless stated | design selection | cad/parameters.json + cad/build.py | Compare parameter to exported STEP; print a coupon for fits. | Nominal CAD dimension; printer/material compensation not applied.
M036 | enclosure.front_panel_y | 8.25 | mm unless stated | design selection | cad/parameters.json + cad/build.py | Compare parameter to exported STEP; print a coupon for fits. | Nominal CAD dimension; printer/material compensation not applied.
M037 | enclosure.rear_panel_y | 180.75 | mm unless stated | design selection | cad/parameters.json + cad/build.py | Compare parameter to exported STEP; print a coupon for fits. | Nominal CAD dimension; printer/material compensation not applied.
M038 | enclosure.panel_top_clearance | 0.2 | mm unless stated | design selection | cad/parameters.json + cad/build.py | Compare parameter to exported STEP; print a coupon for fits. | Nominal CAD dimension; printer/material compensation not applied.
M039 | enclosure.corner_post_size | [14.0, 9.0] | mm unless stated | design selection | cad/parameters.json + cad/build.py | Compare parameter to exported STEP; print a coupon for fits. | Nominal CAD dimension; printer/material compensation not applied.
M040 | enclosure.sill_height | 4.0 | mm unless stated | design selection | cad/parameters.json + cad/build.py | Compare parameter to exported STEP; print a coupon for fits. | Nominal CAD dimension; printer/material compensation not applied.
M041 | enclosure.sill_inner_y | [13.5, 178.5] | mm unless stated | design selection | cad/parameters.json + cad/build.py | Compare parameter to exported STEP; print a coupon for fits. | Nominal CAD dimension; printer/material compensation not applied.
M042 | enclosure.joint_tongue | [2.3, 3.7, 4.5] | mm unless stated | design selection | cad/parameters.json + cad/build.py | Compare parameter to exported STEP; print a coupon for fits. | Nominal CAD dimension; printer/material compensation not applied.
M043 | enclosure.joint_rebate | [2.0, 4.0, 5.0] | mm unless stated | design selection | cad/parameters.json + cad/build.py | Compare parameter to exported STEP; print a coupon for fits. | Nominal CAD dimension; printer/material compensation not applied.
M044 | enclosure.lid_screw_centers | [[8.8, 30.0], [8.8, 162.0], [197.2, 30.0], [197.2, 162.0]] | mm unless stated | design selection | cad/parameters.json + cad/build.py | Compare parameter to exported STEP; print a coupon for fits. | Nominal CAD dimension; printer/material compensation not applied.
M045 | enclosure.lid_column_diameter | 10.0 | mm unless stated | design selection | cad/parameters.json + cad/build.py | Compare parameter to exported STEP; print a coupon for fits. | Nominal CAD dimension; printer/material compensation not applied.
M046 | enclosure.lid_screw | M3 x 16 ISO 4762 socket head | mm unless stated | design selection | cad/parameters.json + cad/build.py | Compare parameter to exported STEP; print a coupon for fits. | Nominal CAD dimension; printer/material compensation not applied.
M047 | enclosure.lid_screw_head_z | 78.0 | mm unless stated | design selection | cad/parameters.json + cad/build.py | Compare parameter to exported STEP; print a coupon for fits. | Nominal CAD dimension; printer/material compensation not applied.
M048 | enclosure.lid_counterbore_diameter | 6.4 | mm unless stated | design selection | cad/parameters.json + cad/build.py | Compare parameter to exported STEP; print a coupon for fits. | Nominal CAD dimension; printer/material compensation not applied.
M049 | enclosure.m3_clearance | 3.4 | mm unless stated | design selection | cad/parameters.json + cad/build.py | Compare parameter to exported STEP; print a coupon for fits. | Nominal CAD dimension; printer/material compensation not applied.
M050 | enclosure.lid_screw_clearance | 3.6 | mm unless stated | design selection | cad/parameters.json + cad/build.py | Compare parameter to exported STEP; print a coupon for fits. | Nominal CAD dimension; printer/material compensation not applied.
M051 | enclosure.lid_screw_clearance_note | User print test 2026-10-25: M3 screws did not slide through the 3.4 lid holes; opened to 3.6. | mm unless stated | design selection | cad/parameters.json + cad/build.py | Compare parameter to exported STEP; print a coupon for fits. | Nominal CAD dimension; printer/material compensation not applied.
M052 | enclosure.lid_insert_pilot | 3.9 | mm unless stated | design selection | cad/parameters.json + cad/build.py | Compare parameter to exported STEP; print a coupon for fits. | Nominal CAD dimension; printer/material compensation not applied.
M053 | enclosure.insert_seat_diameter | 4.05 | mm unless stated | design selection | cad/parameters.json + cad/build.py | Compare parameter to exported STEP; print a coupon for fits. | Nominal CAD dimension; printer/material compensation not applied.
M054 | enclosure.insert_seat_depth | 1.0 | mm unless stated | design selection | cad/parameters.json + cad/build.py | Compare parameter to exported STEP; print a coupon for fits. | Nominal CAD dimension; printer/material compensation not applied.
M055 | enclosure.insert_seat_note | User print test 2026-10-25: the insert tip (D3.75) did not sit in the D3.9 pilot before heating. A D4.05 x 1.0 seat below the lead-in lets it stand upright; the D3.9 bore below keeps the melt grip. | mm unless stated | design selection | cad/parameters.json + cad/build.py | Compare parameter to exported STEP; print a coupon for fits. | Nominal CAD dimension; printer/material compensation not applied.
M056 | enclosure.lid_insert_depth | 11.0 | mm unless stated | design selection | cad/parameters.json + cad/build.py | Compare parameter to exported STEP; print a coupon for fits. | Nominal CAD dimension; printer/material compensation not applied.
M057 | enclosure.heatsink_column_diameter | 14.0 | mm unless stated | design selection | cad/parameters.json + cad/build.py | Compare parameter to exported STEP; print a coupon for fits. | Nominal CAD dimension; printer/material compensation not applied.
M058 | enclosure.heatsink_landing_diameter | 7.14 | mm unless stated | design selection | cad/parameters.json + cad/build.py | Compare parameter to exported STEP; print a coupon for fits. | Nominal CAD dimension; printer/material compensation not applied.
M059 | enclosure.landing_basis | Landings match the carrier STEP mount-pad bodies (solids 5155-5158 D6.9 board holes, 5159-5162 D7.14 cooler holes) for full annular-ring contact; nearest underside part is >= 4.14 mm from any hole centre (bbox), so the landing edge clears it by >= 0.5 mm. Pads assumed identical on both sides; measure. | mm unless stated | design selection | cad/parameters.json + cad/build.py | Compare parameter to exported STEP; print a coupon for fits. | Nominal CAD dimension; printer/material compensation not applied.
M060 | enclosure.fit_template_height | 12.0 | mm unless stated | design selection | cad/parameters.json + cad/build.py | Compare parameter to exported STEP; print a coupon for fits. | Nominal CAD dimension; printer/material compensation not applied.
M061 | enclosure.heatsink_clearance | 3.4 | mm unless stated | design selection | cad/parameters.json + cad/build.py | Compare parameter to exported STEP; print a coupon for fits. | Nominal CAD dimension; printer/material compensation not applied.
M062 | enclosure.heatsink_countersink_diameter | 7.0 | mm unless stated | design selection | cad/parameters.json + cad/build.py | Compare parameter to exported STEP; print a coupon for fits. | Nominal CAD dimension; printer/material compensation not applied.
M063 | enclosure.heatsink_screw | M3 x 35 flat head, DIN 7991 / ISO 10642 (M3 from the module holes: D3.5 PCB, D3.7 thermal plate); threads up into the female standoffs between the AGX module and the heatsink | mm unless stated | design selection | cad/parameters.json + cad/build.py | Compare parameter to exported STEP; print a coupon for fits. | Nominal CAD dimension; printer/material compensation not applied.
M064 | enclosure.floor_rib | [3.0, 3.0] | mm unless stated | design selection | cad/parameters.json + cad/build.py | Compare parameter to exported STEP; print a coupon for fits. | Nominal CAD dimension; printer/material compensation not applied.
M065 | enclosure.foot_pockets | [[18, 22], [188, 22], [18, 170], [188, 170]] | mm unless stated | design selection | cad/parameters.json + cad/build.py | Compare parameter to exported STEP; print a coupon for fits. | Nominal CAD dimension; printer/material compensation not applied.
M066 | enclosure.foot_pocket | [12.0, 1.0] | mm unless stated | design selection | cad/parameters.json + cad/build.py | Compare parameter to exported STEP; print a coupon for fits. | Nominal CAD dimension; printer/material compensation not applied.
M067 | enclosure.hatch_y | [76.0, 118.0] | mm unless stated | design selection | cad/parameters.json + cad/build.py | Compare parameter to exported STEP; print a coupon for fits. | Nominal CAD dimension; printer/material compensation not applied.
M068 | enclosure.hatch_bottom_z | 12.0 | mm unless stated | design selection | cad/parameters.json + cad/build.py | Compare parameter to exported STEP; print a coupon for fits. | Nominal CAD dimension; printer/material compensation not applied.
M069 | enclosure.hatch_clearance | 0.2 | mm unless stated | design selection | cad/parameters.json + cad/build.py | Compare parameter to exported STEP; print a coupon for fits. | Nominal CAD dimension; printer/material compensation not applied.
M070 | enclosure.vent_width | 4.0 | mm unless stated | design selection | cad/parameters.json + cad/build.py | Compare parameter to exported STEP; print a coupon for fits. | Nominal CAD dimension; printer/material compensation not applied.
M071 | enclosure.vent_pitch | 9.0 | mm unless stated | design selection | cad/parameters.json + cad/build.py | Compare parameter to exported STEP; print a coupon for fits. | Nominal CAD dimension; printer/material compensation not applied.
M072 | enclosure.side_vent_y | [42, 150] | mm unless stated | design selection | cad/parameters.json + cad/build.py | Compare parameter to exported STEP; print a coupon for fits. | Nominal CAD dimension; printer/material compensation not applied.
M073 | enclosure.base_vent_z | [28, 56] | mm unless stated | design selection | cad/parameters.json + cad/build.py | Compare parameter to exported STEP; print a coupon for fits. | Nominal CAD dimension; printer/material compensation not applied.
M074 | enclosure.lid_vent_z | [75, 88] | mm unless stated | design selection | cad/parameters.json + cad/build.py | Compare parameter to exported STEP; print a coupon for fits. | Nominal CAD dimension; printer/material compensation not applied.
M075 | enclosure.panel_vent_x | [31, 175] | mm unless stated | design selection | cad/parameters.json + cad/build.py | Compare parameter to exported STEP; print a coupon for fits. | Nominal CAD dimension; printer/material compensation not applied.
M076 | enclosure.panel_vent_z | [46, 66] | mm unless stated | design selection | cad/parameters.json + cad/build.py | Compare parameter to exported STEP; print a coupon for fits. | Nominal CAD dimension; printer/material compensation not applied.
M077 | enclosure.panel_vent_width | 3.6 | mm unless stated | design selection | cad/parameters.json + cad/build.py | Compare parameter to exported STEP; print a coupon for fits. | Nominal CAD dimension; printer/material compensation not applied.
M078 | enclosure.hex_across_flats | 10.0 | mm unless stated | design selection | cad/parameters.json + cad/build.py | Compare parameter to exported STEP; print a coupon for fits. | Nominal CAD dimension; printer/material compensation not applied.
M079 | enclosure.hex_web | 1.8 | mm unless stated | design selection | cad/parameters.json + cad/build.py | Compare parameter to exported STEP; print a coupon for fits. | Nominal CAD dimension; printer/material compensation not applied.
M080 | enclosure.hex_inlet_flare | 0.6 | mm unless stated | design selection | cad/parameters.json + cad/build.py | Compare parameter to exported STEP; print a coupon for fits. | Nominal CAD dimension; printer/material compensation not applied.
M081 | enclosure.hex_inlet_depth | 1.0 | mm unless stated | design selection | cad/parameters.json + cad/build.py | Compare parameter to exported STEP; print a coupon for fits. | Nominal CAD dimension; printer/material compensation not applied.
M082 | enclosure.service_buttons.actuators_pcb_xz | [[142.91, 5.58], [152.54, 5.58]] | mm unless stated | design selection | cad/parameters.json + cad/build.py | Compare parameter to exported STEP; print a coupon for fits. | Nominal CAD dimension; printer/material compensation not applied.
M083 | enclosure.service_buttons.basis | SW1/SW2 are Alps SKQJLBA010 right-angle tact switches (schematic sheet 21), STEP product SWITCH4-8X7X7MM at PCB X137.4-148.4 and X147.0-158.0 (open shells 143/147). Actuator faces X141.16-144.66 / X150.79-154.29, Z3.83-7.33, tip at PCB Y160.89. User 2026-10-25: REC is the one closest to the USB/IO headers, RST the one closest to the far board edge. An earlier revision placed the holes at X16.6/22.9 over parts matched by size only; that was wrong. | mm unless stated | design selection | cad/parameters.json + cad/build.py | Compare parameter to exported STEP; print a coupon for fits. | Nominal CAD dimension; printer/material compensation not applied.
M084 | enclosure.service_buttons.pin_hole | 1.6 | mm unless stated | design selection | cad/parameters.json + cad/build.py | Compare parameter to exported STEP; print a coupon for fits. | Nominal CAD dimension; printer/material compensation not applied.
M085 | enclosure.service_buttons.lead_in | 0.8 | mm unless stated | design selection | cad/parameters.json + cad/build.py | Compare parameter to exported STEP; print a coupon for fits. | Nominal CAD dimension; printer/material compensation not applied.
M086 | enclosure.service_buttons.sleeve_od | 4.4 | mm unless stated | design selection | cad/parameters.json + cad/build.py | Compare parameter to exported STEP; print a coupon for fits. | Nominal CAD dimension; printer/material compensation not applied.
M087 | enclosure.service_buttons.sleeve_gap_to_pcb_edge | 0.35 | mm unless stated | design selection | cad/parameters.json + cad/build.py | Compare parameter to exported STEP; print a coupon for fits. | Nominal CAD dimension; printer/material compensation not applied.
M088 | enclosure.service_buttons.legend_z | 20.4 | mm unless stated | design selection | cad/parameters.json + cad/build.py | Compare parameter to exported STEP; print a coupon for fits. | Nominal CAD dimension; printer/material compensation not applied.
M089 | enclosure.service_buttons.labels | ["REC", "RST"] | mm unless stated | design selection | cad/parameters.json + cad/build.py | Compare parameter to exported STEP; print a coupon for fits. | Nominal CAD dimension; printer/material compensation not applied.
M090 | enclosure.service_buttons.label_size | 3.0 | mm unless stated | design selection | cad/parameters.json + cad/build.py | Compare parameter to exported STEP; print a coupon for fits. | Nominal CAD dimension; printer/material compensation not applied.
M091 | enclosure.antenna_bulkheads.connector | RP-SMA female bulkhead pigtail (1/4-36 UNS thread), inserted from inside, lock washer + nut outside | mm unless stated | design selection | cad/parameters.json + cad/build.py | Compare parameter to exported STEP; print a coupon for fits. | Nominal CAD dimension; printer/material compensation not applied.
M092 | enclosure.antenna_bulkheads.positions | [{"label": "WIFI 1", "side": "left", "y": 46.5}, {"label": "WIFI 2", "side": "left", "y": 145.5}, {"label": "CELL 1", "side": "right", "y": 46.5}, {"label": "CELL 2", "side": "right", "y": 145.5}] | mm unless stated | design selection | cad/parameters.json + cad/build.py | Compare parameter to exported STEP; print a coupon for fits. | Nominal CAD dimension; printer/material compensation not applied.
M093 | enclosure.antenna_bulkheads.z | 62.0 | mm unless stated | design selection | cad/parameters.json + cad/build.py | Compare parameter to exported STEP; print a coupon for fits. | Nominal CAD dimension; printer/material compensation not applied.
M094 | enclosure.antenna_bulkheads.hole | 6.6 | mm unless stated | design selection | cad/parameters.json + cad/build.py | Compare parameter to exported STEP; print a coupon for fits. | Nominal CAD dimension; printer/material compensation not applied.
M095 | enclosure.antenna_bulkheads.across_flat | 6.0 | mm unless stated | design selection | cad/parameters.json + cad/build.py | Compare parameter to exported STEP; print a coupon for fits. | Nominal CAD dimension; printer/material compensation not applied.
M096 | enclosure.antenna_bulkheads.flat_side | top | mm unless stated | design selection | cad/parameters.json + cad/build.py | Compare parameter to exported STEP; print a coupon for fits. | Nominal CAD dimension; printer/material compensation not applied.
M097 | enclosure.antenna_bulkheads.flat_note | RP-SMA bulkhead threads (1/4-36 UNS) carry one milled flat, 5.8 mm across (Wurth WR-CXASY 65530206515305: panel cutout D6.5 with the flat 6.0 across, panel 2.8 mm max). The hole's flat stops the body turning while the nut is tightened. On top it prints as a 3.8 mm bridge in place of a teardrop. Confirm across_flat with the P20 coupon. | mm unless stated | design selection | cad/parameters.json + cad/build.py | Compare parameter to exported STEP; print a coupon for fits. | Nominal CAD dimension; printer/material compensation not applied.
M098 | enclosure.antenna_bulkheads.coupon_across_flat | [5.9, 6.0, 6.1, 6.2] | mm unless stated | design selection | cad/parameters.json + cad/build.py | Compare parameter to exported STEP; print a coupon for fits. | Nominal CAD dimension; printer/material compensation not applied.
M099 | enclosure.antenna_bulkheads.spot_face_diameter | 12.5 | mm unless stated | design selection | cad/parameters.json + cad/build.py | Compare parameter to exported STEP; print a coupon for fits. | Nominal CAD dimension; printer/material compensation not applied.
M100 | enclosure.antenna_bulkheads.local_wall | 2.5 | mm unless stated | design selection | cad/parameters.json + cad/build.py | Compare parameter to exported STEP; print a coupon for fits. | Nominal CAD dimension; printer/material compensation not applied.
M101 | enclosure.antenna_bulkheads.cap_z | 70.0 | mm unless stated | design selection | cad/parameters.json + cad/build.py | Compare parameter to exported STEP; print a coupon for fits. | Nominal CAD dimension; printer/material compensation not applied.
M102 | enclosure.antenna_bulkheads.label_offset | 15.0 | mm unless stated | design selection | cad/parameters.json + cad/build.py | Compare parameter to exported STEP; print a coupon for fits. | Nominal CAD dimension; printer/material compensation not applied.
M103 | enclosure.hex_field | [16.0, 13.5, 190.0, 178.5] | mm unless stated | design selection | cad/parameters.json + cad/build.py | Compare parameter to exported STEP; print a coupon for fits. | Nominal CAD dimension; printer/material compensation not applied.
M104 | enclosure.panel_window_chamfer | 0.6 | mm unless stated | design selection | cad/parameters.json + cad/build.py | Compare parameter to exported STEP; print a coupon for fits. | Nominal CAD dimension; printer/material compensation not applied.
M105 | enclosure.min_panel_web | 1.8 | mm unless stated | design selection | cad/parameters.json + cad/build.py | Compare parameter to exported STEP; print a coupon for fits. | Nominal CAD dimension; printer/material compensation not applied.
M106 | enclosure.label_depth | 0.5 | mm unless stated | design selection | cad/parameters.json + cad/build.py | Compare parameter to exported STEP; print a coupon for fits. | Nominal CAD dimension; printer/material compensation not applied.
M107 | enclosure.label_size | 3.6 | mm unless stated | design selection | cad/parameters.json + cad/build.py | Compare parameter to exported STEP; print a coupon for fits. | Nominal CAD dimension; printer/material compensation not applied.
M108 | enclosure.mark_size | 5.0 | mm unless stated | design selection | cad/parameters.json + cad/build.py | Compare parameter to exported STEP; print a coupon for fits. | Nominal CAD dimension; printer/material compensation not applied.
M109 | enclosure.mount_ear_x | [26.0, 180.0] | mm unless stated | design selection | cad/parameters.json + cad/build.py | Compare parameter to exported STEP; print a coupon for fits. | Nominal CAD dimension; printer/material compensation not applied.
M110 | enclosure.mount_ear_width | 32.0 | mm unless stated | design selection | cad/parameters.json + cad/build.py | Compare parameter to exported STEP; print a coupon for fits. | Nominal CAD dimension; printer/material compensation not applied.
M111 | enclosure.mount_ear_projection | 26.0 | mm unless stated | design selection | cad/parameters.json + cad/build.py | Compare parameter to exported STEP; print a coupon for fits. | Nominal CAD dimension; printer/material compensation not applied.
M112 | enclosure.mount_ear_thickness | 8.0 | mm unless stated | design selection | cad/parameters.json + cad/build.py | Compare parameter to exported STEP; print a coupon for fits. | Nominal CAD dimension; printer/material compensation not applied.
M113 | enclosure.mount_slot | [12.0, 6.6] | mm unless stated | design selection | cad/parameters.json + cad/build.py | Compare parameter to exported STEP; print a coupon for fits. | Nominal CAD dimension; printer/material compensation not applied.
M114 | enclosure.mount_hole_offset | 15.0 | mm unless stated | design selection | cad/parameters.json + cad/build.py | Compare parameter to exported STEP; print a coupon for fits. | Nominal CAD dimension; printer/material compensation not applied.
M115 | enclosure.mount_washer_envelope_diameter | 16.0 | mm unless stated | design selection | cad/parameters.json + cad/build.py | Compare parameter to exported STEP; print a coupon for fits. | Nominal CAD dimension; printer/material compensation not applied.
M116 | enclosure.mount_tool_envelope_diameter | 20.0 | mm unless stated | design selection | cad/parameters.json + cad/build.py | Compare parameter to exported STEP; print a coupon for fits. | Nominal CAD dimension; printer/material compensation not applied.
M117 | enclosure.heatsink_thread_engagement | 3.0 | mm unless stated | design selection | cad/parameters.json + cad/build.py | Compare parameter to exported STEP; print a coupon for fits. | Nominal CAD dimension; printer/material compensation not applied.
M118 | enclosure.heatsink_thread_engagement_note | About 6 threads at the M3 0.5 mm pitch into the bottom of the cooler's 6.8 mm F-F standoff, whose thread starts on the copper spreader (module top + 0.5 mm pad + 2 mm spreader). That leaves 3.8 mm of the standoff for the short screws from the heatsink ears. Rev 0.8 counted from the module top (the 34 mm cooler); in a Rev 0.8 base the same M3 x 35 reaches only about 1.5 mm. | mm unless stated | design selection | cad/parameters.json + cad/build.py | Compare parameter to exported STEP; print a coupon for fits. | Nominal CAD dimension; printer/material compensation not applied.
M119 | enclosure.heatsink_screw_length | 35.0 | mm unless stated | design selection | cad/parameters.json + cad/build.py | Compare parameter to exported STEP; print a coupon for fits. | Nominal CAD dimension; printer/material compensation not applied.
M120 | enclosure.heatsink_seat_note | Head seat raised inside the column (D7 pocket from the floor, 90-degree countersink at the top) so a standard M3 x 35 gives 3 mm (6 threads) in the G48R cooler's standoffs, leaving 3.8 mm of the 6.8 mm standoff for the short screws (heatsink_thread_engagement). | mm unless stated | design selection | cad/parameters.json + cad/build.py | Compare parameter to exported STEP; print a coupon for fits. | Nominal CAD dimension; printer/material compensation not applied.
M121 | enclosure.lid_column_fillet | 4.0 | mm unless stated | design selection | cad/parameters.json + cad/build.py | Compare parameter to exported STEP; print a coupon for fits. | Nominal CAD dimension; printer/material compensation not applied.
M122 | enclosure.lid_column_flare | 3.0 | mm unless stated | design selection | cad/parameters.json + cad/build.py | Compare parameter to exported STEP; print a coupon for fits. | Nominal CAD dimension; printer/material compensation not applied.
M123 | enclosure.lid_column_note | Each lid-screw column is fused to its side wall by a full-height buttress (wall face to column centre) with 4 mm concave fillets, plus a 3 mm radius fillet where it meets the floor (base) or roof (lid). | mm unless stated | design selection | cad/parameters.json + cad/build.py | Compare parameter to exported STEP; print a coupon for fits. | Nominal CAD dimension; printer/material compensation not applied.
M124 | enclosure.support_floor_flare | 3.0 | mm unless stated | design selection | cad/parameters.json + cad/build.py | Compare parameter to exported STEP; print a coupon for fits. | Nominal CAD dimension; printer/material compensation not applied.
M125 | enclosure.support_shoulder_gusset | 2.0 | mm unless stated | design selection | cad/parameters.json + cad/build.py | Compare parameter to exported STEP; print a coupon for fits. | Nominal CAD dimension; printer/material compensation not applied.
M126 | enclosure.support_fillet_note | Board posts and cooler columns: 3 mm concave radius fillet at the floor and 2 mm concave radius fillet between the pad landing and the broad column. Both stay below the landing top and are re-cut by the component relief. | mm unless stated | design selection | cad/parameters.json + cad/build.py | Compare parameter to exported STEP; print a coupon for fits. | Nominal CAD dimension; printer/material compensation not applied.
M127 | enclosure.floor_vents.file | exports/topology/floor-vents.json | mm unless stated | design selection | cad/parameters.json + cad/build.py | Compare parameter to exported STEP; print a coupon for fits. | Nominal CAD dimension; printer/material compensation not applied.
M128 | enclosure.floor_vents.threshold | 0.3 | mm unless stated | design selection | cad/parameters.json + cad/build.py | Compare parameter to exported STEP; print a coupon for fits. | Nominal CAD dimension; printer/material compensation not applied.
M129 | enclosure.floor_vents.across_flats | 10.0 | mm unless stated | design selection | cad/parameters.json + cad/build.py | Compare parameter to exported STEP; print a coupon for fits. | Nominal CAD dimension; printer/material compensation not applied.
M130 | enclosure.floor_vents.web | 2.4 | mm unless stated | design selection | cad/parameters.json + cad/build.py | Compare parameter to exported STEP; print a coupon for fits. | Nominal CAD dimension; printer/material compensation not applied.
M131 | enclosure.floor_vents.rib_clearance | 1.5 | mm unless stated | design selection | cad/parameters.json + cad/build.py | Compare parameter to exported STEP; print a coupon for fits. | Nominal CAD dimension; printer/material compensation not applied.
M132 | enclosure.floor_vents.note | Rev 0.8: hexagonal openings where the floor topology study (tools/topology.py floor: robot mounting, 10 g down + 5 g sideways) says the floor carries no load. They save filament and let cool air in under the board. 10 mm across flats keeps fingers out. | mm unless stated | design selection | cad/parameters.json + cad/build.py | Compare parameter to exported STEP; print a coupon for fits. | Nominal CAD dimension; printer/material compensation not applied.
M133 | enclosure.roof_ribs.width | 2.0 | mm unless stated | design selection | cad/parameters.json + cad/build.py | Compare parameter to exported STEP; print a coupon for fits. | Nominal CAD dimension; printer/material compensation not applied.
M134 | enclosure.roof_ribs.depth | 8.0 | mm unless stated | design selection | cad/parameters.json + cad/build.py | Compare parameter to exported STEP; print a coupon for fits. | Nominal CAD dimension; printer/material compensation not applied.
M135 | enclosure.roof_ribs.note | Rev 0.9: eight ribs under the roof from the fan skirt to the middle of each wall and to the four lid-screw corners (the radial pattern of the Rev 0.8 roof topology study), centred on the fan, with a round boss where each meets the skirt. Roof 3.5 mm and ribs 8 mm deep from tools/lid_sweep.py (exports/structure/lid-sweep-0.9.json). | mm unless stated | design selection | cad/parameters.json + cad/build.py | Compare parameter to exported STEP; print a coupon for fits. | Nominal CAD dimension; printer/material compensation not applied.
M136 | enclosure.roof_ribs.layout | star | mm unless stated | design selection | cad/parameters.json + cad/build.py | Compare parameter to exported STEP; print a coupon for fits. | Nominal CAD dimension; printer/material compensation not applied.
M137 | enclosure.roof_note | Rev 0.8: 4.5 mm roof with ribs (Rev 0.7: 6 mm, no ribs). | mm unless stated | design selection | cad/parameters.json + cad/build.py | Compare parameter to exported STEP; print a coupon for fits. | Nominal CAD dimension; printer/material compensation not applied.
M138 | enclosure.fan_grille.thickness | 3.0 | mm unless stated | design selection | cad/parameters.json + cad/build.py | Compare parameter to exported STEP; print a coupon for fits. | Nominal CAD dimension; printer/material compensation not applied.
M139 | enclosure.fan_grille.clearance | 6.0 | mm unless stated | design selection | cad/parameters.json + cad/build.py | Compare parameter to exported STEP; print a coupon for fits. | Nominal CAD dimension; printer/material compensation not applied.
M140 | enclosure.fan_grille.skirt_wall | 2.4 | mm unless stated | design selection | cad/parameters.json + cad/build.py | Compare parameter to exported STEP; print a coupon for fits. | Nominal CAD dimension; printer/material compensation not applied.
M141 | enclosure.fan_grille.skirt_below_fan_top | 3.5 | mm unless stated | design selection | cad/parameters.json + cad/build.py | Compare parameter to exported STEP; print a coupon for fits. | Nominal CAD dimension; printer/material compensation not applied.
M142 | enclosure.fan_grille.hub_diameter | 20.0 | mm unless stated | design selection | cad/parameters.json + cad/build.py | Compare parameter to exported STEP; print a coupon for fits. | Nominal CAD dimension; printer/material compensation not applied.
M143 | enclosure.fan_grille.rings | 2 | mm unless stated | design selection | cad/parameters.json + cad/build.py | Compare parameter to exported STEP; print a coupon for fits. | Nominal CAD dimension; printer/material compensation not applied.
M144 | enclosure.fan_grille.ring_width | 1.4 | mm unless stated | design selection | cad/parameters.json + cad/build.py | Compare parameter to exported STEP; print a coupon for fits. | Nominal CAD dimension; printer/material compensation not applied.
M145 | enclosure.fan_grille.spokes | 12 | mm unless stated | design selection | cad/parameters.json + cad/build.py | Compare parameter to exported STEP; print a coupon for fits. | Nominal CAD dimension; printer/material compensation not applied.
M146 | enclosure.fan_grille.spoke_width | 2.0 | mm unless stated | design selection | cad/parameters.json + cad/build.py | Compare parameter to exported STEP; print a coupon for fits. | Nominal CAD dimension; printer/material compensation not applied.
M147 | enclosure.fan_grille.note | Rev 0.9: the roof is cut away over the fan down to a flush 3 mm grille (hub disc, 2 rings, 12 spokes); the fan top sits 2.44 mm under it. A skirt wall around the fan frame (6 mm clear, so a 3 mm fan-position error still clears; down to 3.5 mm below the fan top) is meant to keep the fan's exhaust (it blows up) going out through the grille (the 6 mm gap between frame and skirt stays open below, so some exhaust can spill back: see the cooled CFD) and stiffens the cut-out; the roof ribs start on it. Spokes, hub and thickness from the lid sweep (300 N): 12 spokes and a D20 hub flex least. | mm unless stated | design selection | cad/parameters.json + cad/build.py | Compare parameter to exported STEP; print a coupon for fits. | Nominal CAD dimension; printer/material compensation not applied.
M148 | enclosure.fan_grille.band_skin | 1.2 | mm unless stated | design selection | cad/parameters.json + cad/build.py | Compare parameter to exported STEP; print a coupon for fits. | Nominal CAD dimension; printer/material compensation not applied.
M149 | cooler.profile | recomputer_mini_j501 | mm unless stated | drawing / photo derived | S05, S06 and user photos IMG_1852-1854 (2026-10-27) | Measure the spreader outline and the finned bar height (photo: 100 x 111 mm spreader, bar at the front edge). | No vendor CAD; plate thickness and the finned bar height are assumed.
M150 | cooler.model | Seeed reComputer mini J501 heatsink with fan (SKU 100099421): a G48R heat-pipe tower (Li Yang Peng) on a 2 mm copper spreader, 9215 fan 92 x 92 x 15 mm, 12 V | mm unless stated | drawing / photo derived | S05, S06 and user photos IMG_1852-1854 (2026-10-27) | Measure the spreader outline and the finned bar height (photo: 100 x 111 mm spreader, bar at the front edge). | No vendor CAD; plate thickness and the finned bar height are assumed.
M151 | cooler.datasheets | S05 references/100099421.pdf (110 x 100 x 50 mm, 12 V, 14.1-55.26 CFM); S06 references/reComputer_Mini_J501_Fan.pdf (G48R drawings: heatsink 93 x 102 x 33.3 mm, 97 x 102 x 48.3 mm with the fan, 5 x D6 heat pipes; fan 9215-Y) | mm unless stated | drawing / photo derived | S05, S06 and user photos IMG_1852-1854 (2026-10-27) | Measure the spreader outline and the finned bar height (photo: 100 x 111 mm spreader, bar at the front edge). | No vendor CAD; plate thickness and the finned bar height are assumed.
M152 | cooler.identity_confirmed | true | mm unless stated | drawing / photo derived | S05, S06 and user photos IMG_1852-1854 (2026-10-27) | Measure the spreader outline and the finned bar height (photo: 100 x 111 mm spreader, bar at the front edge). | No vendor CAD; plate thickness and the finned bar height are assumed.
M153 | cooler.identity_note | User photos 2026-10-27 (IMG_1852-1854) and the user: this cooler is fitted. The Rev 0.8 lid, sized for the 34 mm WS-RDN-601, hit it by about 15 mm. | mm unless stated | drawing / photo derived | S05, S06 and user photos IMG_1852-1854 (2026-10-27) | Measure the spreader outline and the finned bar height (photo: 100 x 111 mm spreader, bar at the front edge). | No vendor CAD; plate thickness and the finned bar height are assumed.
M154 | cooler.center_in_pcb | [90.0, 90.5] | mm unless stated | drawing / photo derived | S05, S06 and user photos IMG_1852-1854 (2026-10-27) | Measure the spreader outline and the finned bar height (photo: 100 x 111 mm spreader, bar at the front edge). | No vendor CAD; plate thickness and the finned bar height are assumed.
M155 | cooler.center_note | Fan and fin centre, on the module centre. From IMG_1852 (corrected orientation: front I/O on the photo's right, DC IN at the top) with a two-plane fit (wall tops Z72, board screw heads Z24): fan hub at PCB (90.4, 90.5); the four mounting ears land within 2.6 mm of the four module holes. The lid tolerates +/-3 mm; measure the fan centre from the PCB edges to confirm. | mm unless stated | drawing / photo derived | S05, S06 and user photos IMG_1852-1854 (2026-10-27) | Measure the spreader outline and the finned bar height (photo: 100 x 111 mm spreader, bar at the front edge). | No vendor CAD; plate thickness and the finned bar height are assumed.
M156 | cooler.size | [102.0, 97.0, 50.3] | mm unless stated | manufacturer drawing; identity confirmed by user photos 2026-10-27 | S06 G48R drawings (97 x 102 x 48.3 mm with the 92 x 15 fan) + S05 (110 x 100 x 50 mm kit) + 2 mm copper spreader | Measured 2026-10-27: PCB top to fan top about 68 mm (design keeps 70.0). Fan centre: on the module centre from the photo (ears on the module holes); the lid tolerates 3 mm. | Fan centre from a photo with a fitted camera model (+/-3 mm). The 34 mm WS-RDN-601 is kept as cooler.alternatives (the Rev 0.8 cover fits it).
M157 | cooler.size_note | Envelope from the spreader underside to the fan top: x along the heat pipes with their U-bends (102), y across the fins (fan 92, fins 93, 97 overall), z = 2 mm copper spreader + 48.3 mm heatsink with fan (S06). | mm unless stated | drawing / photo derived | S05, S06 and user photos IMG_1852-1854 (2026-10-27) | Measure the spreader outline and the finned bar height (photo: 100 x 111 mm spreader, bar at the front edge). | No vendor CAD; plate thickness and the finned bar height are assumed.
M158 | cooler.agx_top_above_pcb_top | 19.18 | mm unless stated | derived nominal | S09 + Molex 2048430001 drawing sheet 2 | 8 mm mated module PCB spacing + 11.18 mm module PCB-bottom to TTP top. | Top of the AGX thermal plate = start of the heatsink standoff threads. Module revision not measured.
M159 | cooler.tim_thickness | 0.5 | mm unless stated | assumed | User: standard thermal pad between heatsink and AGX | Measure the fitted pad (compressed). | Raises the heatsink and reduces the roof gap; does not change the tie-down screw length.
M160 | cooler.tim_note | Thermal pad between the AGX thermal plate and the copper spreader (Seeed supplies pads); 0.5 mm nominal, measure the fitted pad. It raises the spreader and so the standoff thread start: a 1 mm pad leaves the M3 x 35 tie-down 2.5 mm of thread instead of 3 mm. | mm unless stated | drawing / photo derived | S05, S06 and user photos IMG_1852-1854 (2026-10-27) | Measure the spreader outline and the finned bar height (photo: 100 x 111 mm spreader, bar at the front edge). | No vendor CAD; plate thickness and the finned bar height are assumed.
M161 | cooler.spreader.size | [100.0, 110.0] | mm unless stated | drawing / photo derived | S05, S06 and user photos IMG_1852-1854 (2026-10-27) | Measure the spreader outline and the finned bar height (photo: 100 x 111 mm spreader, bar at the front edge). | No vendor CAD; plate thickness and the finned bar height are assumed.
M162 | cooler.spreader.center_in_pcb | [90.5, 80.0] | mm unless stated | drawing / photo derived | S05, S06 and user photos IMG_1852-1854 (2026-10-27) | Measure the spreader outline and the finned bar height (photo: 100 x 111 mm spreader, bar at the front edge). | No vendor CAD; plate thickness and the finned bar height are assumed.
M163 | cooler.spreader.thickness | 2.0 | mm unless stated | drawing / photo derived | S05, S06 and user photos IMG_1852-1854 (2026-10-27) | Measure the spreader outline and the finned bar height (photo: 100 x 111 mm spreader, bar at the front edge). | No vendor CAD; plate thickness and the finned bar height are assumed.
M164 | cooler.spreader.note | 2 mm copper between the AGX thermal plate and the heatsink (user). 100 x 110 from S05 (110 x 100 overall) and the photo (PCB y 25-138, x 38-137). | mm unless stated | drawing / photo derived | S05, S06 and user photos IMG_1852-1854 (2026-10-27) | Measure the spreader outline and the finned bar height (photo: 100 x 111 mm spreader, bar at the front edge). | No vendor CAD; plate thickness and the finned bar height are assumed.
M165 | cooler.aux_fins.box_in_pcb | [51.0, 27.0, 130.0, 46.0] | mm unless stated | drawing / photo derived | S05, S06 and user photos IMG_1852-1854 (2026-10-27) | Measure the spreader outline and the finned bar height (photo: 100 x 111 mm spreader, bar at the front edge). | No vendor CAD; plate thickness and the finned bar height are assumed.
M166 | cooler.aux_fins.height | 12.0 | mm unless stated | drawing / photo derived | S05, S06 and user photos IMG_1852-1854 (2026-10-27) | Measure the spreader outline and the finned bar height (photo: 100 x 111 mm spreader, bar at the front edge). | No vendor CAD; plate thickness and the finned bar height are assumed.
M167 | cooler.aux_fins.note | Black finned bar on the spreader rear edge (photo, S05 gallery). Height assumed. | mm unless stated | drawing / photo derived | S05, S06 and user photos IMG_1852-1854 (2026-10-27) | Measure the spreader outline and the finned bar height (photo: 100 x 111 mm spreader, bar at the front edge). | No vendor CAD; plate thickness and the finned bar height are assumed.
M168 | cooler.standoffs.height | 6.8 | mm unless stated | drawing / photo derived | S05, S06 and user photos IMG_1852-1854 (2026-10-27) | Measure the spreader outline and the finned bar height (photo: 100 x 111 mm spreader, bar at the front edge). | No vendor CAD; plate thickness and the finned bar height are assumed.
M169 | cooler.standoffs.diameter | 4.0 | mm unless stated | drawing / photo derived | S05, S06 and user photos IMG_1852-1854 (2026-10-27) | Measure the spreader outline and the finned bar height (photo: 100 x 111 mm spreader, bar at the front edge). | No vendor CAD; plate thickness and the finned bar height are assumed.
M170 | cooler.standoffs.thread | M3 female; effective thread depth not measured | mm unless stated | drawing / photo derived | S05, S06 and user photos IMG_1852-1854 (2026-10-27) | Measure the spreader outline and the finned bar height (photo: 100 x 111 mm spreader, bar at the front edge). | No vendor CAD; plate thickness and the finned bar height are assumed.
M171 | cooler.standoffs.pattern | [92.0, 79.0] | mm unless stated | drawing / photo derived | S05, S06 and user photos IMG_1852-1854 (2026-10-27) | Measure the spreader outline and the finned bar height (photo: 100 x 111 mm spreader, bar at the front edge). | No vendor CAD; plate thickness and the finned bar height are assumed.
M172 | cooler.standoffs.center_in_pcb | [90.0, 90.5] | mm unless stated | drawing / photo derived | S05, S06 and user photos IMG_1852-1854 (2026-10-27) | Measure the spreader outline and the finned bar height (photo: 100 x 111 mm spreader, bar at the front edge). | No vendor CAD; plate thickness and the finned bar height are assumed.
M173 | cooler.standoffs.note | Between the spreader and the heatsink bracket, short M3 screws each end (user). Pattern from the photo ears. | mm unless stated | drawing / photo derived | S05, S06 and user photos IMG_1852-1854 (2026-10-27) | Measure the spreader outline and the finned bar height (photo: 100 x 111 mm spreader, bar at the front edge). | No vendor CAD; plate thickness and the finned bar height are assumed.
M174 | cooler.standoffs.axes_status | Ears placed on the module mounting axes (corrected photo fit, IMG_1852: within 2.6 mm of each hole). The M3 x 35 and the raised seat are chosen from this stack with an assumed 0.5 mm pad; check by hand that the screw turns 6 full threads into each standoff before fitting the short screws. | mm unless stated | drawing / photo derived | S05, S06 and user photos IMG_1852-1854 (2026-10-27) | Measure the spreader outline and the finned bar height (photo: 100 x 111 mm spreader, bar at the front edge). | No vendor CAD; plate thickness and the finned bar height are assumed.
M175 | cooler.heatsink.fins | [84.0, 93.0] | mm unless stated | drawing / photo derived | S05, S06 and user photos IMG_1852-1854 (2026-10-27) | Measure the spreader outline and the finned bar height (photo: 100 x 111 mm spreader, bar at the front edge). | No vendor CAD; plate thickness and the finned bar height are assumed.
M176 | cooler.heatsink.fin_bottom_above_spreader | 5.0 | mm unless stated | drawing / photo derived | S05, S06 and user photos IMG_1852-1854 (2026-10-27) | Measure the spreader outline and the finned bar height (photo: 100 x 111 mm spreader, bar at the front edge). | No vendor CAD; plate thickness and the finned bar height are assumed.
M177 | cooler.heatsink.height_above_spreader | 33.3 | mm unless stated | drawing / photo derived | S05, S06 and user photos IMG_1852-1854 (2026-10-27) | Measure the spreader outline and the finned bar height (photo: 100 x 111 mm spreader, bar at the front edge). | No vendor CAD; plate thickness and the finned bar height are assumed.
M178 | cooler.heatsink.pipe_span_x | 102.0 | mm unless stated | drawing / photo derived | S05, S06 and user photos IMG_1852-1854 (2026-10-27) | Measure the spreader outline and the finned bar height (photo: 100 x 111 mm spreader, bar at the front edge). | No vendor CAD; plate thickness and the finned bar height are assumed.
M179 | cooler.heatsink.heat_pipes | 5 | mm unless stated | drawing / photo derived | S05, S06 and user photos IMG_1852-1854 (2026-10-27) | Measure the spreader outline and the finned bar height (photo: 100 x 111 mm spreader, bar at the front edge). | No vendor CAD; plate thickness and the finned bar height are assumed.
M180 | cooler.heatsink.pipe_diameter | 6.0 | mm unless stated | drawing / photo derived | S05, S06 and user photos IMG_1852-1854 (2026-10-27) | Measure the spreader outline and the finned bar height (photo: 100 x 111 mm spreader, bar at the front edge). | No vendor CAD; plate thickness and the finned bar height are assumed.
M181 | cooler.heatsink.fin_pitch | 1.75 | mm unless stated | drawing / photo derived | S05, S06 and user photos IMG_1852-1854 (2026-10-27) | Measure the spreader outline and the finned bar height (photo: 100 x 111 mm spreader, bar at the front edge). | No vendor CAD; plate thickness and the finned bar height are assumed.
M182 | cooler.heatsink.fin_thickness | 0.35 | mm unless stated | drawing / photo derived | S05, S06 and user photos IMG_1852-1854 (2026-10-27) | Measure the spreader outline and the finned bar height (photo: 100 x 111 mm spreader, bar at the front edge). | No vendor CAD; plate thickness and the finned bar height are assumed.
M183 | cooler.heatsink.material | Al 6063-T5 fins, C1100 copper base and heat pipes, nickel plated (S06) | mm unless stated | drawing / photo derived | S05, S06 and user photos IMG_1852-1854 (2026-10-27) | Measure the spreader outline and the finned bar height (photo: 100 x 111 mm spreader, bar at the front edge). | No vendor CAD; plate thickness and the finned bar height are assumed.
M184 | cooler.heatsink.note | Plates stand across x (stacked along x, 84 mm), 93 mm wide in y: air from the fan leaves at the front and rear (+/-y) faces and under the fins. Pitch counted from IMG_1853 (about 48 plates); thickness assumed. | mm unless stated | drawing / photo derived | S05, S06 and user photos IMG_1852-1854 (2026-10-27) | Measure the spreader outline and the finned bar height (photo: 100 x 111 mm spreader, bar at the front edge). | No vendor CAD; plate thickness and the finned bar height are assumed.
M185 | cooler.heatsink.pipe_pitch_y | 12.0 | mm unless stated | drawing / photo derived | S05, S06 and user photos IMG_1852-1854 (2026-10-27) | Measure the spreader outline and the finned bar height (photo: 100 x 111 mm spreader, bar at the front edge). | No vendor CAD; plate thickness and the finned bar height are assumed.
M186 | cooler.fan.frame | 92.0 | mm unless stated | drawing / photo derived | S05, S06 and user photos IMG_1852-1854 (2026-10-27) | Measure the spreader outline and the finned bar height (photo: 100 x 111 mm spreader, bar at the front edge). | No vendor CAD; plate thickness and the finned bar height are assumed.
M187 | cooler.fan.thickness | 15.0 | mm unless stated | drawing / photo derived | S05, S06 and user photos IMG_1852-1854 (2026-10-27) | Measure the spreader outline and the finned bar height (photo: 100 x 111 mm spreader, bar at the front edge). | No vendor CAD; plate thickness and the finned bar height are assumed.
M188 | cooler.fan.corner_chamfer | 17.5 | mm unless stated | drawing / photo derived | S05, S06 and user photos IMG_1852-1854 (2026-10-27) | Measure the spreader outline and the finned bar height (photo: 100 x 111 mm spreader, bar at the front edge). | No vendor CAD; plate thickness and the finned bar height are assumed.
M189 | cooler.fan.blade_diameter | 88.24 | mm unless stated | drawing / photo derived | S05, S06 and user photos IMG_1852-1854 (2026-10-27) | Measure the spreader outline and the finned bar height (photo: 100 x 111 mm spreader, bar at the front edge). | No vendor CAD; plate thickness and the finned bar height are assumed.
M190 | cooler.fan.hub_diameter | 32.8 | mm unless stated | drawing / photo derived | S05, S06 and user photos IMG_1852-1854 (2026-10-27) | Measure the spreader outline and the finned bar height (photo: 100 x 111 mm spreader, bar at the front edge). | No vendor CAD; plate thickness and the finned bar height are assumed.
M191 | cooler.fan.model | 9215-Y: 12 V, 0-4000 rpm PWM, 14.1-55.26 CFM, 0.84-2.87 mmH2O, 0.24-2.28 W, 4-pin 2510 (S06 p.2, drawing p.11) | mm unless stated | drawing / photo derived | S05, S06 and user photos IMG_1852-1854 (2026-10-27) | Measure the spreader outline and the finned bar height (photo: 100 x 111 mm spreader, bar at the front edge). | No vendor CAD; plate thickness and the finned bar height are assumed.
M192 | cooler.fan.note | Octagonal PBT frame 92.2 x 91.2 mm; corner chamfer legs read from IMG_1852. | mm unless stated | drawing / photo derived | S05, S06 and user photos IMG_1852-1854 (2026-10-27) | Measure the spreader outline and the finned bar height (photo: 100 x 111 mm spreader, bar at the front edge). | No vendor CAD; plate thickness and the finned bar height are assumed.
M193 | cooler.fan.frame_conservative | 95.0 | mm unless stated | drawing / photo derived | S05, S06 and user photos IMG_1852-1854 (2026-10-27) | Measure the spreader outline and the finned bar height (photo: 100 x 111 mm spreader, bar at the front edge). | No vendor CAD; plate thickness and the finned bar height are assumed.
M194 | cooler.fan.blades | 9 | mm unless stated | drawing / photo derived | S05, S06 and user photos IMG_1852-1854 (2026-10-27) | Measure the spreader outline and the finned bar height (photo: 100 x 111 mm spreader, bar at the front edge). | No vendor CAD; plate thickness and the finned bar height are assumed.
M195 | cooler.fan.frame_drawing_xy | [91.2, 92.2] | mm unless stated | drawing / photo derived | S05, S06 and user photos IMG_1852-1854 (2026-10-27) | Measure the spreader outline and the finned bar height (photo: 100 x 111 mm spreader, bar at the front edge). | No vendor CAD; plate thickness and the finned bar height are assumed.
M196 | cooler.fan.screw_pitch | [86, 56] | mm unless stated | drawing / photo derived | S05, S06 and user photos IMG_1852-1854 (2026-10-27) | Measure the spreader outline and the finned bar height (photo: 100 x 111 mm spreader, bar at the front edge). | No vendor CAD; plate thickness and the finned bar height are assumed.
M197 | cooler.fan.electrical.voltage | 12 | mm unless stated | drawing / photo derived | S05, S06 and user photos IMG_1852-1854 (2026-10-27) | Measure the spreader outline and the finned bar height (photo: 100 x 111 mm spreader, bar at the front edge). | No vendor CAD; plate thickness and the finned bar height are assumed.
M198 | cooler.fan.electrical.current_max_a | 0.19 | mm unless stated | drawing / photo derived | S05, S06 and user photos IMG_1852-1854 (2026-10-27) | Measure the spreader outline and the finned bar height (photo: 100 x 111 mm spreader, bar at the front edge). | No vendor CAD; plate thickness and the finned bar height are assumed.
M199 | cooler.fan.electrical.speed_max_rpm | 4000 | mm unless stated | drawing / photo derived | S05, S06 and user photos IMG_1852-1854 (2026-10-27) | Measure the spreader outline and the finned bar height (photo: 100 x 111 mm spreader, bar at the front edge). | No vendor CAD; plate thickness and the finned bar height are assumed.
M200 | cooler.fan.electrical.free_airflow_cfm_range | [14.1, 55.26] | mm unless stated | drawing / photo derived | S05, S06 and user photos IMG_1852-1854 (2026-10-27) | Measure the spreader outline and the finned bar height (photo: 100 x 111 mm spreader, bar at the front edge). | No vendor CAD; plate thickness and the finned bar height are assumed.
M201 | cooler.fan.electrical.shutoff_pressure_mmh2o_range | [0.84, 2.87] | mm unless stated | drawing / photo derived | S05, S06 and user photos IMG_1852-1854 (2026-10-27) | Measure the spreader outline and the finned bar height (photo: 100 x 111 mm spreader, bar at the front edge). | No vendor CAD; plate thickness and the finned bar height are assumed.
M202 | cooler.minimum_fan_clearance | 2.0 | mm unless stated | drawing / photo derived | S05, S06 and user photos IMG_1852-1854 (2026-10-27) | Measure the spreader outline and the finned bar height (photo: 100 x 111 mm spreader, bar at the front edge). | No vendor CAD; plate thickness and the finned bar height are assumed.
M203 | cooler.alternatives.ws_rdn_601.model | Seeed heatsink with fan for reServer J501 (p-5970, WS-RDN-601), 100 x 87 x 34 mm, 8015 5 V fan | mm unless stated | alternative part | S03 (WS-RDN-601) and the fan note | Pick the cover that matches the fitted cooler. | Not the default build.
M204 | cooler.alternatives.ws_rdn_601.datasheet | S03 references/323011387Jetson_AGX_Orin_Heatsink_100x87x34mm-datasheet.pdf | mm unless stated | alternative part | S03 (WS-RDN-601) and the fan note | Pick the cover that matches the fitted cooler. | Not the default build.
M205 | cooler.alternatives.ws_rdn_601.size | [100.0, 87.0, 34.0] | mm unless stated | alternative part | S03 (WS-RDN-601) and the fan note | Pick the cover that matches the fitted cooler. | Not the default build.
M206 | cooler.alternatives.ws_rdn_601.center_in_pcb | [90.0, 90.5] | mm unless stated | alternative part | S03 (WS-RDN-601) and the fan note | Pick the cover that matches the fitted cooler. | Not the default build.
M207 | cooler.alternatives.ws_rdn_601.cover | The Rev 0.8 cover (release rev0.8, height 92) was sized for this cooler: intake ring 2 mm above its 34 mm top. | mm unless stated | alternative part | S03 (WS-RDN-601) and the fan note | Pick the cover that matches the fitted cooler. | Not the default build.
M208 | cooler.alternatives.ws_rdn_601.thermal.cooler.model | Seeed heatsink with fan for Jetson AGX Orin, WS-RDN-601 | mm unless stated | alternative part | S03 (WS-RDN-601) and the fan note | Pick the cover that matches the fitted cooler. | Not the default build.
M209 | cooler.alternatives.ws_rdn_601.thermal.cooler.datasheet | references/323011387Jetson_AGX_Orin_Heatsink_100x87x34mm-datasheet.pdf | mm unless stated | alternative part | S03 (WS-RDN-601) and the fan note | Pick the cover that matches the fitted cooler. | Not the default build.
M210 | cooler.alternatives.ws_rdn_601.thermal.cooler.size | [100.0, 87.0, 34.0] | mm unless stated | alternative part | S03 (WS-RDN-601) and the fan note | Pick the cover that matches the fitted cooler. | Not the default build.
M211 | cooler.alternatives.ws_rdn_601.thermal.cooler.base_thickness | 3.5 | mm unless stated | alternative part | S03 (WS-RDN-601) and the fan note | Pick the cover that matches the fitted cooler. | Not the default build.
M212 | cooler.alternatives.ws_rdn_601.thermal.cooler.cover_thickness | 1.0 | mm unless stated | alternative part | S03 (WS-RDN-601) and the fan note | Pick the cover that matches the fitted cooler. | Not the default build.
M213 | cooler.alternatives.ws_rdn_601.thermal.cooler.fin_pitch | 1.8 | mm unless stated | alternative part | S03 (WS-RDN-601) and the fan note | Pick the cover that matches the fitted cooler. | Not the default build.
M214 | cooler.alternatives.ws_rdn_601.thermal.cooler.fin_thickness | 0.3 | mm unless stated | alternative part | S03 (WS-RDN-601) and the fan note | Pick the cover that matches the fitted cooler. | Not the default build.
M215 | cooler.alternatives.ws_rdn_601.thermal.cooler.k_base_eff | 1500.0 | mm unless stated | alternative part | S03 (WS-RDN-601) and the fan note | Pick the cover that matches the fitted cooler. | Not the default build.
M216 | cooler.alternatives.ws_rdn_601.thermal.cooler.k_fin | 200.0 | mm unless stated | alternative part | S03 (WS-RDN-601) and the fan note | Pick the cover that matches the fitted cooler. | Not the default build.
M217 | cooler.alternatives.ws_rdn_601.thermal.cooler.exhaust_axis | x | mm unless stated | alternative part | S03 (WS-RDN-601) and the fan note | Pick the cover that matches the fitted cooler. | Not the default build.
M218 | cooler.alternatives.ws_rdn_601.thermal.cooler.heat_pipes | 3 | mm unless stated | alternative part | S03 (WS-RDN-601) and the fan note | Pick the cover that matches the fitted cooler. | Not the default build.
M219 | cooler.alternatives.ws_rdn_601.thermal.cooler.basis | Datasheet: 100 x 87 x 34 mm, copper heat pipes through stacked aluminium fins ('air-conditioner outdoor unit' construction), 8015 fan under a top grille, rated 100-120 W; the underside photo shows 3 flattened heat pipes and closed side plates. Assumed: fins 0.3 mm at 1.8 mm pitch, 3.5 mm base, air leaving through the two faces at +/-X (fin edges), effective base conductivity 1500 W/mK. Measure: fin count and thickness, which faces show fin edges, total height. | mm unless stated | alternative part | S03 (WS-RDN-601) and the fan note | Pick the cover that matches the fitted cooler. | Not the default build.
M220 | cooler.alternatives.ws_rdn_601.thermal.cooler.block_effectiveness_guess | 0.25 | mm unless stated | alternative part | S03 (WS-RDN-601) and the fan note | Pick the cover that matches the fitted cooler. | Not the default build.
M221 | cooler.alternatives.ws_rdn_601.thermal.cooler.block_effectiveness_note | Starting point for the fin-temperature calibration only: a coarse J501 run delivered about 8.6 W at 43.5 C fins with 33 C intake air, i.e. the CFD fin block works at roughly a quarter of the uniform-flow conductance, because air from the fan turns straight out along the upper channels. | mm unless stated | alternative part | S03 (WS-RDN-601) and the fan note | Pick the cover that matches the fitted cooler. | Not the default build.
M222 | cooler.alternatives.ws_rdn_601.thermal.fan.axis | [0, 0, -1] | mm unless stated | alternative part | S03 (WS-RDN-601) and the fan note | Pick the cover that matches the fitted cooler. | Not the default build.
M223 | cooler.alternatives.ws_rdn_601.thermal.fan.d_outer | 76.0 | mm unless stated | alternative part | S03 (WS-RDN-601) and the fan note | Pick the cover that matches the fitted cooler. | Not the default build.
M224 | cooler.alternatives.ws_rdn_601.thermal.fan.d_hub | 33.0 | mm unless stated | alternative part | S03 (WS-RDN-601) and the fan note | Pick the cover that matches the fitted cooler. | Not the default build.
M225 | cooler.alternatives.ws_rdn_601.thermal.fan.bore | 77.0 | mm unless stated | alternative part | S03 (WS-RDN-601) and the fan note | Pick the cover that matches the fitted cooler. | Not the default build.
M226 | cooler.alternatives.ws_rdn_601.thermal.fan.thickness | 6.0 | mm unless stated | alternative part | S03 (WS-RDN-601) and the fan note | Pick the cover that matches the fitted cooler. | Not the default build.
M227 | cooler.alternatives.ws_rdn_601.thermal.fan.dp0_pa | 15.2 | mm unless stated | alternative part | S03 (WS-RDN-601) and the fan note | Pick the cover that matches the fitted cooler. | Not the default build.
M228 | cooler.alternatives.ws_rdn_601.thermal.fan.q_free_m3h | 38.9 | mm unless stated | alternative part | S03 (WS-RDN-601) and the fan note | Pick the cover that matches the fitted cooler. | Not the default build.
M229 | cooler.alternatives.ws_rdn_601.thermal.fan.note | 8015 PWM fan, 5 V, 2300 RPM: 22.90 CFM free air, 1.55 mmH2O at zero flow (datasheet; its two row labels are swapped). Straight-line curve between the two; blowing down into the fins (assumed); hub diameter from the drawing (about 33 mm). | mm unless stated | alternative part | S03 (WS-RDN-601) and the fan note | Pick the cover that matches the fitted cooler. | Not the default build.
M230 | cooler.alternatives.fans | Any 92 mm fan clips onto the G48R. A 92 x 25 mm fan sits 10 mm higher: lift the cover with tools/lid_riser.py --rise 10 and M3 screws 10 mm longer. | mm unless stated | alternative part | S03 (WS-RDN-601) and the fan note | Pick the cover that matches the fitted cooler. | Not the default build.
M231 | cooler.fan_xy_uncertainty | 3.0 | mm unless stated | drawing / photo derived | S05, S06 and user photos IMG_1852-1854 (2026-10-27) | Measure the spreader outline and the finned bar height (photo: 100 x 111 mm spreader, bar at the front edge). | No vendor CAD; plate thickness and the finned bar height are assumed.
M232 | cooler.measured.pcb_top_to_fan_top_mm | 68.0 | mm unless stated | drawing / photo derived | S05, S06 and user photos IMG_1852-1854 (2026-10-27) | Measure the spreader outline and the finned bar height (photo: 100 x 111 mm spreader, bar at the front edge). | No vendor CAD; plate thickness and the finned bar height are assumed.
M233 | cooler.measured.date | 2026-10-27 | mm unless stated | drawing / photo derived | S05, S06 and user photos IMG_1852-1854 (2026-10-27) | Measure the spreader outline and the finned bar height (photo: 100 x 111 mm spreader, bar at the front edge). | No vendor CAD; plate thickness and the finned bar height are assumed.
M234 | cooler.measured.by | user (ruler, approximate) | mm unless stated | drawing / photo derived | S05, S06 and user photos IMG_1852-1854 (2026-10-27) | Measure the spreader outline and the finned bar height (photo: 100 x 111 mm spreader, bar at the front edge). | No vendor CAD; plate thickness and the finned bar height are assumed.
M235 | cooler.measured.note | Design keeps 70.0 mm (fan top Z91.56), 2 mm above the measurement, so the real grille gap is about 4.4 mm. | mm unless stated | drawing / photo derived | S05, S06 and user photos IMG_1852-1854 (2026-10-27) | Measure the spreader outline and the finned bar height (photo: 100 x 111 mm spreader, bar at the front edge). | No vendor CAD; plate thickness and the finned bar height are assumed.
M236 | cooler.fan_xy_note | The fan is centred on the module (PCB 90, 90.5): the photo fit (IMG_1852, corrected orientation) puts the hub at (90.4, 90.5) and the four heatsink ears within 2.6 mm of the four module mounting holes, where the long M3 screws pass. The lid still keeps clear of the frame moved 3 mm in any direction, and of a 95 mm frame (S06 table size, may include the wire clips) moved 3 mm. | mm unless stated | drawing / photo derived | S05, S06 and user photos IMG_1852-1854 (2026-10-27) | Measure the spreader outline and the finned bar height (photo: 100 x 111 mm spreader, bar at the front edge). | No vendor CAD; plate thickness and the finned bar height are assumed.
M237 | cooler.photo_registration.filename | IMG_1852.HEIC | mm unless stated | drawing / photo derived | S05, S06 and user photos IMG_1852-1854 (2026-10-27) | Measure the spreader outline and the finned bar height (photo: 100 x 111 mm spreader, bar at the front edge). | No vendor CAD; plate thickness and the finned bar height are assumed.
M238 | cooler.photo_registration.coordinates_on_resized_image | [1176, 1568] | mm unless stated | drawing / photo derived | S05, S06 and user photos IMG_1852-1854 (2026-10-27) | Measure the spreader outline and the finned bar height (photo: 100 x 111 mm spreader, bar at the front edge). | No vendor CAD; plate thickness and the finned bar height are assumed.
M239 | cooler.photo_registration.fan_hub_pixel | [473, 740.5] | mm unless stated | drawing / photo derived | S05, S06 and user photos IMG_1852-1854 (2026-10-27) | Measure the spreader outline and the finned bar height (photo: 100 x 111 mm spreader, bar at the front edge). | No vendor CAD; plate thickness and the finned bar height are assumed.
M240 | cooler.photo_registration.correspondences_enclosure_xyz_to_pixel | [[[197.2, 162, 72], [135, 205]], [[197.2, 30, 72], [922, 183]], [[8.8, 162, 72], [158, 1318]], [[8.8, 30, 72], [940, 1305]], [[180, 161.5, 24], [200, 357]], [[180, 31.5, 24], [878, 347]], [[30, 161.5, 24], [212, 1143]], [[30, 31.5, 24], [888, 1133]]] | mm unless stated | drawing / photo derived | S05, S06 and user photos IMG_1852-1854 (2026-10-27) | Measure the spreader outline and the finned bar height (photo: 100 x 111 mm spreader, bar at the front edge). | No vendor CAD; plate thickness and the finned bar height are assumed.
M241 | cooler.photo_registration.method | Two plane homographies (base wall top Z72; board screw heads Z24) and the straight camera ray between them. The first fit had the photo rotated 180 degrees (the front I/O, DC IN, RJ45 and audio, is on the right-hand wall of IMG_1852 with DC IN at the top) and put the fan 20 mm toward the front; corrected 2026-10-27. Results: fan hub PCB (90.4, 90.5) at the fan top; ears (138.1, 131.0), (137.5, 50.8), (44.3, 132.6), (42.9, 49.5) against module holes (136|44, 130|51); spreader 100 x 111 mm centred (90.6, 79.8); spreader finned bar x 51-130, y 27-46. | mm unless stated | drawing / photo derived | S05, S06 and user photos IMG_1852-1854 (2026-10-27) | Measure the spreader outline and the finned bar height (photo: 100 x 111 mm spreader, bar at the front edge). | No vendor CAD; plate thickness and the finned bar height are assumed.
M242 | cooler.photo_registration.note | Photographs are kept locally, not redistributed. | mm unless stated | drawing / photo derived | S05, S06 and user photos IMG_1852-1854 (2026-10-27) | Measure the spreader outline and the finned bar height (photo: 100 x 111 mm spreader, bar at the front edge). | No vendor CAD; plate thickness and the finned bar height are assumed.
M243 | cooler.source_notes | ["S06 contains generic G48R hardware, not a dimensioned Seeed copper adapter. Its 75/78 mm generic mount pattern must not replace the J501 registered 92 x 79 mm module pattern.", "The 6.8 mm spacers support cooler mounting lugs. They are not added underneath the entire 48.3 mm cooler, which would introduce an unsupported air gap at the thermal contact.", "Spreader plan, fan XY, lug XY, fin pitch, blades and heat-pipe paths are estimates. Pipe count/diameter, fin assembly height, fan frame/rotor dimensions come from S06; spreader thickness and spacer size are user measurements.", "S06 fan table gives 95 x 95 x 15 mm while the frame drawing gives 91.2 x 92.2 mm. Use 95 mm for clearance checks.", "Free-air and shutoff endpoints are not an operating-point or cooling-performance result. Existing WS-RDN-601 CFD remains about that older geometry."] | mm unless stated | drawing / photo derived | S05, S06 and user photos IMG_1852-1854 (2026-10-27) | Measure the spreader outline and the finned bar height (photo: 100 x 111 mm spreader, bar at the front edge). | No vendor CAD; plate thickness and the finned bar height are assumed.
M244 | gmsl.board_size | [103.0, 45.0] | mm unless stated | manufacturer | S02 datasheet page 2 | Measure GMSL outline 103 x 45. | Nominal CAD dimension; printer/material compensation not applied.
M245 | gmsl.preview_origin_in_pcb | [20, 0.0, 17.578] | mm unless stated | provisional assembly placement | S02, S04 GMSL schematic, S10, gmsl_connectoin.png; carrier solids 4822/4823 | Measure XY from carrier left/front edges; verify actual support length and thread. | Mount centers (27,16)/(114,37.2) are CAD-derived candidates. GMSL outline origin and mini-FAKRA XY are photo estimates.
M246 | gmsl.preview_height | 15.7 | mm unless stated | provisional assembly placement | S02, S04 GMSL schematic, S10, gmsl_connectoin.png; carrier solids 4822/4823 | Measure XY from carrier left/front edges; verify actual support length and thread. | Mount centers (27,16)/(114,37.2) are CAD-derived candidates. GMSL outline origin and mini-FAKRA XY are photo estimates.
M247 | gmsl.position_confirmed | false | mm unless stated | provisional assembly placement | S02, S04 GMSL schematic, S10, gmsl_connectoin.png; carrier solids 4822/4823 | Measure XY from carrier left/front edges; verify actual support length and thread. | Mount centers (27,16)/(114,37.2) are CAD-derived candidates. GMSL outline origin and mini-FAKRA XY are photo estimates.
M248 | gmsl.stack_between_pcb_surfaces | 16 | mm unless stated | manufacturer connector specification | S04 GMSL schematic p7 + S07 p29 + S08 | QSH-030-01 + QTH-030-04 gives 16 mm facing-surface stack. | Confirm fitted connector suffixes and seating.
M249 | gmsl.candidate_port_left_edges | [52, 72] | mm unless stated | provisional assembly placement | S02, S04 GMSL schematic, S10, gmsl_connectoin.png; carrier solids 4822/4823 | Measure XY from carrier left/front edges; verify actual support length and thread. | Mount centers (27,16)/(114,37.2) are CAD-derived candidates. GMSL outline origin and mini-FAKRA XY are photo estimates.
M250 | gmsl.candidate_support_centers | [[27, 16], [114, 37.2]] | mm unless stated | provisional assembly placement | S02, S04 GMSL schematic, S10, gmsl_connectoin.png; carrier solids 4822/4823 | Measure XY from carrier left/front edges; verify actual support length and thread. | Mount centers (27,16)/(114,37.2) are CAD-derived candidates. GMSL outline origin and mini-FAKRA XY are photo estimates.
M251 | gmsl.candidate_support_thread | M3 assumed; preserve supplied hardware | mm unless stated | provisional assembly placement | S02, S04 GMSL schematic, S10, gmsl_connectoin.png; carrier solids 4822/4823 | Measure XY from carrier left/front edges; verify actual support length and thread. | Mount centers (27,16)/(114,37.2) are CAD-derived candidates. GMSL outline origin and mini-FAKRA XY are photo estimates.
M252 | user_inserts.M3.tip_diameter | 3.75 | mm unless stated | user supplied | User insert dimensions, 2026-10-23 | Caliper actual insert maximum OD, starter OD and length. | Approximate starter length 1 mm; kit manufacturer unspecified.
M253 | user_inserts.M3.body_diameter | 4.2 | mm unless stated | user supplied | User insert dimensions, 2026-10-23 | Caliper actual insert maximum OD, starter OD and length. | Approximate starter length 1 mm; kit manufacturer unspecified.
M254 | user_inserts.M3.lengths | [4, 6, 8, 10] | mm unless stated | user supplied | User insert dimensions, 2026-10-23 | Caliper actual insert maximum OD, starter OD and length. | Approximate starter length 1 mm; kit manufacturer unspecified.
M255 | user_inserts.M4.tip_diameter | 5.4 | mm unless stated | user supplied | User insert dimensions, 2026-10-23 | Caliper actual insert maximum OD, starter OD and length. | Approximate starter length 1 mm; kit manufacturer unspecified.
M256 | user_inserts.M4.body_diameter | 6 | mm unless stated | user supplied | User insert dimensions, 2026-10-23 | Caliper actual insert maximum OD, starter OD and length. | Approximate starter length 1 mm; kit manufacturer unspecified.
M257 | user_inserts.M4.lengths | [4, 6, 8, 10] | mm unless stated | user supplied | User insert dimensions, 2026-10-23 | Caliper actual insert maximum OD, starter OD and length. | Approximate starter length 1 mm; kit manufacturer unspecified.
M258 | user_inserts.M5.tip_diameter | 6.12 | mm unless stated | user supplied | User insert dimensions, 2026-10-23 | Caliper actual insert maximum OD, starter OD and length. | Approximate starter length 1 mm; kit manufacturer unspecified.
M259 | user_inserts.M5.body_diameter | 7 | mm unless stated | user supplied | User insert dimensions, 2026-10-23 | Caliper actual insert maximum OD, starter OD and length. | Approximate starter length 1 mm; kit manufacturer unspecified.
M260 | user_inserts.M5.lengths | [6, 8, 10] | mm unless stated | user supplied | User insert dimensions, 2026-10-23 | Caliper actual insert maximum OD, starter OD and length. | Approximate starter length 1 mm; kit manufacturer unspecified.
M261 | user_inserts.M6.tip_diameter | 7.25 | mm unless stated | user supplied | User insert dimensions, 2026-10-23 | Caliper actual insert maximum OD, starter OD and length. | Approximate starter length 1 mm; kit manufacturer unspecified.
M262 | user_inserts.M6.body_diameter | 8 | mm unless stated | user supplied | User insert dimensions, 2026-10-23 | Caliper actual insert maximum OD, starter OD and length. | Approximate starter length 1 mm; kit manufacturer unspecified.
M263 | user_inserts.M6.lengths | [6, 8, 10] | mm unless stated | user supplied | User insert dimensions, 2026-10-23 | Caliper actual insert maximum OD, starter OD and length. | Approximate starter length 1 mm; kit manufacturer unspecified.
M264 | user_inserts.source | User message, 2026-10-23 | mm unless stated | user supplied | User insert dimensions, 2026-10-23 | Caliper actual insert maximum OD, starter OD and length. | Approximate starter length 1 mm; kit manufacturer unspecified.
M265 | user_inserts.starter_tip_length_approx | 1.0 | mm unless stated | user supplied | User insert dimensions, 2026-10-23 | Caliper actual insert maximum OD, starter OD and length. | Approximate starter length 1 mm; kit manufacturer unspecified.
M266 | printer.model | Bambu Lab P1S | mm unless stated | user / manufacturer | User: Bambu Lab P1S; https://bambulab.com/en-us/p1p | Confirm centered plate placement and excluded printer regions in Bambu Studio. | Nominal build volume is not a guarantee of printable brim or machine clearance.
M267 | printer.nominal_build_volume | [256, 256, 256] | mm unless stated | user / manufacturer | User: Bambu Lab P1S; https://bambulab.com/en-us/p1p | Confirm centered plate placement and excluded printer regions in Bambu Studio. | Nominal build volume is not a guarantee of printable brim or machine clearance.
M268 | printer.filament | not yet specified | mm unless stated | unknown | User: Bambu Lab P1S; https://bambulab.com/en-us/p1p | Confirm centered plate placement and excluded printer regions in Bambu Studio. | Nominal build volume is not a guarantee of printable brim or machine clearance.
M269 | printer.rail_fit_coupon_required | true | mm unless stated | user / manufacturer | User: Bambu Lab P1S; https://bambulab.com/en-us/p1p | Confirm centered plate placement and excluded printer regions in Bambu Studio. | Nominal build volume is not a guarantee of printable brim or machine clearance.
M270 | ports.front.audio.r | 4.5 | mm unless stated | design service aperture | See docs/cutout-register.csv; basis field names the source solid | Hold the selected mating plug in the printed plate; overmold must pass the window. | Overmold envelopes are typical values, not the user's cables.
M271 | ports.front.audio.label | AUDIO | mm unless stated | design service aperture | See docs/cutout-register.csv; basis field names the source solid | Hold the selected mating plug in the printed plate; overmold must pass the window. | Overmold envelopes are typical values, not the user's cables.
M272 | ports.front.audio.mate.face | [32.652, 1.578, 47.652, 7.578] | mm unless stated | design service aperture | See docs/cutout-register.csv; basis field names the source solid | Hold the selected mating plug in the printed plate; overmold must pass the window. | Overmold envelopes are typical values, not the user's cables.
M273 | ports.front.audio.mate.face_w | 2.0 | mm unless stated | design service aperture | See docs/cutout-register.csv; basis field names the source solid | Hold the selected mating plug in the printed plate; overmold must pass the window. | Overmold envelopes are typical values, not the user's cables.
M274 | ports.front.audio.mate.centre_on | receptacle | mm unless stated | design service aperture | See docs/cutout-register.csv; basis field names the source solid | Hold the selected mating plug in the printed plate; overmold must pass the window. | Overmold envelopes are typical values, not the user's cables.
M275 | ports.front.audio.mate.clearance | 0.5 | mm unless stated | design service aperture | See docs/cutout-register.csv; basis field names the source solid | Hold the selected mating plug in the printed plate; overmold must pass the window. | Overmold envelopes are typical values, not the user's cables.
M276 | ports.front.audio.mate.plugs | [{"family": "trs35", "axis": [35.652, 4.578], "overmold_d": 8.0}, {"family": "trs35", "axis": [44.652, 4.578], "overmold_d": 8.0}] | mm unless stated | design service aperture | See docs/cutout-register.csv; basis field names the source solid | Hold the selected mating plug in the printed plate; overmold must pass the window. | Overmold envelopes are typical values, not the user's cables.
M277 | ports.front.audio.mate.basis | CON1/CON2 (MJ2135 library body) nose D6.0 at x 35.652 / 44.652, axis z 4.578, nose face y -2.0. Measured by slicing references/hardware/carrier-full.stl (+ open shells) at the mating face, 2026-10-25; pins and pegs below the PCB excluded. Plug overmold D8 assumed (slim plugs 5.5-6, common up to 8; the 9 mm jack pitch caps it). | mm unless stated | design service aperture | See docs/cutout-register.csv; basis field names the source solid | Hold the selected mating plug in the printed plate; overmold must pass the window. | Overmold envelopes are typical values, not the user's cables.
M278 | ports.front.audio.basis | One obround over both jacks, centred on the jack axes; sized for two D8 plug overmolds + 0.5. | mm unless stated | design service aperture | See docs/cutout-register.csv; basis field names the source solid | Hold the selected mating plug in the printed plate; overmold must pass the window. | Overmold envelopes are typical values, not the user's cables.
M279 | ports.front.audio.box | [31.152, 0.078, 49.152, 9.078] | mm unless stated | design service aperture | See docs/cutout-register.csv; basis field names the source solid | Hold the selected mating plug in the printed plate; overmold must pass the window. | Overmold envelopes are typical values, not the user's cables.
M280 | ports.front.gmsl.box | [51.2, 1.0, 84.8, 18.4] | mm unless stated | design service aperture | See docs/cutout-register.csv; basis field names the source solid | Hold the selected mating plug in the printed plate; overmold must pass the window. | Overmold envelopes are typical values, not the user's cables.
M281 | ports.front.gmsl.r | 2.0 | mm unless stated | design service aperture | See docs/cutout-register.csv; basis field names the source solid | Hold the selected mating plug in the printed plate; overmold must pass the window. | Overmold envelopes are typical values, not the user's cables.
M282 | ports.front.gmsl.label | GMSL | mm unless stated | design service aperture | See docs/cutout-register.csv; basis field names the source solid | Hold the selected mating plug in the printed plate; overmold must pass the window. | Overmold envelopes are typical values, not the user's cables.
M283 | ports.front.gmsl.gmsl_only | true | mm unless stated | design service aperture | See docs/cutout-register.csv; basis field names the source solid | Hold the selected mating plug in the printed plate; overmold must pass the window. | Overmold envelopes are typical values, not the user's cables.
M284 | ports.front.gmsl.basis | Two candidate FM4 mini-FAKRA mouths; XY provisional (unchanged from Rev 0.4) | mm unless stated | design service aperture | See docs/cutout-register.csv; basis field names the source solid | Hold the selected mating plug in the printed plate; overmold must pass the window. | Overmold envelopes are typical values, not the user's cables.
M285 | ports.front.lan_1g.r | 1.5 | mm unless stated | design service aperture | See docs/cutout-register.csv; basis field names the source solid | Hold the selected mating plug in the printed plate; overmold must pass the window. | Overmold envelopes are typical values, not the user's cables.
M286 | ports.front.lan_1g.label | 1GbE | mm unless stated | design service aperture | See docs/cutout-register.csv; basis field names the source solid | Hold the selected mating plug in the printed plate; overmold must pass the window. | Overmold envelopes are typical values, not the user's cables.
M287 | ports.front.lan_1g.mate.face | [89.876, 1.928, 105.826, 15.428] | mm unless stated | design service aperture | See docs/cutout-register.csv; basis field names the source solid | Hold the selected mating plug in the printed plate; overmold must pass the window. | Overmold envelopes are typical values, not the user's cables.
M288 | ports.front.lan_1g.mate.face_w | 2.081 | mm unless stated | design service aperture | See docs/cutout-register.csv; basis field names the source solid | Hold the selected mating plug in the printed plate; overmold must pass the window. | Overmold envelopes are typical values, not the user's cables.
M289 | ports.front.lan_1g.mate.centre_on | receptacle | mm unless stated | design service aperture | See docs/cutout-register.csv; basis field names the source solid | Hold the selected mating plug in the printed plate; overmold must pass the window. | Overmold envelopes are typical values, not the user's cables.
M290 | ports.front.lan_1g.mate.clearance | 0.5 | mm unless stated | design service aperture | See docs/cutout-register.csv; basis field names the source solid | Hold the selected mating plug in the printed plate; overmold must pass the window. | Overmold envelopes are typical values, not the user's cables.
M291 | ports.front.lan_1g.mate.plugs | [{"family": "rj45", "cavity": [91.901, 4.678, 103.801, 14.574], "latch": "up"}] | mm unless stated | design service aperture | See docs/cutout-register.csv; basis field names the source solid | Hold the selected mating plug in the printed plate; overmold must pass the window. | Overmold envelopes are typical values, not the user's cables.
M292 | ports.front.lan_1g.mate.basis | J5 LINK-PP LPJG16459BENL shield face and plug opening (latch up). Measured by slicing references/hardware/carrier-full.stl (+ open shells) at the mating face, 2026-10-25; pins and pegs below the PCB excluded. | mm unless stated | design service aperture | See docs/cutout-register.csv; basis field names the source solid | Hold the selected mating plug in the printed plate; overmold must pass the window. | Overmold envelopes are typical values, not the user's cables.
M293 | ports.front.lan_1g.basis | Centred on the J5 face; clears the RJ45 plug body and latch lever on insertion + 0.5; face LEDs visible. | mm unless stated | design service aperture | See docs/cutout-register.csv; basis field names the source solid | Hold the selected mating plug in the printed plate; overmold must pass the window. | Overmold envelopes are typical values, not the user's cables.
M294 | ports.front.lan_1g.box | [89.376, 0.782, 106.326, 16.574] | mm unless stated | design service aperture | See docs/cutout-register.csv; basis field names the source solid | Hold the selected mating plug in the printed plate; overmold must pass the window. | Overmold envelopes are typical values, not the user's cables.
M295 | ports.front.lan_10g.r | 1.5 | mm unless stated | design service aperture | See docs/cutout-register.csv; basis field names the source solid | Hold the selected mating plug in the printed plate; overmold must pass the window. | Overmold envelopes are typical values, not the user's cables.
M296 | ports.front.lan_10g.label | 10GbE | mm unless stated | design service aperture | See docs/cutout-register.csv; basis field names the source solid | Hold the selected mating plug in the printed plate; overmold must pass the window. | Overmold envelopes are typical values, not the user's cables.
M297 | ports.front.lan_10g.mate.face | [109.716, 1.828, 126.316, 15.328] | mm unless stated | design service aperture | See docs/cutout-register.csv; basis field names the source solid | Hold the selected mating plug in the printed plate; overmold must pass the window. | Overmold envelopes are typical values, not the user's cables.
M298 | ports.front.lan_10g.mate.face_w | 2.141 | mm unless stated | design service aperture | See docs/cutout-register.csv; basis field names the source solid | Hold the selected mating plug in the printed plate; overmold must pass the window. | Overmold envelopes are typical values, not the user's cables.
M299 | ports.front.lan_10g.mate.centre_on | receptacle | mm unless stated | design service aperture | See docs/cutout-register.csv; basis field names the source solid | Hold the selected mating plug in the printed plate; overmold must pass the window. | Overmold envelopes are typical values, not the user's cables.
M300 | ports.front.lan_10g.mate.clearance | 0.5 | mm unless stated | design service aperture | See docs/cutout-register.csv; basis field names the source solid | Hold the selected mating plug in the printed plate; overmold must pass the window. | Overmold envelopes are typical values, not the user's cables.
M301 | ports.front.lan_10g.mate.plugs | [{"family": "rj45", "cavity": [112.091, 4.548, 123.941, 14.431], "latch": "up"}] | mm unless stated | design service aperture | See docs/cutout-register.csv; basis field names the source solid | Hold the selected mating plug in the printed plate; overmold must pass the window. | Overmold envelopes are typical values, not the user's cables.
M302 | ports.front.lan_10g.mate.basis | J12 LINK-PP LPJK9436BENL shield face and plug opening (latch up). Measured by slicing references/hardware/carrier-full.stl (+ open shells) at the mating face, 2026-10-25; pins and pegs below the PCB excluded. | mm unless stated | design service aperture | See docs/cutout-register.csv; basis field names the source solid | Hold the selected mating plug in the printed plate; overmold must pass the window. | Overmold envelopes are typical values, not the user's cables.
M303 | ports.front.lan_10g.basis | Centred on the J12 face; clears the RJ45 plug body and latch lever on insertion + 0.5. | mm unless stated | design service aperture | See docs/cutout-register.csv; basis field names the source solid | Hold the selected mating plug in the printed plate; overmold must pass the window. | Overmold envelopes are typical values, not the user's cables.
M304 | ports.front.lan_10g.box | [109.216, 0.725, 126.816, 16.431] | mm unless stated | design service aperture | See docs/cutout-register.csv; basis field names the source solid | Hold the selected mating plug in the printed plate; overmold must pass the window. | Overmold envelopes are typical values, not the user's cables.
M305 | ports.front.led.box | [127.937, 2.203, 131.882, 11.153] | mm unless stated | design service aperture | See docs/cutout-register.csv; basis field names the source solid | Hold the selected mating plug in the printed plate; overmold must pass the window. | Overmold envelopes are typical values, not the user's cables.
M306 | ports.front.led.r | 1.0 | mm unless stated | design service aperture | See docs/cutout-register.csv; basis field names the source solid | Hold the selected mating plug in the printed plate; overmold must pass the window. | Overmold envelopes are typical values, not the user's cables.
M307 | ports.front.led.label |  | mm unless stated | design service aperture | See docs/cutout-register.csv; basis field names the source solid | Hold the selected mating plug in the printed plate; overmold must pass the window. | Overmold envelopes are typical values, not the user's cables.
M308 | ports.front.led.basis | LED4 light pipes x 128.437..131.382, z 2.703..10.653 at y -1.5 (+0.5); bridged to neighbours when the web is < min_panel_web. Measured by slicing references/hardware/carrier-full.stl (+ open shells) at the mating face, 2026-10-25; pins and pegs below the PCB excluded. | mm unless stated | design service aperture | See docs/cutout-register.csv; basis field names the source solid | Hold the selected mating plug in the printed plate; overmold must pass the window. | Overmold envelopes are typical values, not the user's cables.
M309 | ports.front.dc_in.r | 0.5 | mm unless stated | design service aperture | See docs/cutout-register.csv; basis field names the source solid | Hold the selected mating plug in the printed plate; overmold must pass the window. | Overmold envelopes are typical values, not the user's cables.
M310 | ports.front.dc_in.label | DC IN 12-36V | mm unless stated | design service aperture | See docs/cutout-register.csv; basis field names the source solid | Hold the selected mating plug in the printed plate; overmold must pass the window. | Overmold envelopes are typical values, not the user's cables.
M311 | ports.front.dc_in.marks | [{"text": "\u2212", "x": 141.91}, {"text": "+", "x": 146.99}] | mm unless stated | design service aperture | See docs/cutout-register.csv; basis field names the source solid | Hold the selected mating plug in the printed plate; overmold must pass the window. | Overmold envelopes are typical values, not the user's cables.
M312 | ports.front.dc_in.polarity_basis | J2 pin 1 = DCJ_IN (12-36 V, through F1), pin 2 = GND (carrier schematic sheet 7). Pins at x 141.91 / 146.99 are identical in the STEP; pin 1 is taken as the pin next to the F1 fuse holder (x 147). INFERRED, verify with a meter before first power-up. | mm unless stated | design service aperture | See docs/cutout-register.csv; basis field names the source solid | Hold the selected mating plug in the printed plate; overmold must pass the window. | Overmold envelopes are typical values, not the user's cables.
M313 | ports.front.dc_in.mate.face | [134.29, 1.578, 154.61, 9.978] | mm unless stated | design service aperture | See docs/cutout-register.csv; basis field names the source solid | Hold the selected mating plug in the printed plate; overmold must pass the window. | Overmold envelopes are typical values, not the user's cables.
M314 | ports.front.dc_in.mate.face_w | 2.7 | mm unless stated | design service aperture | See docs/cutout-register.csv; basis field names the source solid | Hold the selected mating plug in the printed plate; overmold must pass the window. | Overmold envelopes are typical values, not the user's cables.
M315 | ports.front.dc_in.mate.centre_on | plug | mm unless stated | design service aperture | See docs/cutout-register.csv; basis field names the source solid | Hold the selected mating plug in the printed plate; overmold must pass the window. | Overmold envelopes are typical values, not the user's cables.
M316 | ports.front.dc_in.mate.clearance | 0.5 | mm unless stated | design service aperture | See docs/cutout-register.csv; basis field names the source solid | Hold the selected mating plug in the printed plate; overmold must pass the window. | Overmold envelopes are typical values, not the user's cables.
M317 | ports.front.dc_in.mate.plugs | [{"family": "terminal_plug_flanged", "screws": [[136.83, 5.328], [152.07, 5.328]], "positions": 2, "pitch": 5.08, "basis": "Phoenix Contact MSTB 2,5/2-STF-5,08 (1777989) dimensional drawing: 20.17 W x 15 H, 18.2 long incl. 8.3 tongue"}] | mm unless stated | design service aperture | See docs/cutout-register.csv; basis field names the source solid | Hold the selected mating plug in the printed plate; overmold must pass the window. | Overmold envelopes are typical values, not the user's cables.
M318 | ports.front.dc_in.mate.basis | J2 YL032-100-002 2-pin 5.08 mm horizontal header with screw flanges (GF style); flange screw holes at x 136.83 / 152.07 (15.24 apart, matches the STF plug), z 5.328; face y -2.7. Measured by slicing references/hardware/carrier-full.stl (+ open shells) at the mating face, 2026-10-25; pins and pegs below the PCB excluded. | mm unless stated | design service aperture | See docs/cutout-register.csv; basis field names the source solid | Hold the selected mating plug in the printed plate; overmold must pass the window. | Overmold envelopes are typical values, not the user's cables.
M319 | ports.front.dc_in.basis | Sized and centred on the mated screw-flange plug, which is 15 mm tall on an 8.4 mm header and passes through the plate (body 9.9 mm outside the header face). Wire the plug before inserting it: its clamp screws face up. | mm unless stated | design service aperture | See docs/cutout-register.csv; basis field names the source solid | Hold the selected mating plug in the printed plate; overmold must pass the window. | Overmold envelopes are typical values, not the user's cables.
M320 | ports.front.dc_in.box | [133.79, 0.928, 155.11, 16.928] | mm unless stated | design service aperture | See docs/cutout-register.csv; basis field names the source solid | Hold the selected mating plug in the printed plate; overmold must pass the window. | Overmold envelopes are typical values, not the user's cables.
M321 | ports.rear.io_terminal.r | 0.5 | mm unless stated | design service aperture | See docs/cutout-register.csv; basis field names the source solid | Hold the selected mating plug in the printed plate; overmold must pass the window. | Overmold envelopes are typical values, not the user's cables.
M322 | ports.rear.io_terminal.label | I/O | mm unless stated | design service aperture | See docs/cutout-register.csv; basis field names the source solid | Hold the selected mating plug in the printed plate; overmold must pass the window. | Overmold envelopes are typical values, not the user's cables.
M323 | ports.rear.io_terminal.mate.face | [26.605, 1.578, 65.905, 16.897] | mm unless stated | design service aperture | See docs/cutout-register.csv; basis field names the source solid | Hold the selected mating plug in the printed plate; overmold must pass the window. | Overmold envelopes are typical values, not the user's cables.
M324 | ports.rear.io_terminal.mate.face_w | 165.5 | mm unless stated | design service aperture | See docs/cutout-register.csv; basis field names the source solid | Hold the selected mating plug in the printed plate; overmold must pass the window. | Overmold envelopes are typical values, not the user's cables.
M325 | ports.rear.io_terminal.mate.centre_on | receptacle | mm unless stated | design service aperture | See docs/cutout-register.csv; basis field names the source solid | Hold the selected mating plug in the printed plate; overmold must pass the window. | Overmold envelopes are typical values, not the user's cables.
M326 | ports.rear.io_terminal.mate.clearance | 0.5 | mm unless stated | design service aperture | See docs/cutout-register.csv; basis field names the source solid | Hold the selected mating plug in the printed plate; overmold must pass the window. | Overmold envelopes are typical values, not the user's cables.
M327 | ports.rear.io_terminal.mate.plugs | [{"family": "face_plug", "outline": [26.605, 1.578, 65.905, 16.897]}] | mm unless stated | design service aperture | See docs/cutout-register.csv; basis field names the source solid | Hold the selected mating plug in the printed plate; overmold must pass the window. | Overmold envelopes are typical values, not the user's cables.
M328 | ports.rear.io_terminal.mate.basis | J25 + J2_TB1 2x10 3.81 mm push-in plug, modelled mated in the carrier STEP (its face shows the wire entries). Measured by slicing references/hardware/carrier-full.stl (+ open shells) at the mating face, 2026-10-25; pins and pegs below the PCB excluded. | mm unless stated | design service aperture | See docs/cutout-register.csv; basis field names the source solid | Hold the selected mating plug in the printed plate; overmold must pass the window. | Overmold envelopes are typical values, not the user's cables.
M329 | ports.rear.io_terminal.basis | Centred on the mated J25 plug face + 0.5. | mm unless stated | design service aperture | See docs/cutout-register.csv; basis field names the source solid | Hold the selected mating plug in the printed plate; overmold must pass the window. | Overmold envelopes are typical values, not the user's cables.
M330 | ports.rear.io_terminal.box | [26.105, 1.078, 66.405, 17.397] | mm unless stated | design service aperture | See docs/cutout-register.csv; basis field names the source solid | Hold the selected mating plug in the printed plate; overmold must pass the window. | Overmold envelopes are typical values, not the user's cables.
M331 | ports.rear.hdmi.r | 2.0 | mm unless stated | design service aperture | See docs/cutout-register.csv; basis field names the source solid | Hold the selected mating plug in the printed plate; overmold must pass the window. | Overmold envelopes are typical values, not the user's cables.
M332 | ports.rear.hdmi.label | HDMI | mm unless stated | design service aperture | See docs/cutout-register.csv; basis field names the source solid | Hold the selected mating plug in the printed plate; overmold must pass the window. | Overmold envelopes are typical values, not the user's cables.
M333 | ports.rear.hdmi.mate.face | [71.515, 3.178, 76.865, 17.978] | mm unless stated | design service aperture | See docs/cutout-register.csv; basis field names the source solid | Hold the selected mating plug in the printed plate; overmold must pass the window. | Overmold envelopes are typical values, not the user's cables.
M334 | ports.rear.hdmi.mate.face_w | 164.786 | mm unless stated | design service aperture | See docs/cutout-register.csv; basis field names the source solid | Hold the selected mating plug in the printed plate; overmold must pass the window. | Overmold envelopes are typical values, not the user's cables.
M335 | ports.rear.hdmi.mate.centre_on | plug | mm unless stated | design service aperture | See docs/cutout-register.csv; basis field names the source solid | Hold the selected mating plug in the printed plate; overmold must pass the window. | Overmold envelopes are typical values, not the user's cables.
M336 | ports.rear.hdmi.mate.clearance | 0.25 | mm unless stated | design service aperture | See docs/cutout-register.csv; basis field names the source solid | Hold the selected mating plug in the printed plate; overmold must pass the window. | Overmold envelopes are typical values, not the user's cables.
M337 | ports.rear.hdmi.mate.plugs | [{"family": "overmold", "centre": [74.19, 10.578], "width": 11.0, "height": 21.0, "r": 1.75}] | mm unless stated | design service aperture | See docs/cutout-register.csv; basis field names the source solid | Hold the selected mating plug in the printed plate; overmold must pass the window. | Overmold envelopes are typical values, not the user's cables.
M338 | ports.rear.hdmi.mate.basis | J8 Foxconn QJ3119C vertical HDMI face; typical HDMI overmold 21 x 11 rotated (assumed). Measured by slicing references/hardware/carrier-full.stl (+ open shells) at the mating face, 2026-10-25; pins and pegs below the PCB excluded. | mm unless stated | design service aperture | See docs/cutout-register.csv; basis field names the source solid | Hold the selected mating plug in the printed plate; overmold must pass the window. | Overmold envelopes are typical values, not the user's cables.
M339 | ports.rear.hdmi.basis | Centred on the J8 mouth; 11 x 21 rotated overmold + 0.25. | mm unless stated | design service aperture | See docs/cutout-register.csv; basis field names the source solid | Hold the selected mating plug in the printed plate; overmold must pass the window. | Overmold envelopes are typical values, not the user's cables.
M340 | ports.rear.hdmi.box | [68.44, -0.172, 79.94, 21.328] | mm unless stated | design service aperture | See docs/cutout-register.csv; basis field names the source solid | Hold the selected mating plug in the printed plate; overmold must pass the window. | Overmold envelopes are typical values, not the user's cables.
M341 | ports.rear.usb_a.r | 2.0 | mm unless stated | design service aperture | See docs/cutout-register.csv; basis field names the source solid | Hold the selected mating plug in the printed plate; overmold must pass the window. | Overmold envelopes are typical values, not the user's cables.
M342 | ports.rear.usb_a.label | USB | mm unless stated | design service aperture | See docs/cutout-register.csv; basis field names the source solid | Hold the selected mating plug in the printed plate; overmold must pass the window. | Overmold envelopes are typical values, not the user's cables.
M343 | ports.rear.usb_a.mate.face | [82.251, 3.056, 95.351, 17.276] | mm unless stated | design service aperture | See docs/cutout-register.csv; basis field names the source solid | Hold the selected mating plug in the printed plate; overmold must pass the window. | Overmold envelopes are typical values, not the user's cables.
M344 | ports.rear.usb_a.mate.face_w | 165.265 | mm unless stated | design service aperture | See docs/cutout-register.csv; basis field names the source solid | Hold the selected mating plug in the printed plate; overmold must pass the window. | Overmold envelopes are typical values, not the user's cables.
M345 | ports.rear.usb_a.mate.clearance | 0.25 | mm unless stated | design service aperture | See docs/cutout-register.csv; basis field names the source solid | Hold the selected mating plug in the printed plate; overmold must pass the window. | Overmold envelopes are typical values, not the user's cables.
M346 | ports.rear.usb_a.mate.plugs | [{"family": "overmold", "centre": [88.8, 5.55], "width": 16.0, "height": 8.0, "r": 1.75}, {"family": "overmold", "centre": [88.8, 14.65], "width": 16.0, "height": 8.0, "r": 1.75}] | mm unless stated | design service aperture | See docs/cutout-register.csv; basis field names the source solid | Hold the selected mating plug in the printed plate; overmold must pass the window. | Overmold envelopes are typical values, not the user's cables.
M347 | ports.rear.usb_a.mate.basis | J7 Foxconn UAA111C stacked USB-A, port centres z 5.55 / 14.65; typical 16 x 8 overmolds (assumed). Measured by slicing references/hardware/carrier-full.stl (+ open shells) at the mating face, 2026-10-25; pins and pegs below the PCB excluded. | mm unless stated | design service aperture | See docs/cutout-register.csv; basis field names the source solid | Hold the selected mating plug in the printed plate; overmold must pass the window. | Overmold envelopes are typical values, not the user's cables.
M348 | ports.rear.usb_a.basis | Two 16 x 8 USB-A overmolds + 0.25. | mm unless stated | design service aperture | See docs/cutout-register.csv; basis field names the source solid | Hold the selected mating plug in the printed plate; overmold must pass the window. | Overmold envelopes are typical values, not the user's cables.
M349 | ports.rear.usb_a.box | [80.55, 1.3, 97.05, 18.9] | mm unless stated | design service aperture | See docs/cutout-register.csv; basis field names the source solid | Hold the selected mating plug in the printed plate; overmold must pass the window. | Overmold envelopes are typical values, not the user's cables.
M350 | ports.rear.usb_a_vertical.r | 2.0 | mm unless stated | design service aperture | See docs/cutout-register.csv; basis field names the source solid | Hold the selected mating plug in the printed plate; overmold must pass the window. | Overmold envelopes are typical values, not the user's cables.
M351 | ports.rear.usb_a_vertical.label |  | mm unless stated | design service aperture | See docs/cutout-register.csv; basis field names the source solid | Hold the selected mating plug in the printed plate; overmold must pass the window. | Overmold envelopes are typical values, not the user's cables.
M352 | ports.rear.usb_a_vertical.mate.face_w | 164.698 | mm unless stated | design service aperture | See docs/cutout-register.csv; basis field names the source solid | Hold the selected mating plug in the printed plate; overmold must pass the window. | Overmold envelopes are typical values, not the user's cables.
M353 | ports.rear.usb_a_vertical.mate.clearance | 0.25 | mm unless stated | design service aperture | See docs/cutout-register.csv; basis field names the source solid | Hold the selected mating plug in the printed plate; overmold must pass the window. | Overmold envelopes are typical values, not the user's cables.
M354 | ports.rear.usb_a_vertical.mate.plugs | [{"family": "overmold", "centre": [104.5, 8.5], "width": 8.0, "height": 16.0, "r": 1.75}] | mm unless stated | design service aperture | See docs/cutout-register.csv; basis field names the source solid | Hold the selected mating plug in the printed plate; overmold must pass the window. | Overmold envelopes are typical values, not the user's cables.
M355 | ports.rear.usb_a_vertical.mate.basis | J26 STEP is an incomplete 3.8 mm placeholder; footprint says 13.85 mm. Corrected envelope, centre assumed; 8 x 16 rotated overmold. | mm unless stated | design service aperture | See docs/cutout-register.csv; basis field names the source solid | Hold the selected mating plug in the printed plate; overmold must pass the window. | Overmold envelopes are typical values, not the user's cables.
M356 | ports.rear.usb_a_vertical.basis | J26 corrected envelope; 8 x 16 rotated overmold + 0.25. Verify on hardware. | mm unless stated | design service aperture | See docs/cutout-register.csv; basis field names the source solid | Hold the selected mating plug in the printed plate; overmold must pass the window. | Overmold envelopes are typical values, not the user's cables.
M357 | ports.rear.usb_a_vertical.box | [100.25, 0.25, 108.75, 16.75] | mm unless stated | design service aperture | See docs/cutout-register.csv; basis field names the source solid | Hold the selected mating plug in the printed plate; overmold must pass the window. | Overmold envelopes are typical values, not the user's cables.
M358 | ports.rear.usb_c.r | 3.5 | mm unless stated | design service aperture | See docs/cutout-register.csv; basis field names the source solid | Hold the selected mating plug in the printed plate; overmold must pass the window. | Overmold envelopes are typical values, not the user's cables.
M359 | ports.rear.usb_c.label | USB-C | mm unless stated | design service aperture | See docs/cutout-register.csv; basis field names the source solid | Hold the selected mating plug in the printed plate; overmold must pass the window. | Overmold envelopes are typical values, not the user's cables.
M360 | ports.rear.usb_c.label_above | true | mm unless stated | design service aperture | See docs/cutout-register.csv; basis field names the source solid | Hold the selected mating plug in the printed plate; overmold must pass the window. | Overmold envelopes are typical values, not the user's cables.
M361 | ports.rear.usb_c.mate.face | [111.88, -3.16, 122.63, 0.0] | mm unless stated | design service aperture | See docs/cutout-register.csv; basis field names the source solid | Hold the selected mating plug in the printed plate; overmold must pass the window. | Overmold envelopes are typical values, not the user's cables.
M362 | ports.rear.usb_c.mate.face_w | 164.53 | mm unless stated | design service aperture | See docs/cutout-register.csv; basis field names the source solid | Hold the selected mating plug in the printed plate; overmold must pass the window. | Overmold envelopes are typical values, not the user's cables.
M363 | ports.rear.usb_c.mate.clearance | 0.25 | mm unless stated | design service aperture | See docs/cutout-register.csv; basis field names the source solid | Hold the selected mating plug in the printed plate; overmold must pass the window. | Overmold envelopes are typical values, not the user's cables.
M364 | ports.rear.usb_c.mate.plugs | [{"family": "overmold", "centre": [117.26, -1.58], "width": 12.5, "height": 7.5, "r": 3.25}, {"family": "overmold", "centre": [130.25, -1.11], "width": 12.5, "height": 7.5, "r": 3.25}] | mm unless stated | design service aperture | See docs/cutout-register.csv; basis field names the source solid | Hold the selected mating plug in the printed plate; overmold must pass the window. | Overmold envelopes are typical values, not the user's cables.
M365 | ports.rear.usb_c.mate.basis | J9 (117.26,-1.58) and J10 (130.25,-1.11) underside USB-C mouths; typical 12.5 x 7.5 overmolds (assumed). Measured by slicing references/hardware/carrier-full.stl (+ open shells) at the mating face, 2026-10-25; pins and pegs below the PCB excluded. | mm unless stated | design service aperture | See docs/cutout-register.csv; basis field names the source solid | Hold the selected mating plug in the printed plate; overmold must pass the window. | Overmold envelopes are typical values, not the user's cables.
M366 | ports.rear.usb_c.basis | Two USB-C overmolds + 0.25, side by side. | mm unless stated | design service aperture | See docs/cutout-register.csv; basis field names the source solid | Hold the selected mating plug in the printed plate; overmold must pass the window. | Overmold envelopes are typical values, not the user's cables.
M367 | ports.rear.usb_c.box | [110.76, -5.58, 136.75, 2.89] | mm unless stated | design service aperture | See docs/cutout-register.csv; basis field names the source solid | Hold the selected mating plug in the printed plate; overmold must pass the window. | Overmold envelopes are typical values, not the user's cables.
M368 | plug_envelopes_note | Every external port window is derived from its mated plug (cadagent.connectors via cad/ports.py), never from a receptacle bounding box: bounding boxes include pins below the board and miss plugs larger than the receptacle. tools/check_ports.py sweeps each plug in along its axis against the printed parts. | mm unless stated | design rationale | cad/parameters.json | Measure actual cable overmolds. | Nominal CAD dimension; printer/material compensation not applied.
M369 | underside_envelopes.frame | PCB datum [x0,y0,z0,x1,y1,z1]; z below the PCB underside is negative | mm unless stated | design selection | cad/parameters.json + cad/build.py | Compare parameter to exported STEP; print a coupon for fits. | Nominal CAD dimension; printer/material compensation not applied.
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
