mvalancy/j501-agx-orin/exports/chimney_cap.step

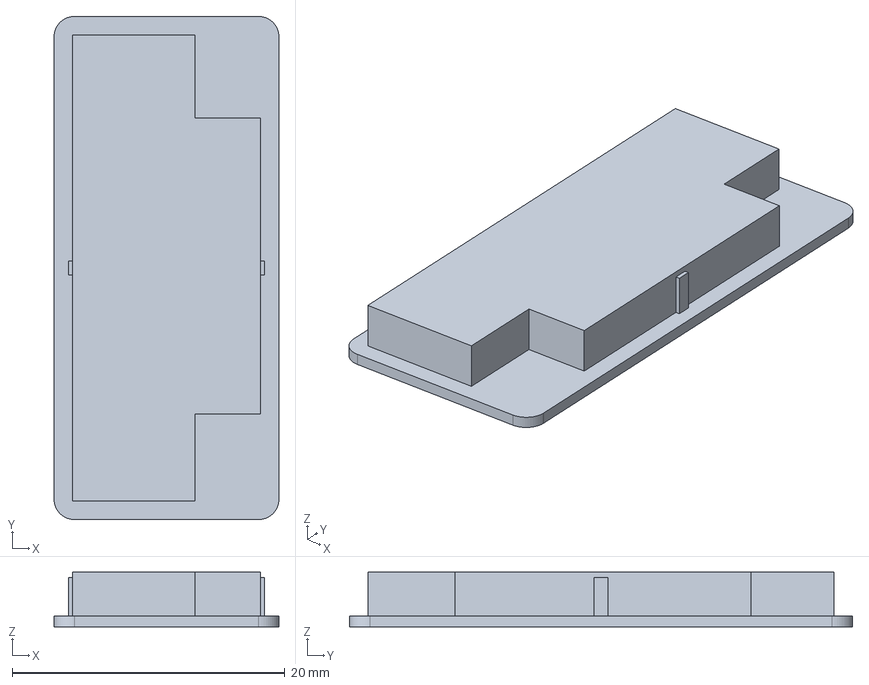
[picture p121: CAD file, 2026-10-31]
exports/chimney_cap.step
16.5 x 36.9 x 4.00 mm
