mvalancy/j501-agx-orin/exports/cooler-study/fan_frame.step

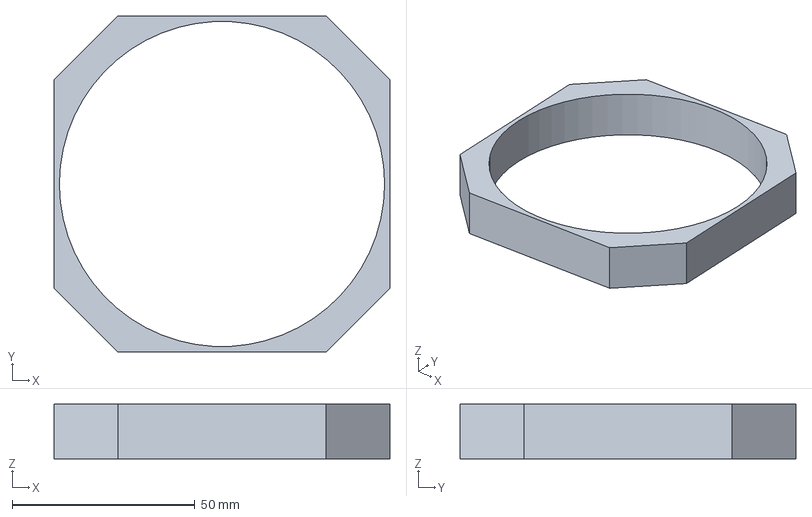
[picture p122: CAD file, 2026-10-31]
exports/cooler-study/fan_frame.step
92.0 x 92.0 x 15.0 mm
