mvalancy/j501-agx-orin/exports/showcase-antennas/cell_2_antenna.stl

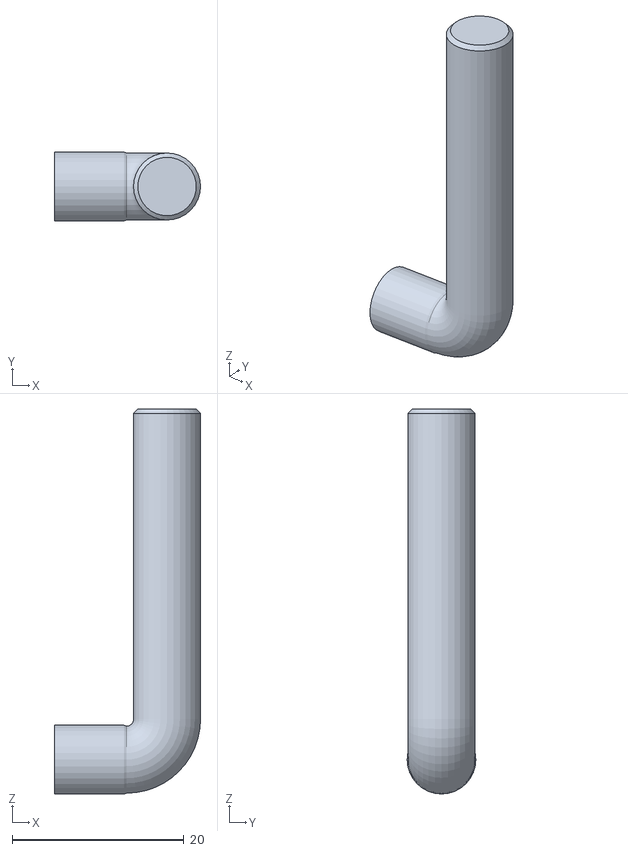
[picture p123: CAD file, 2026-11-12]
exports/showcase-antennas/cell_2_antenna.stl
17.0 x 8.00 x 44.8
