mvalancy/j501-agx-orin/exports/topology/roof.stl

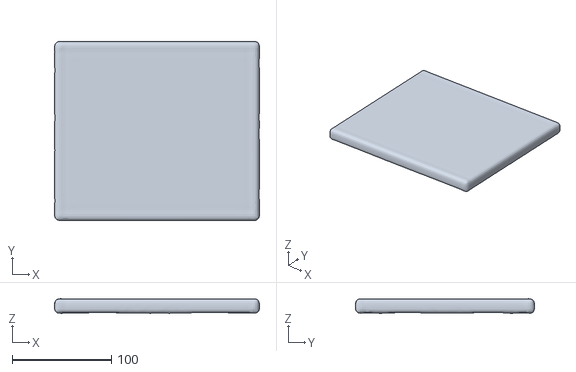
[picture p124: CAD file, 2026-10-27]
exports/topology/roof.stl
207.0 x 181.0 x 14.7
