mvalancy/j501-agx-orin/references/pcb-outline.step

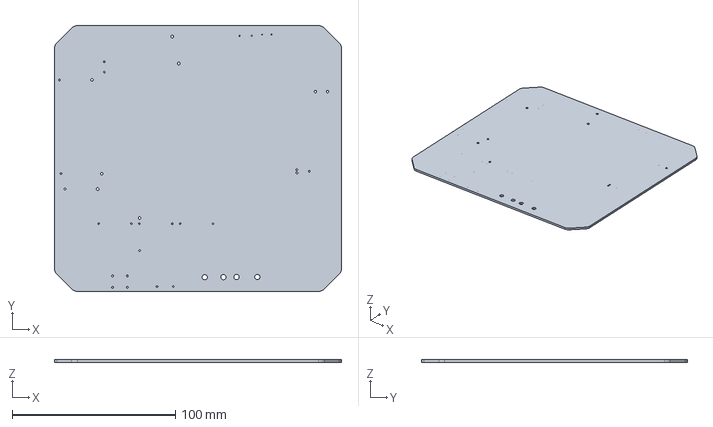
[picture p125: CAD file, 2026-10-25]
references/pcb-outline.step
176.0 x 163.0 x 1.58 mm
