mvalancy/j501-agx-orin/exports/cooler-study/agx_reference.step

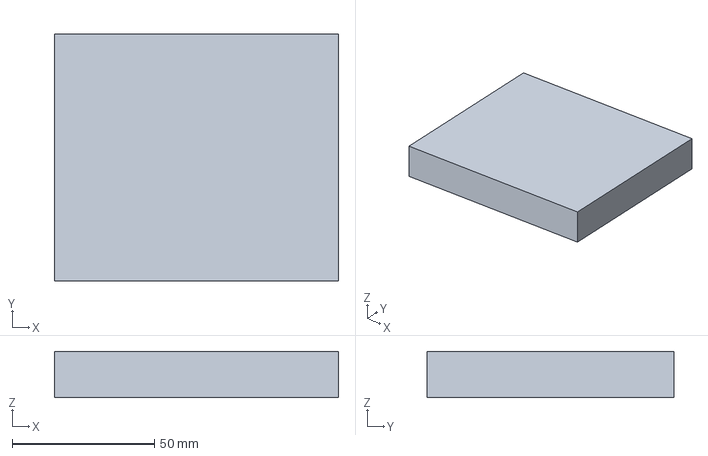
[picture p126: CAD file, 2026-10-31]
exports/cooler-study/agx_reference.step
100.0 x 87.0 x 16.3 mm
