mvalancy/j501-agx-orin/exports/rail_key.step

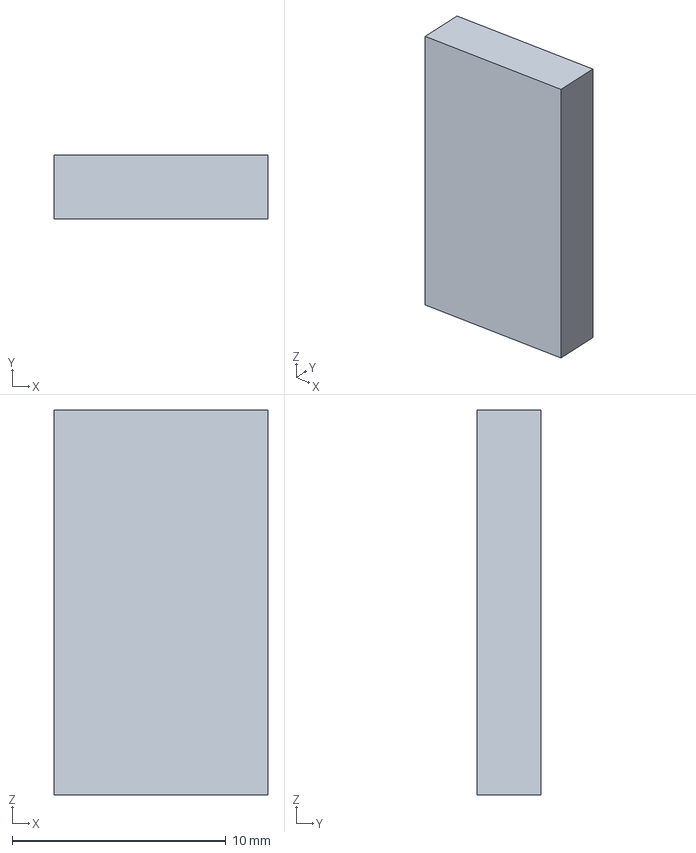
[picture p127: CAD file, 2026-10-31]
exports/rail_key.step
10.0 x 3.00 x 18.0 mm
