mvalancy/j501-agx-orin/exports/topology/floor.stl

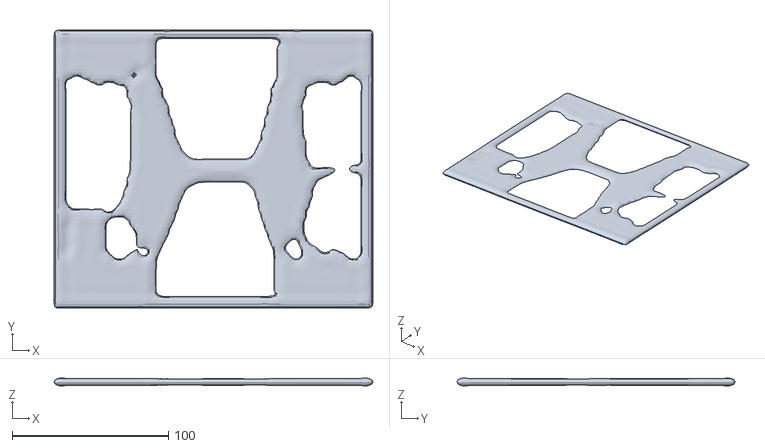
[picture p128: CAD file, 2026-10-27]
exports/topology/floor.stl
204.2 x 178.2 x 5.09
