mvalancy/j501-agx-orin/exports/showcase-antennas/wifi_2_antenna.stl

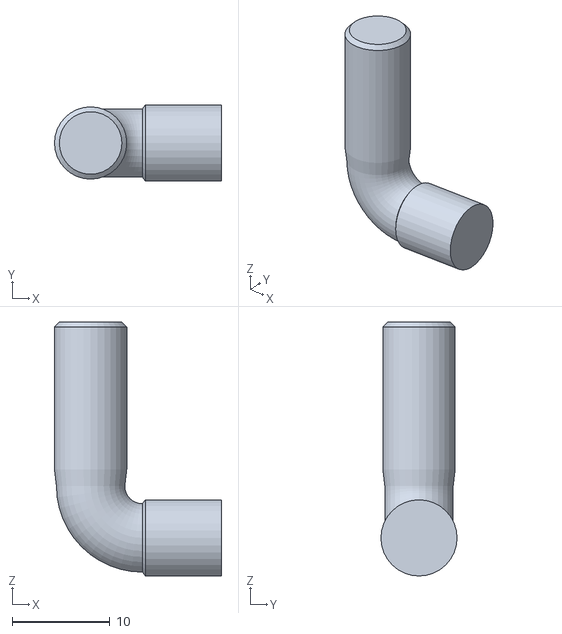
[picture p129: CAD file, 2026-11-12]
exports/showcase-antennas/wifi_2_antenna.stl
17.1 x 7.80 x 26.0
