mvalancy/j501-agx-orin/exports/storage_35.step

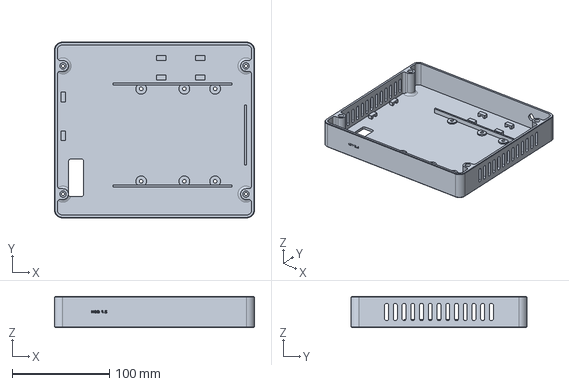
[picture p130: CAD file, 2026-10-31]
exports/storage_35.step
206.0 x 181.0 x 32.0 mm
