mvalancy/j501-agx-orin/exports/cooler-study/ws-rdn-601-envelope.step

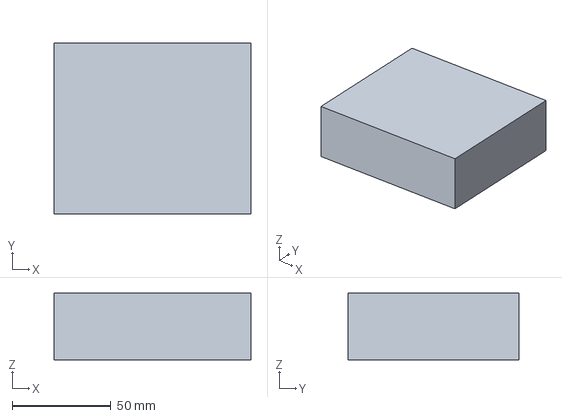
[picture p131: CAD file, 2026-10-31]
exports/cooler-study/ws-rdn-601-envelope.step
100.0 x 87.0 x 34.0 mm
