mvalancy/j501-agx-orin/exports/side_hatch.step

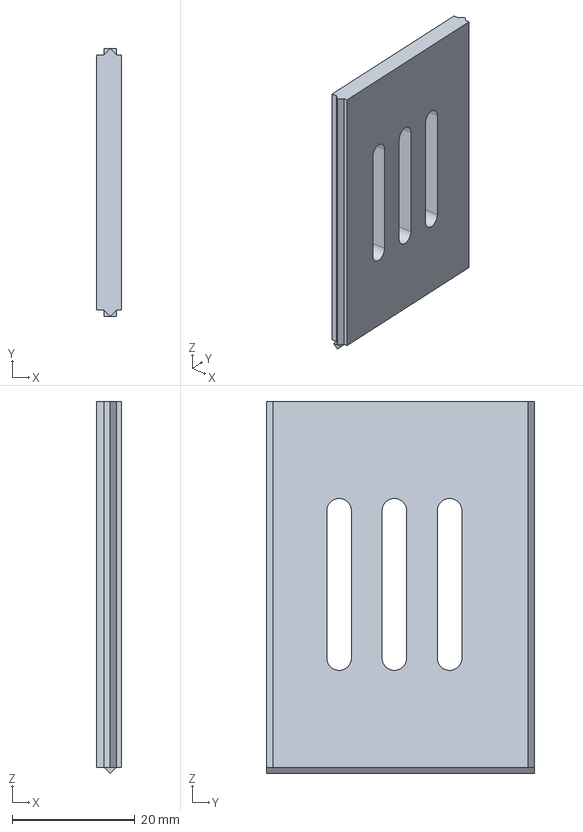
[picture p132: CAD file, 2026-10-31]
exports/side_hatch.step
4.00 x 43.6 x 60.6 mm
