mvalancy/j501-agx-orin/exports/cooler-study/spacers.step

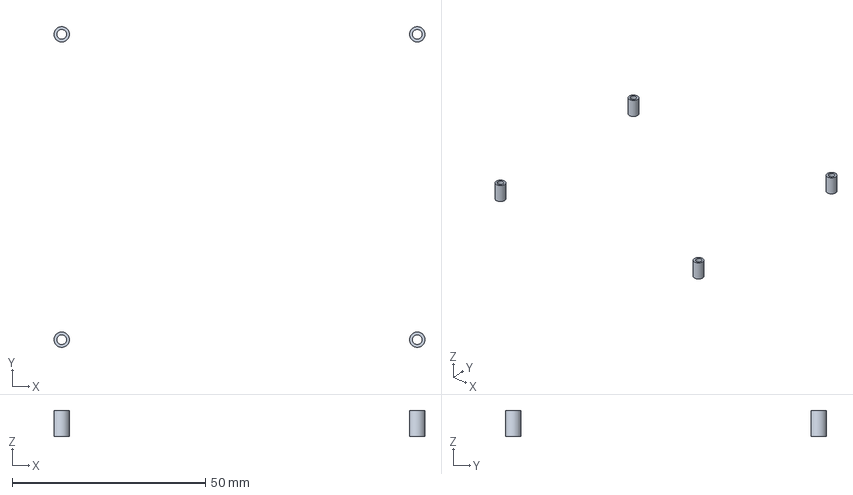
[picture p133: CAD file, 2026-10-31]
exports/cooler-study/spacers.step
96.0 x 83.0 x 6.80 mm
spacers.1
spacers.2
spacers.3
spacers.4
