mvalancy/j501-agx-orin/exports/front_no_gmsl.step

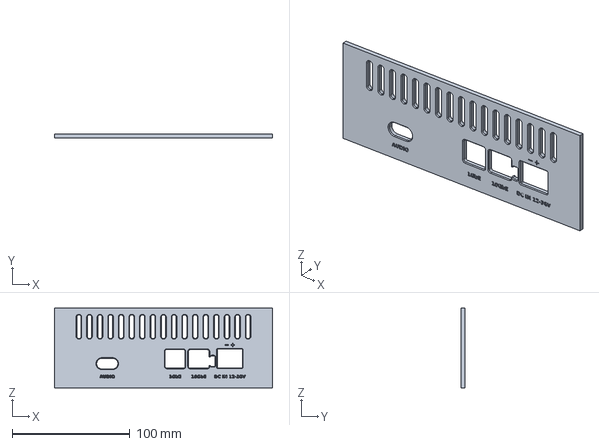
[picture p134: CAD file, 2026-10-31]
exports/front_no_gmsl.step
185.5 x 3.00 x 67.8 mm
