mvalancy/j501-agx-orin/exports/cooler-study/module_axes_reference.step

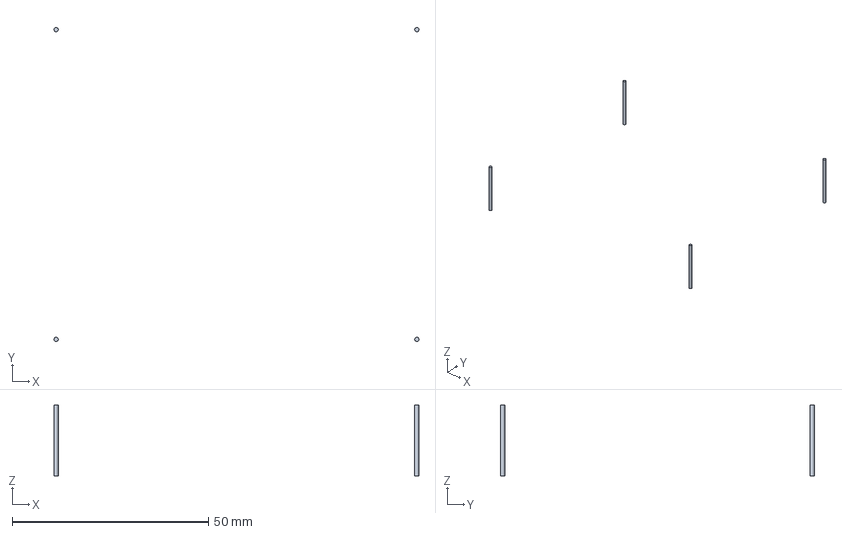
[picture p135: CAD file, 2026-10-31]
exports/cooler-study/module_axes_reference.step
93.1 x 80.1 x 18.0 mm
module_axes_reference.1
module_axes_reference.2
module_axes_reference.3
module_axes_reference.4
