mvalancy/j501-agx-orin/exports/storage_mount_plate.step

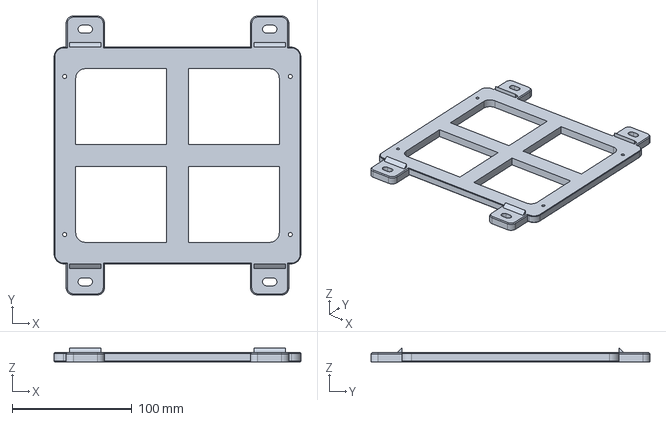
[picture p136: CAD file, 2026-10-31]
exports/storage_mount_plate.step
206.0 x 233.0 x 12.0 mm
