mvalancy/j501-agx-orin/exports/cooler-study/g48r-reference.step

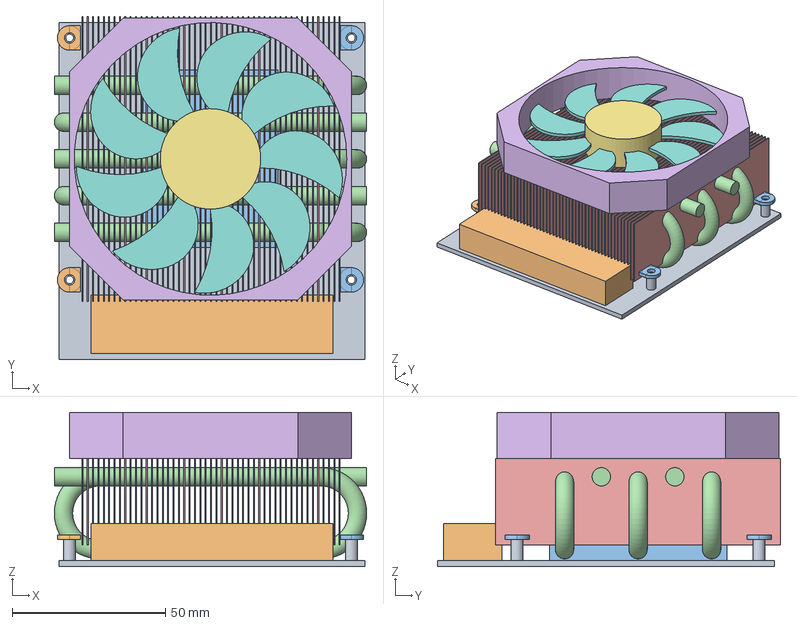
[picture p137: CAD file, 2026-10-31]
exports/cooler-study/g48r-reference.step
102.0 x 112.0 x 50.3 mm
g48r-reference.1.1
g48r-reference.1.2
g48r-reference.2
g48r-reference.3.1
g48r-reference.3.2
g48r-reference.3.3
g48r-reference.3.4
g48r-reference.3.5
g48r-reference.4.1
g48r-reference.4.2
g48r-reference.4.3
g48r-reference.4.4
g48r-reference.4.5
g48r-reference.4.6
g48r-reference.4.7
g48r-reference.4.8
g48r-reference.4.9
g48r-reference.4.10
g48r-reference.4.11
g48r-reference.4.12
g48r-reference.4.13
g48r-reference.4.14
g48r-reference.4.15
g48r-reference.4.16
g48r-reference.4.17
g48r-reference.4.18
g48r-reference.4.19
g48r-reference.4.20
g48r-reference.4.21
g48r-reference.4.22
g48r-reference.4.23
g48r-reference.4.24
g48r-reference.4.25
g48r-reference.4.26
g48r-reference.4.27
g48r-reference.4.28
g48r-reference.4.29
g48r-reference.4.30
g48r-reference.4.31
g48r-reference.4.32
g48r-reference.4.33
g48r-reference.4.34
g48r-reference.4.35
g48r-reference.4.36
g48r-reference.4.37
g48r-reference.4.38
g48r-reference.4.39
g48r-reference.4.40
g48r-reference.4.41
g48r-reference.4.42
g48r-reference.4.43
g48r-reference.4.44
g48r-reference.4.45
g48r-reference.4.46
g48r-reference.4.47
g48r-reference.4.48
g48r-reference.4.49
g48r-reference.5
g48r-reference.6.1
g48r-reference.6.2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
