mvalancy/j501-agx-orin/exports/storage_25.step

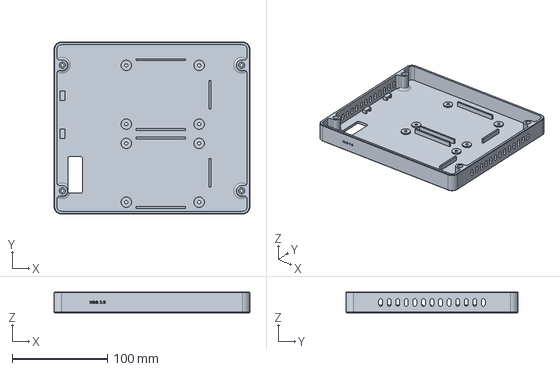
[picture p138: CAD file, 2026-10-31]
exports/storage_25.step
206.0 x 181.0 x 22.0 mm
