mvalancy/j501-agx-orin/exports/cooler-study/spreader.step

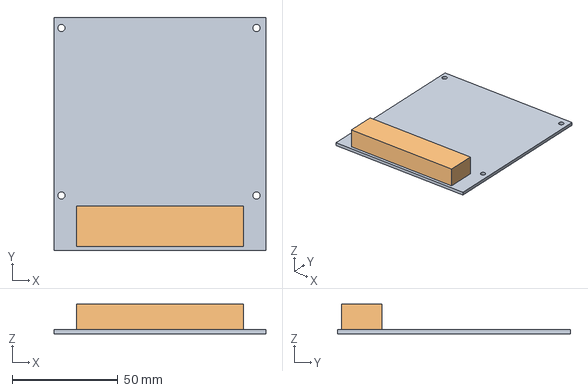
[picture p139: CAD file, 2026-10-31]
exports/cooler-study/spreader.step
100.0 x 110.0 x 14.0 mm
spreader.1
spreader.2
