mvalancy/j501-agx-orin/exports/ssd_clip.step

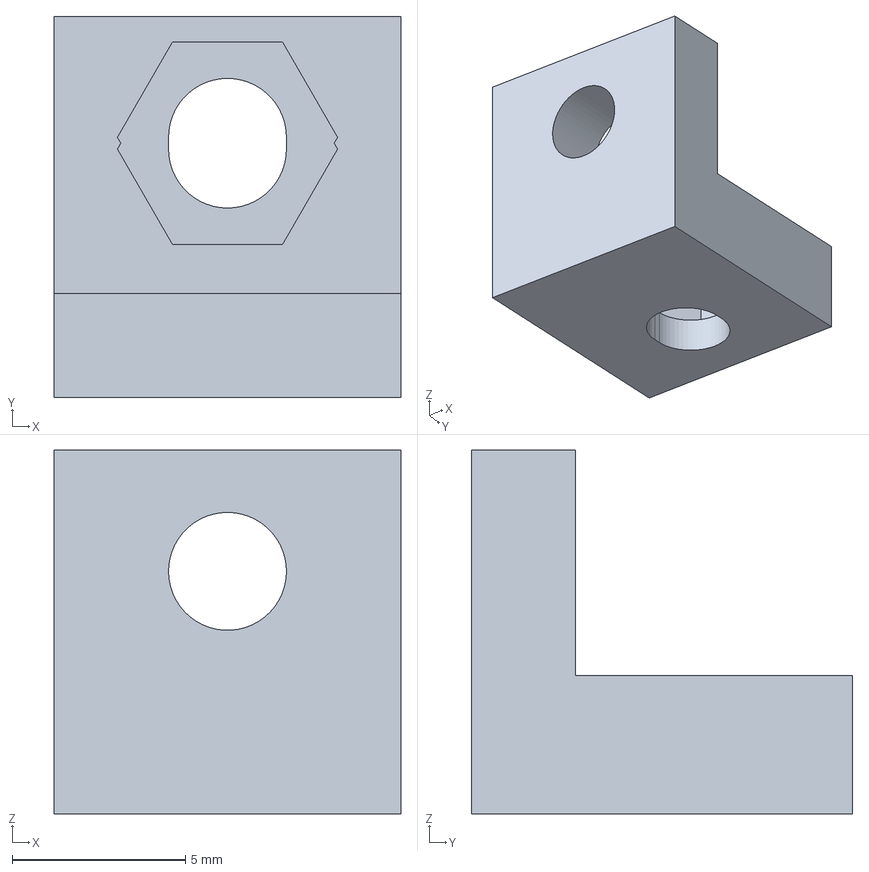
[picture p140: CAD file, 2026-10-31]
exports/ssd_clip.step
10.0 x 11.0 x 10.5 mm
