mvalancy/j501-agx-orin/exports/base_mount.step

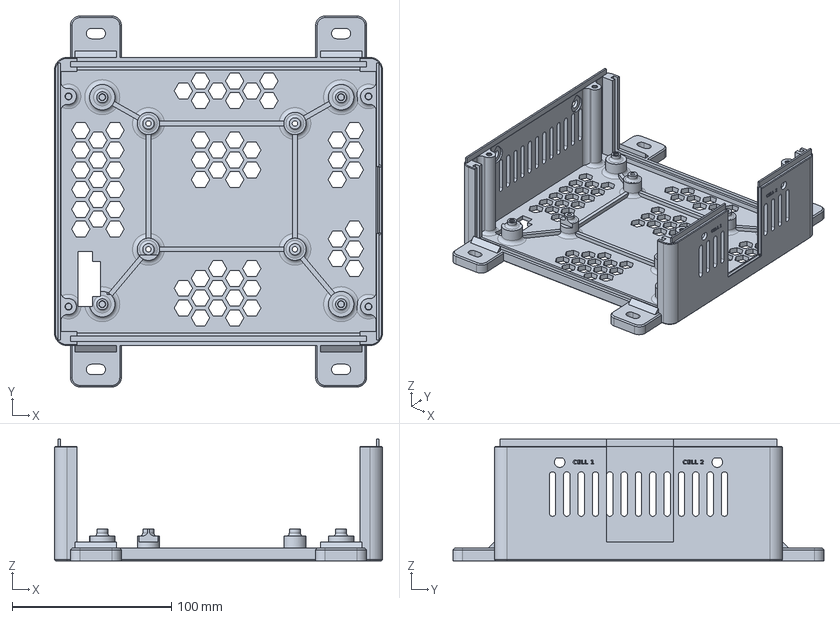
[picture p141: CAD file, 2026-10-31]
exports/base_mount.step
206.0 x 233.0 x 76.5 mm
