mvalancy/j501-agx-orin/exports/cooler-study/mount_ears_provisional.step

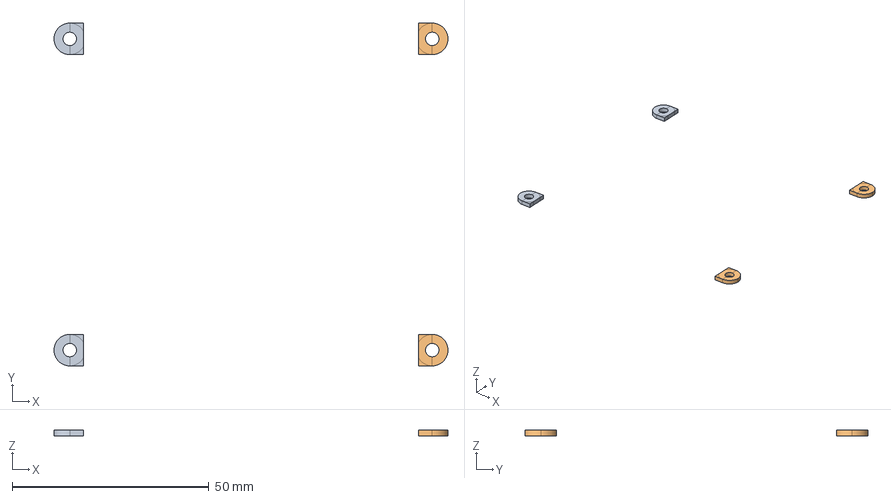
[picture p142: CAD file, 2026-10-31]
exports/cooler-study/mount_ears_provisional.step
100.0 x 87.0 x 1.50 mm
mount_ears_provisional.1
mount_ears_provisional.2
mount_ears_provisional.3
mount_ears_provisional.4
