mvalancy/j501-agx-orin/exports/cooler-study/heat_pipes.step

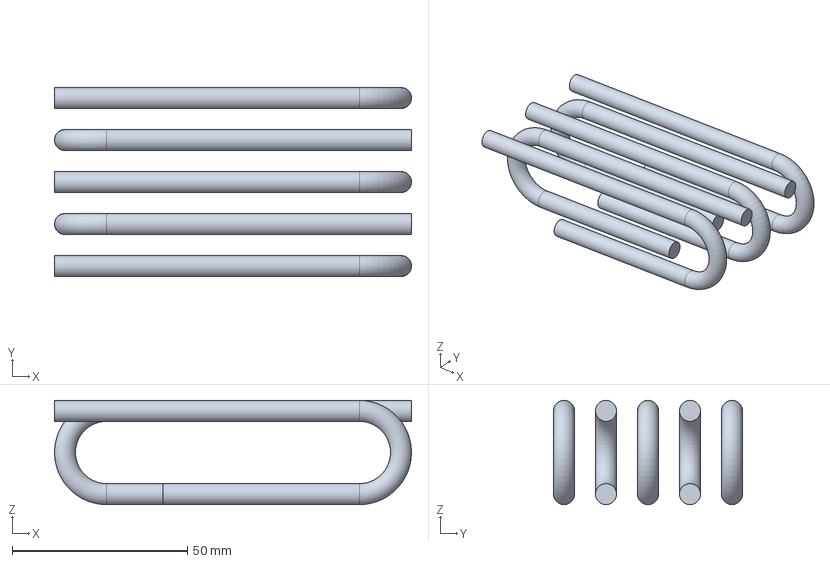
[picture p143: CAD file, 2026-10-31]
exports/cooler-study/heat_pipes.step
102.0 x 54.0 x 29.8 mm
heat_pipes.1
heat_pipes.2
heat_pipes.3
heat_pipes.4
heat_pipes.5
