mvalancy/j501-agx-orin/exports/rear_io.step

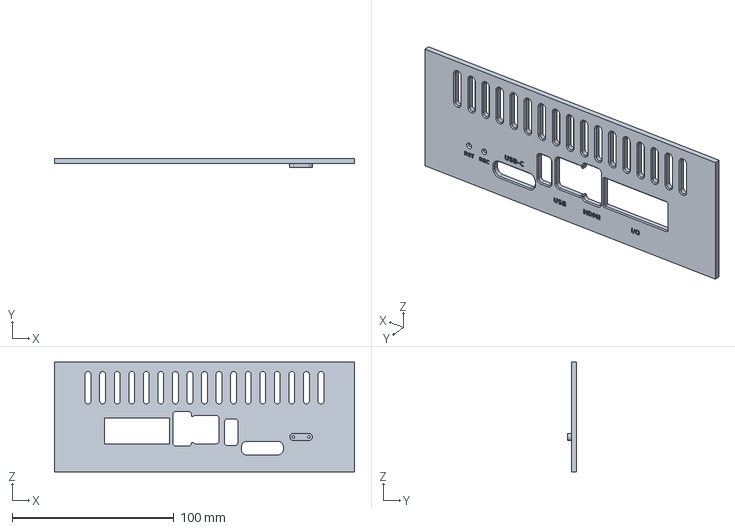
[picture p144: CAD file, 2026-10-31]
exports/rear_io.step
185.5 x 5.40 x 67.8 mm
