mvalancy/j501-agx-orin/exports/cooler-study/cold_plate.step

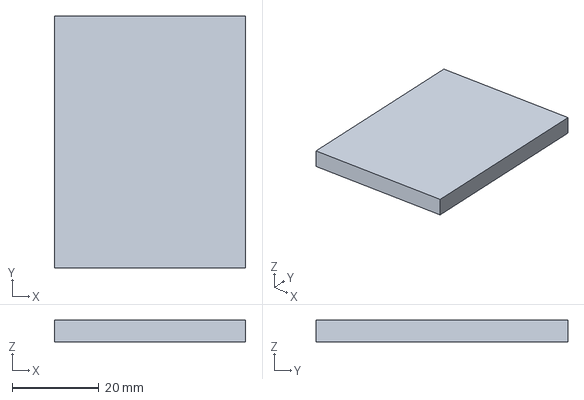
[picture p145: CAD file, 2026-10-31]
exports/cooler-study/cold_plate.step
44.0 x 58.0 x 5.00 mm
