mvalancy/j501-agx-orin/exports/cover.step

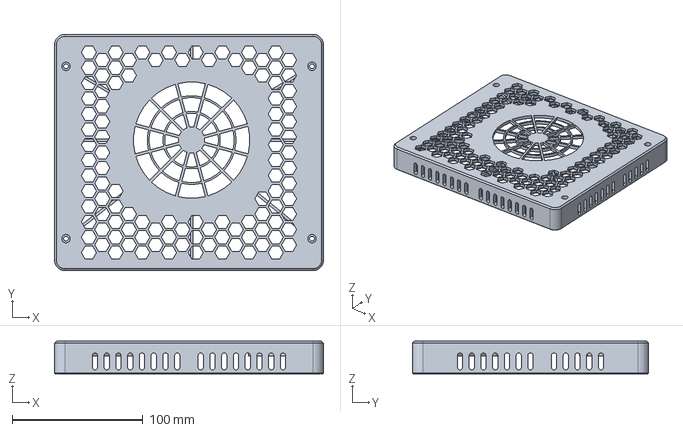
[picture p146: CAD file, 2026-10-31]
exports/cover.step
206.0 x 181.0 x 25.0 mm
