mvalancy/j501-agx-orin/exports/base.step

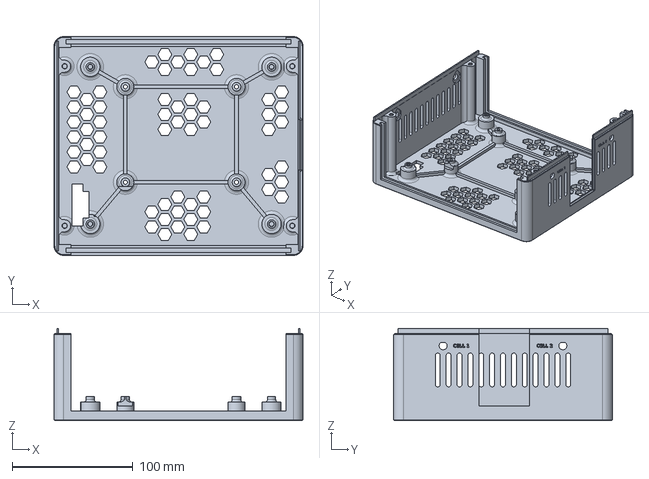
[picture p147: CAD file, 2026-10-31]
exports/base.step
206.0 x 181.0 x 76.5 mm
