mvalancy/j501-agx-orin/exports/cooler-study/fins.step

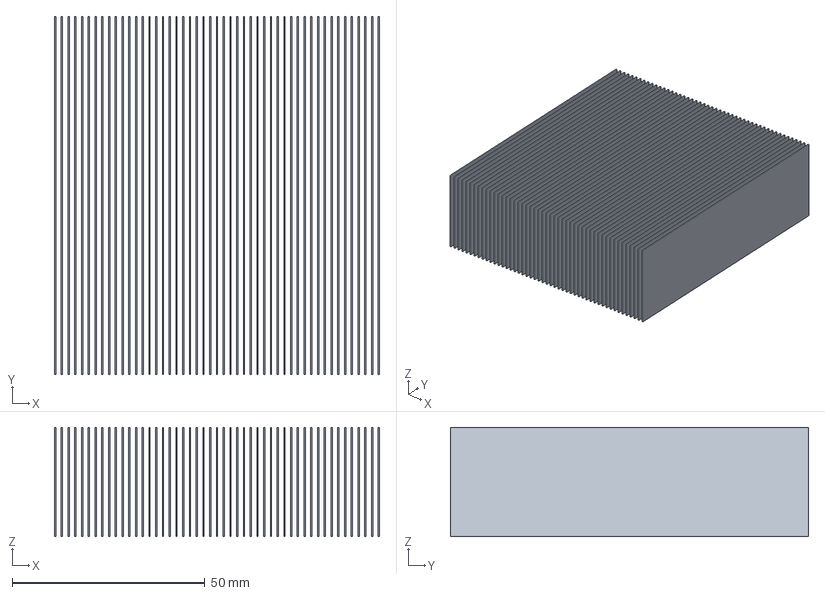
[picture p148: CAD file, 2026-10-31]
exports/cooler-study/fins.step
84.3 x 93.0 x 28.3 mm
fins.1
fins.2
fins.3
fins.4
fins.5
fins.6
fins.7
fins.8
fins.9
fins.10
fins.11
fins.12
fins.13
fins.14
fins.15
fins.16
fins.17
fins.18
fins.19
fins.20
fins.21
fins.22
fins.23
fins.24
fins.25
fins.26
fins.27
fins.28
fins.29
fins.30
fins.31
fins.32
fins.33
fins.34
fins.35
fins.36
fins.37
fins.38
fins.39
fins.40
fins.41
fins.42
fins.43
fins.44
fins.45
fins.46
fins.47
fins.48
fins.49
