mvalancy/j501-agx-orin/exports/cooler-study/fan_rotor.step

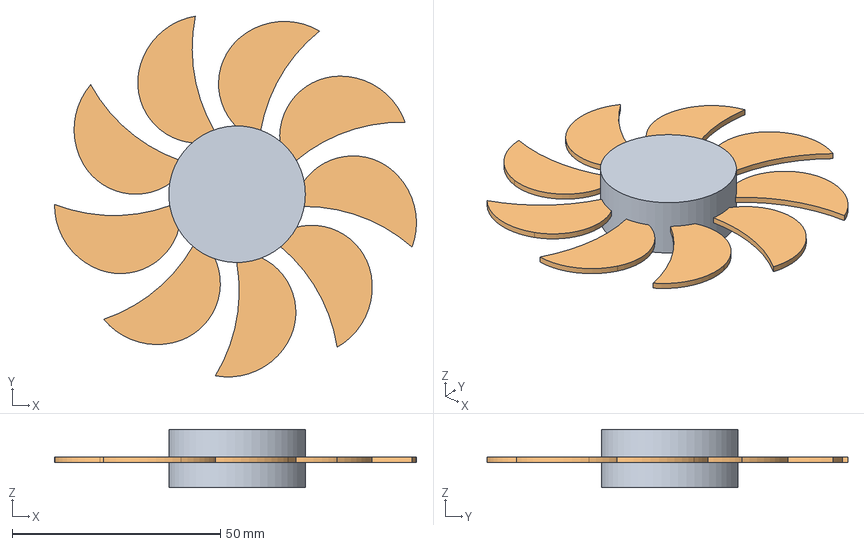
[picture p149: CAD file, 2026-10-31]
exports/cooler-study/fan_rotor.step
86.9 x 86.6 x 14.0 mm
fan_rotor.1
fan_rotor.2
fan_rotor.3
fan_rotor.4
fan_rotor.5
fan_rotor.6
fan_rotor.7
fan_rotor.8
fan_rotor.9
fan_rotor.10
