mvalancy/j501-agx-orin/exports/mount_fit_template.step

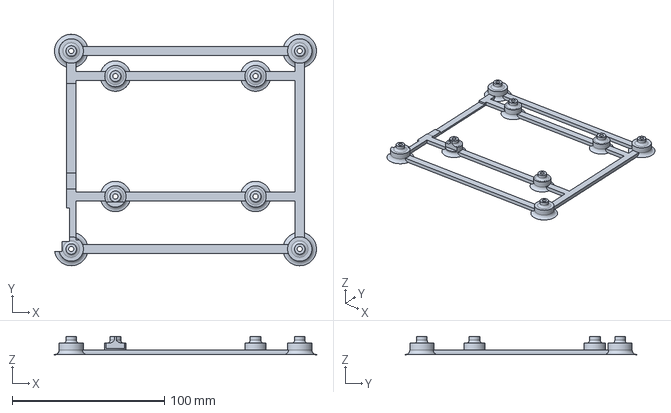
[picture p150: CAD file, 2026-10-31]
exports/mount_fit_template.step
172.0 x 152.0 x 12.0 mm
