mvalancy/j501-agx-orin/exports/rail_coupon.step

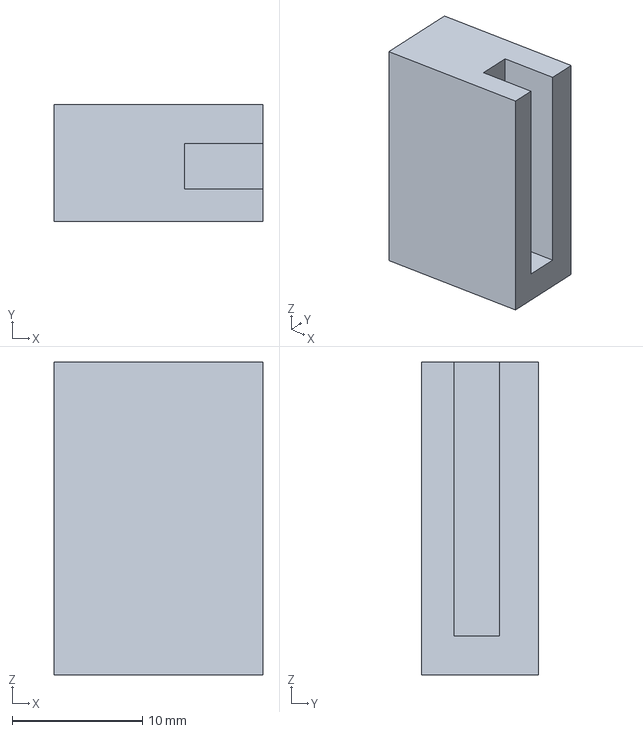
[picture p151: CAD file, 2026-10-31]
exports/rail_coupon.step
16.0 x 9.00 x 24.0 mm
