mvalancy/j501-agx-orin/exports/front_gmsl.step

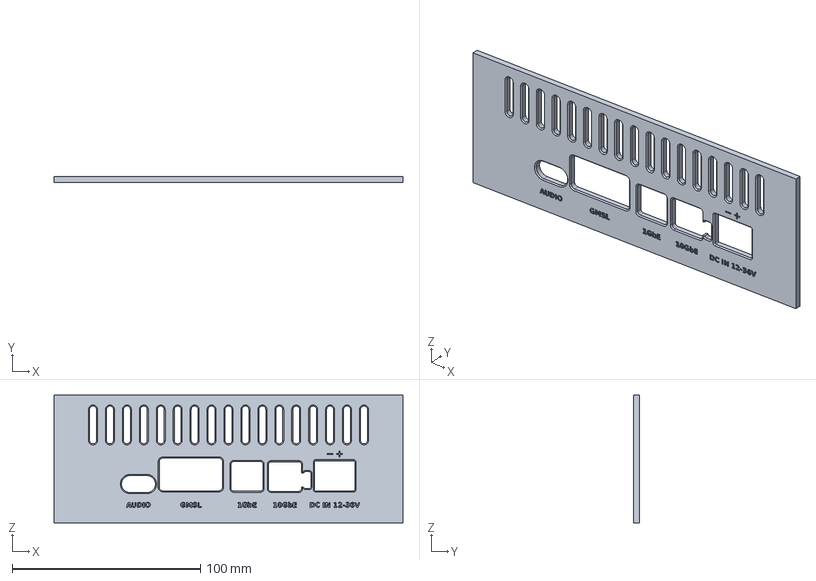
[picture p152: CAD file, 2026-10-31]
exports/front_gmsl.step
185.5 x 3.00 x 67.8 mm
