mvalancy/j501-agx-orin/exports/countersink_coupon.step

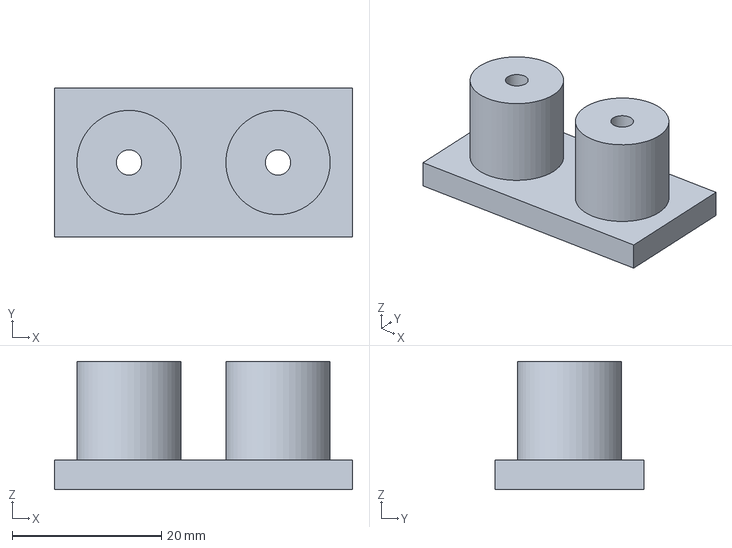
[picture p153: CAD file, 2026-10-31]
exports/countersink_coupon.step
40.0 x 20.0 x 17.2 mm
