mvalancy/j501-agx-orin/exports/m3_insert_coupon.step

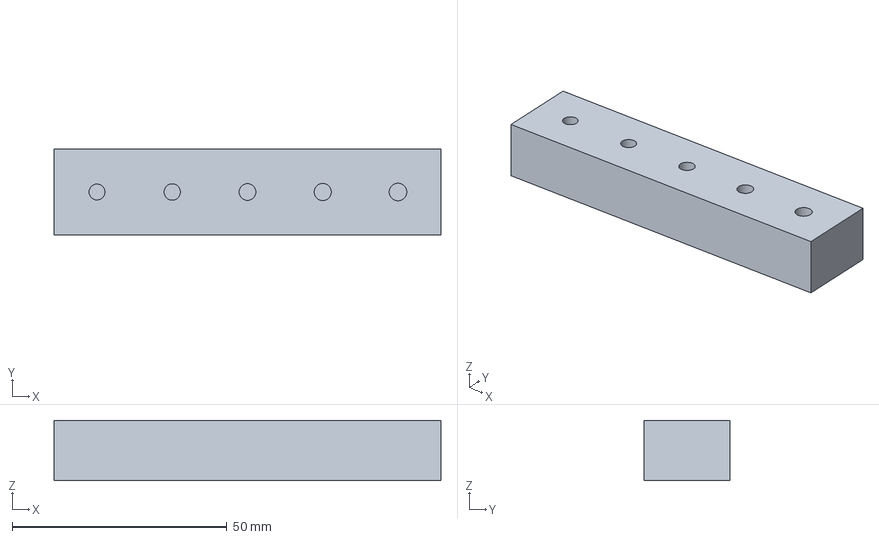
[picture p154: CAD file, 2026-10-31]
exports/m3_insert_coupon.step
90.0 x 20.0 x 14.0 mm
