mvalancy/j501-agx-orin/exports/rpsma_coupon.step

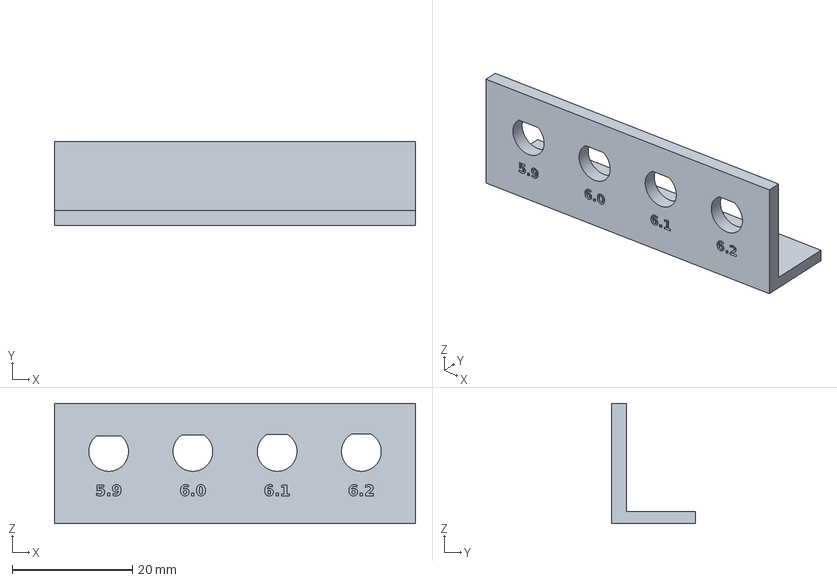
[picture p155: CAD file, 2026-10-31]
exports/rpsma_coupon.step
60.0 x 14.0 x 20.0 mm
