mvalancy/j501-agx-orin/(list of files, cad)

Other CAD files:
exports/showcase-antennas/cell_1_antenna.stl
exports/cooler-study/pcb_reference.step
exports/showcase-antennas/wifi_1_antenna.stl
archive/rev02/exports/desktop_foot.step
archive/rev02/exports/desktop_foot.stl
archive/rev02/exports/mount_ear.step
archive/rev02/exports/mount_ear.stl
archive/rev04/exports/insert_coupon.step
archive/rev04/exports/insert_coupon.stl
exports/base.3mf
exports/base.stl
exports/base_mount.3mf
exports/base_mount.stl
exports/chimney_cap.3mf
exports/chimney_cap.stl
exports/countersink_coupon.3mf
exports/countersink_coupon.stl
exports/cover.3mf
exports/cover.stl
exports/front_gmsl.3mf
exports/front_gmsl.stl
exports/front_no_gmsl.3mf
exports/front_no_gmsl.stl
exports/m3_insert_coupon.3mf
exports/m3_insert_coupon.stl
exports/mount_fit_template.3mf
exports/mount_fit_template.stl
exports/rail_coupon.3mf
exports/rail_coupon.stl
exports/rail_key.3mf
exports/rail_key.stl
exports/rear_io.3mf
exports/rear_io.stl
exports/rpsma_coupon.3mf
exports/rpsma_coupon.stl
exports/side_hatch.3mf
exports/side_hatch.stl
exports/ssd_clip.3mf
exports/ssd_clip.stl
exports/storage_25.3mf
exports/storage_25.stl
exports/storage_35.3mf
exports/storage_35.stl
exports/storage_mount_plate.3mf
exports/storage_mount_plate.stl
references/pcb-outline.stl
