mvalancy/j501-agx-orin/docs/assembly/README.md

[J501 AGX Orin](../../README.md) / [docs](../) / **assembly**

# Assembly step pictures

The pictures for [ASSEMBLY.md](../../ASSEMBLY.md), drawn by [`tools/render_steps.py`](../../tools/render_steps.py). In each one the parts
added in that step are **orange** and everything already built is grey. Click a picture to read that step.

<table>
<tr>
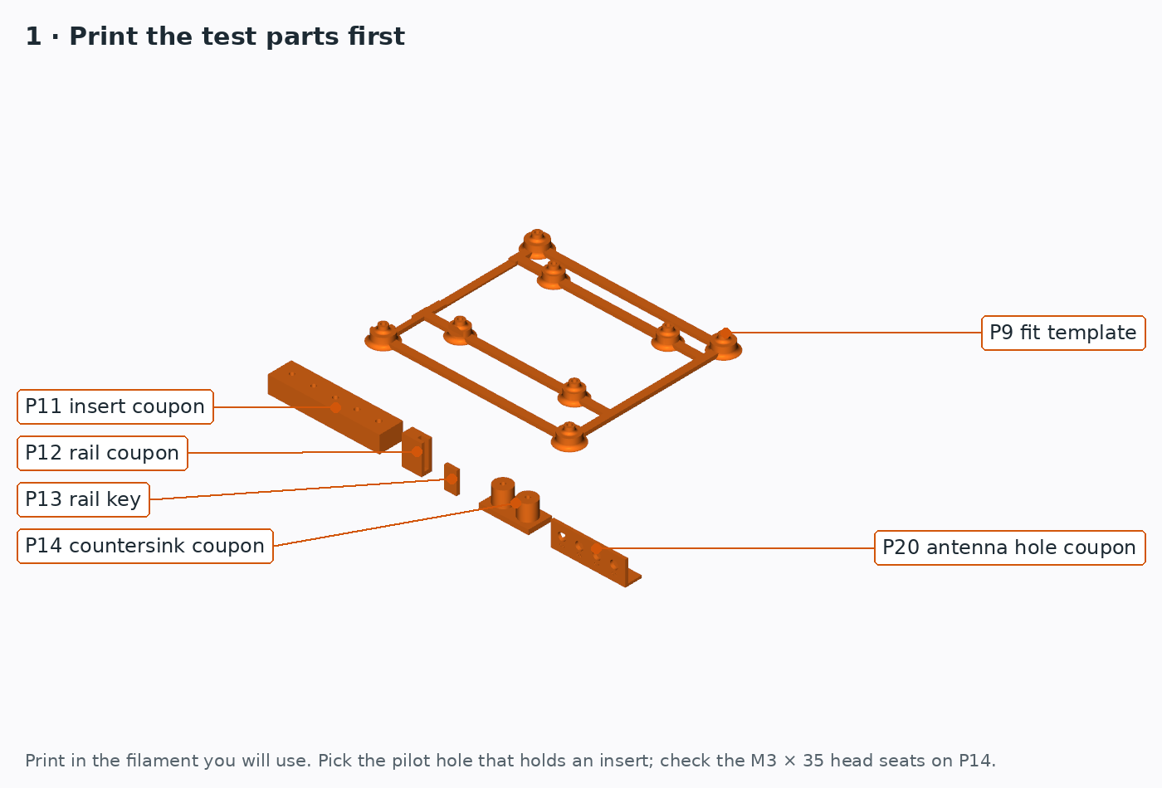
[picture p156: docs/assembly/01-test-prints.png]
1. Print the test parts
<td width="33%" valign="top"><br><b>1. Print the test parts</b></td>
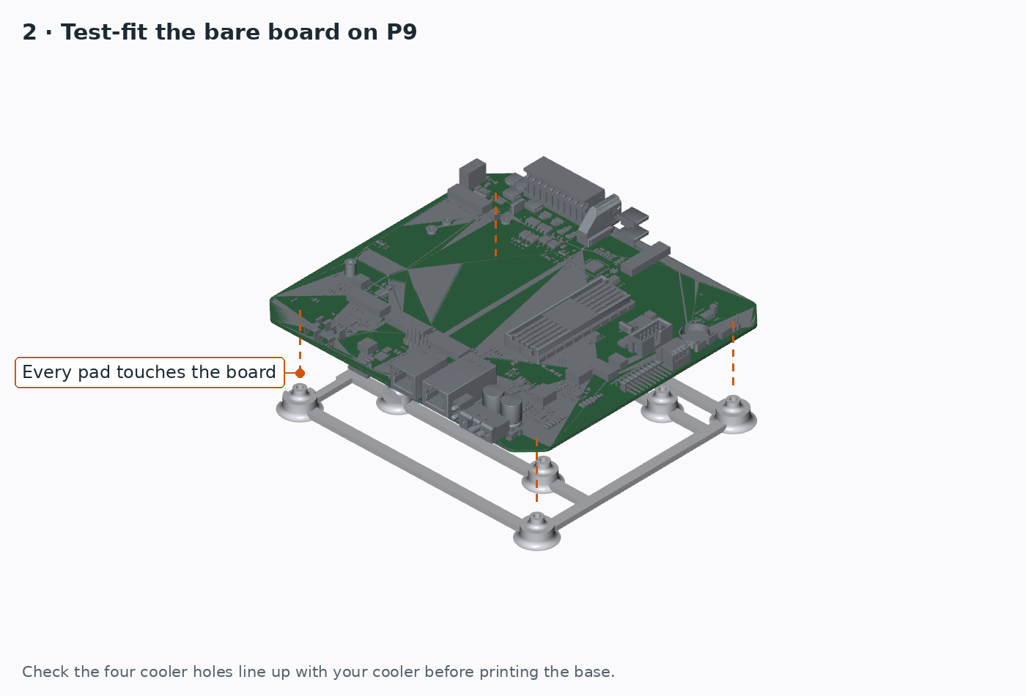
[picture p157: docs/assembly/02-fit-template.png]
2. Test-fit the board on P9
<td width="33%" valign="top"><br><b>2. Test-fit the board on P9</b></td>
<td width="33%" valign="top"><a href="../../ASSEMBLY.md#3-heat-set-the-inserts">3. Heat-set the inserts</a><br><b>3. Heat-set the inserts</b></td>
</tr>
<tr>
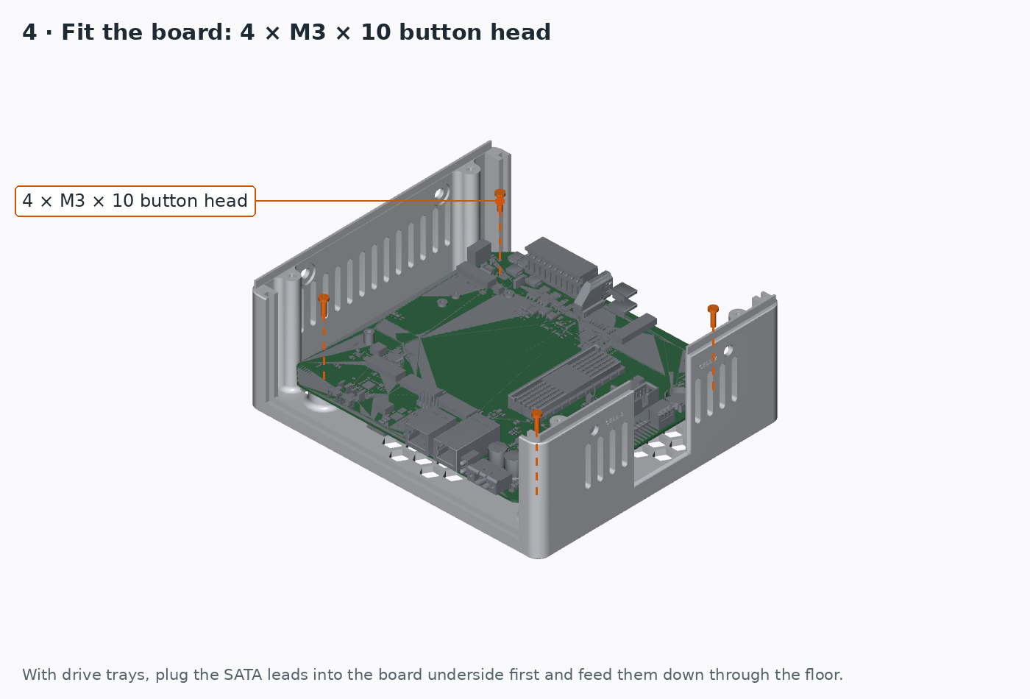
[picture p158: docs/assembly/04-board.png]
4. Fit the board
<td width="33%" valign="top"><br><b>4. Fit the board</b></td>
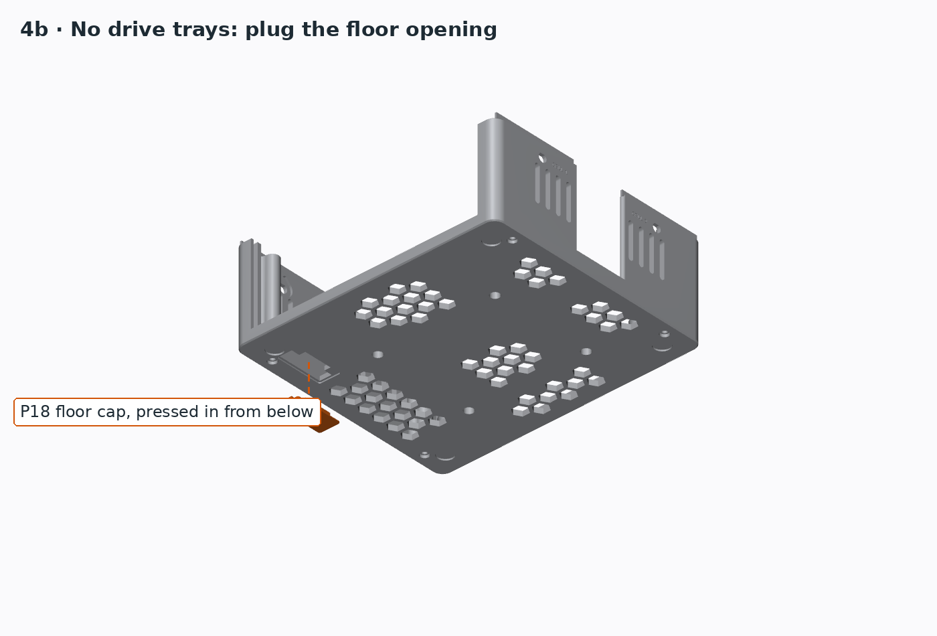
[picture p159: docs/assembly/04b-floor-cap.png]
4. Floor cap (no drive trays)
<td width="33%" valign="top"><br><b>4. Floor cap (no drive trays)</b></td>
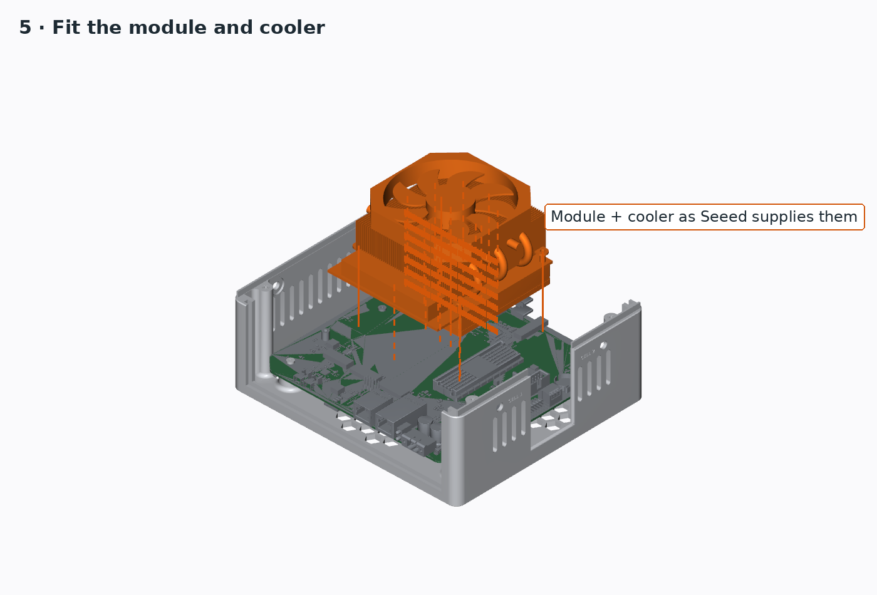
[picture p160: docs/assembly/05-cooler.png]
5. Fit the module and cooler
<td width="33%" valign="top"><br><b>5. Fit the module and cooler</b></td>
</tr>
<tr>
<td width="33%" valign="top"><a href="../../ASSEMBLY.md#6-tie-the-cooler-down">6. Tie the cooler down</a><br><b>6. Tie the cooler down</b></td>
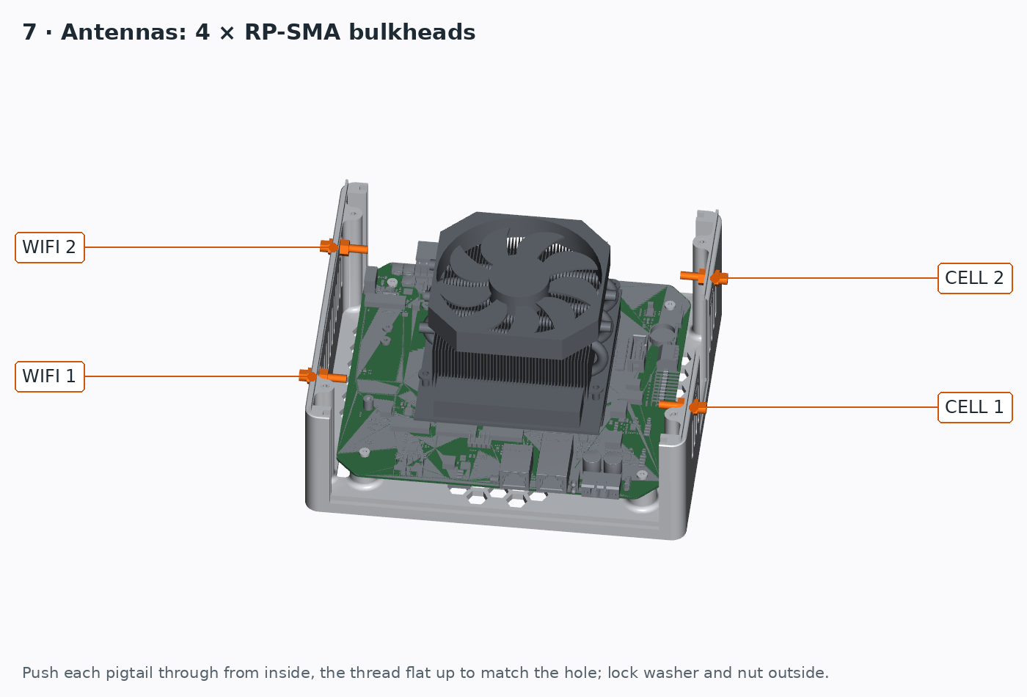
[picture p161: docs/assembly/07-antennas.png]
7. Fit the antennas
<td width="33%" valign="top"><br><b>7. Fit the antennas</b></td>
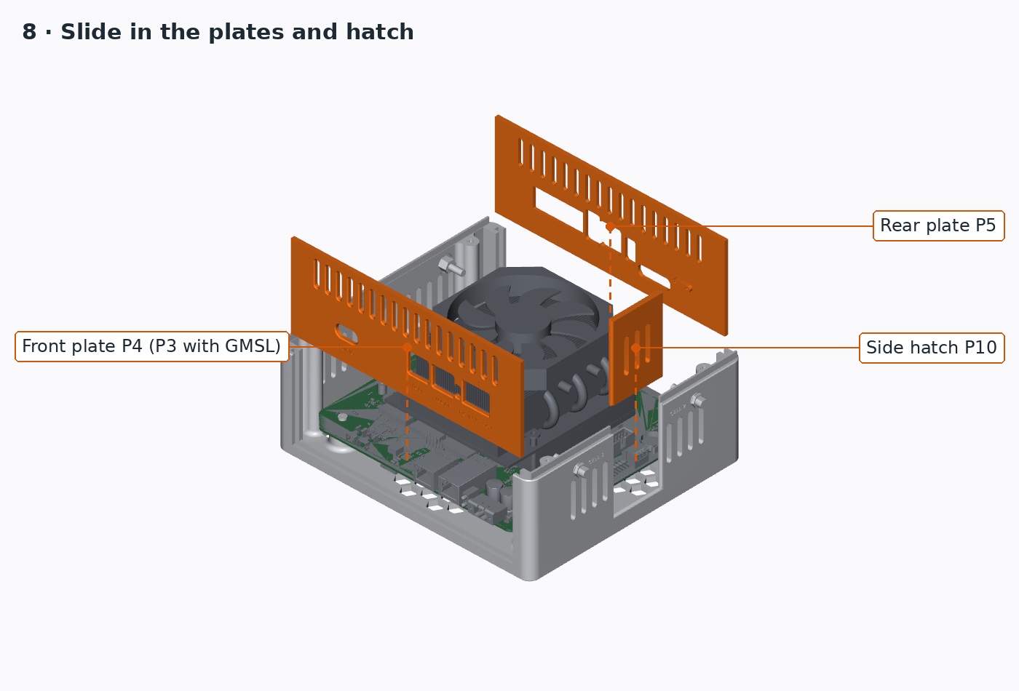
[picture p162: docs/assembly/08-plates.png]
8. Slide in the plates
<td width="33%" valign="top"><br><b>8. Slide in the plates</b></td>
</tr>
<tr>
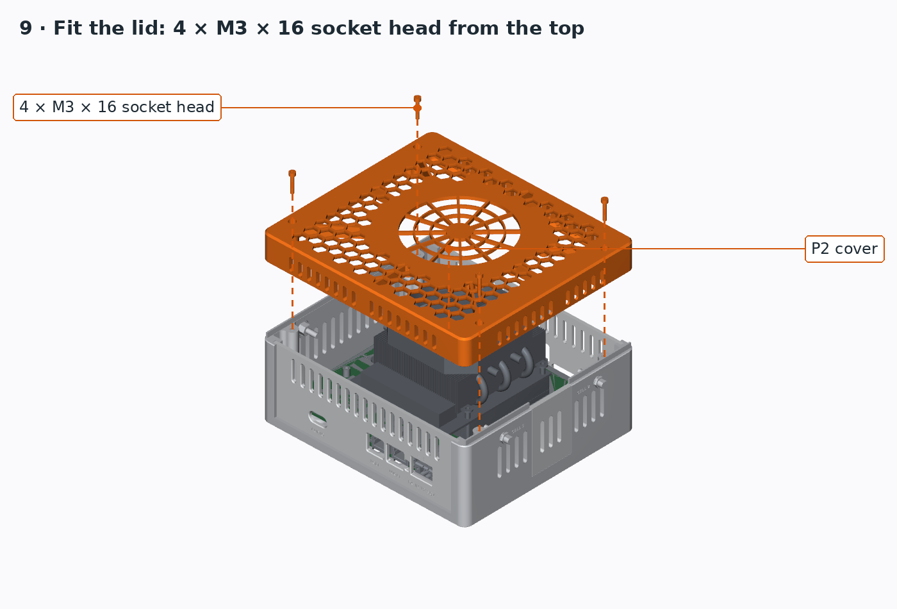
[picture p163: docs/assembly/09-lid.png]
9. Fit the lid
<td width="33%" valign="top"><br><b>9. Fit the lid</b></td>
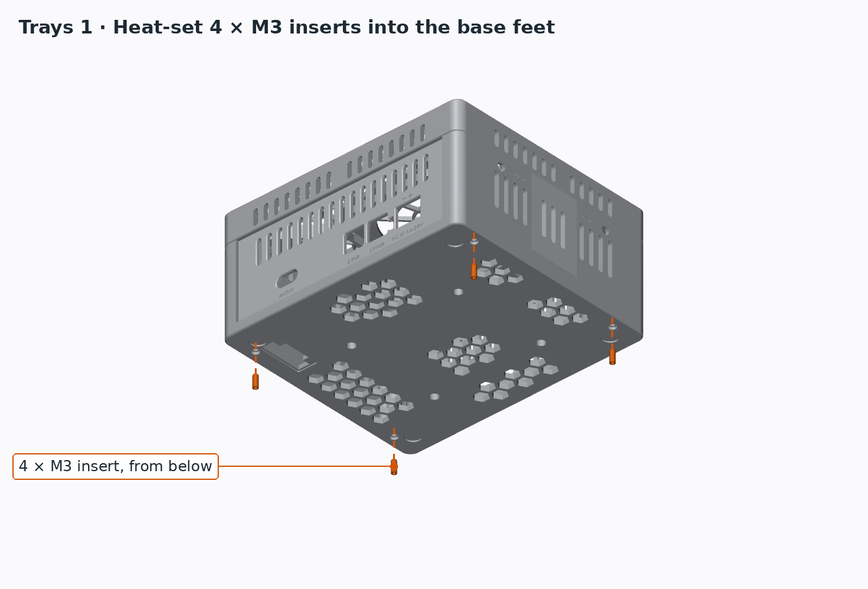
[picture p164: docs/assembly/10-tray-inserts.png]
Trays 1. Inserts in the base feet
<td width="33%" valign="top"><br><b>Trays 1. Inserts in the base feet</b></td>
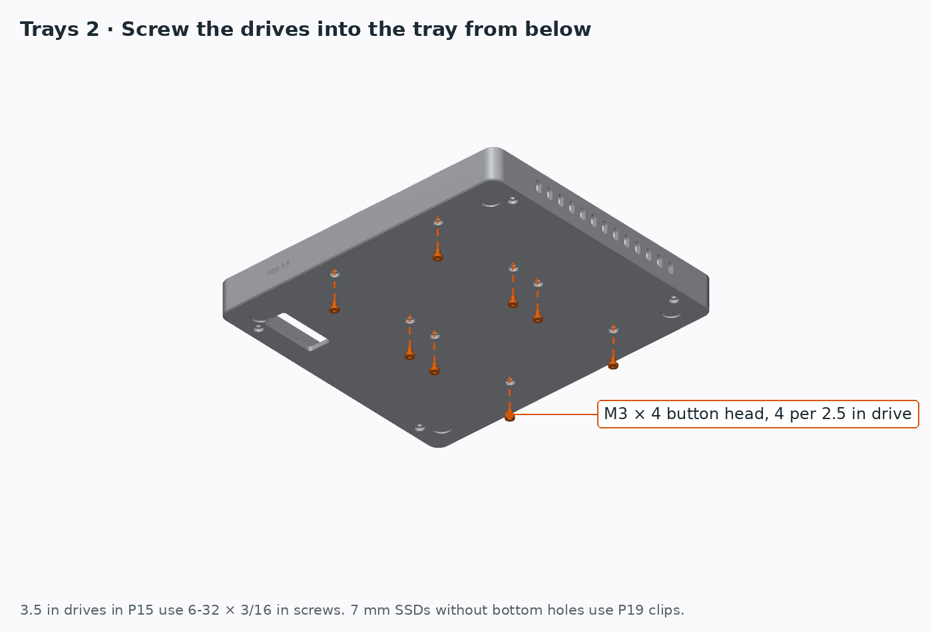
[picture p165: docs/assembly/11-drives.png]
Trays 2. Drives into the tray
<td width="33%" valign="top"><br><b>Trays 2. Drives into the tray</b></td>
</tr>
<tr>
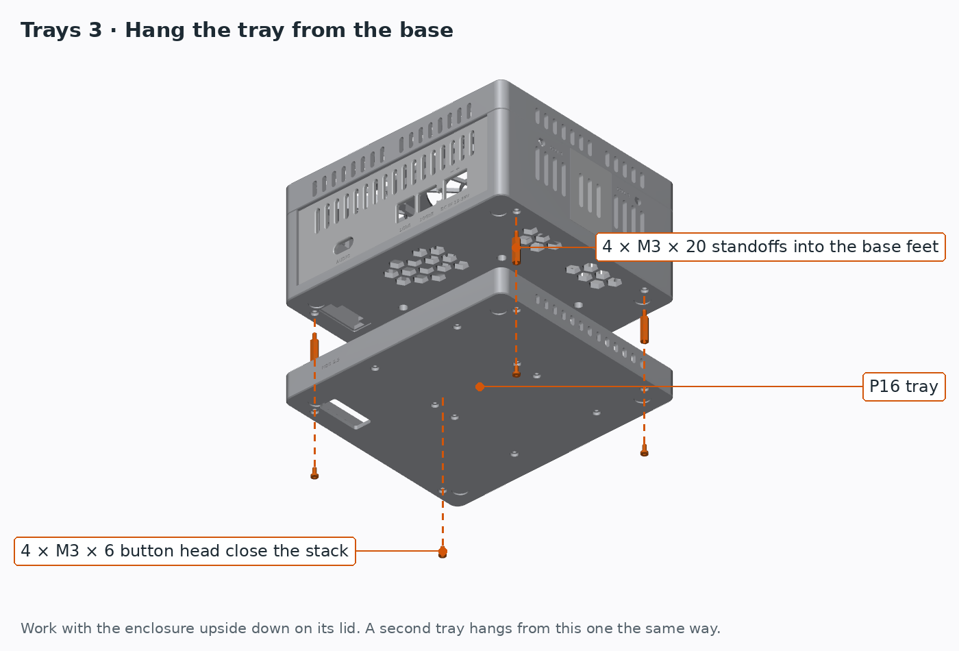
[picture p166: docs/assembly/12-stack.png]
Trays 4. Hang the tray
<td width="33%" valign="top"><br><b>Trays 4. Hang the tray</b></td>
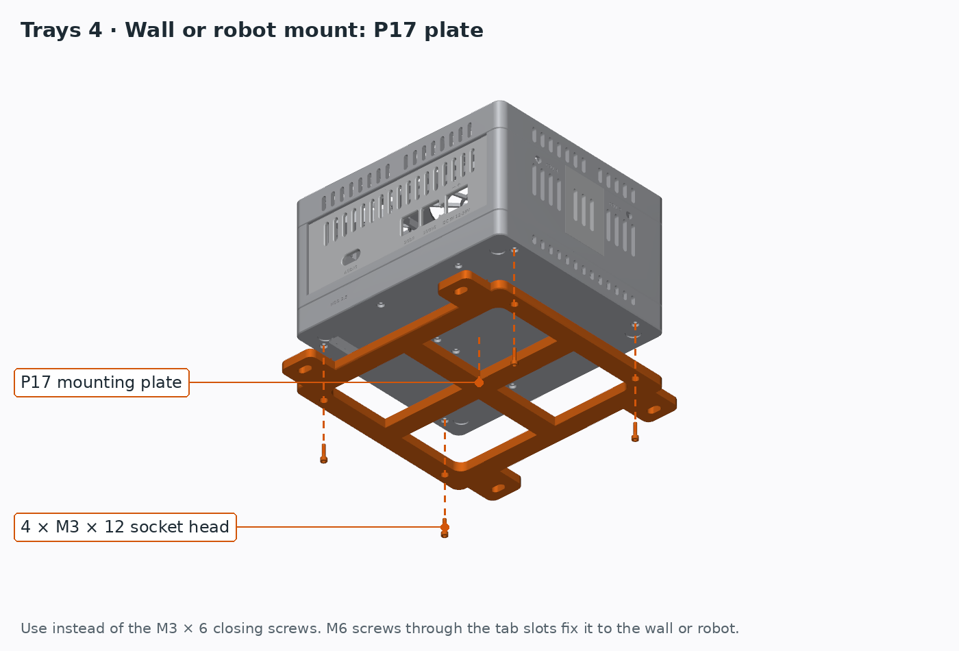
[picture p167: docs/assembly/13-mount-plate.png]
Trays 5. Wall or robot mount
<td width="33%" valign="top"><br><b>Trays 5. Wall or robot mount</b></td>
<td width="33%"></td>
</tr>
</table>
