mvalancy/j501-agx-orin/(list of files, drawings)

Other design files:
references/pcb-circles.json
references/pcb-hole-fits.json
