mvalancy/j501-agx-orin/(commit log)

2026-10-25 J501 AGX Orin enclosure, Rev 0.6
    CadQuery enclosure for the Seeed reServer J501 carrier with a Jetson AGX Orin:
    printable parts (STL/3MF/STEP), storage trays, design checks and the review site.
    Vendor reference files are fetched by tools/fetch_references.py, not redistributed.
    [BOM.csv, base.3mf, base.step, base.stl, base_mount.3mf, base_mount.step, base_mount.stl, chimney_cap.3mf]
2026-10-25 Add MIT license; link the now-public cad-agent toolkit
2026-10-25 README: hero render, assembly diagram, Seeed product links, at-a-glance summary
2026-10-25 README: lead with the printed/purchased BOM and assembly steps; simple assembly-flow diagram
2026-10-25 Add tools/package_release.py: print zip with STLs, instructions and renders
2026-10-25 README: link the Rev 0.6 print package release
2026-10-25 Add CI: verify committed exports against the pipeline run, build the print zip, publish releases on rev tags
    Actions pinned by commit SHA; Python dependencies pinned by hash.
2026-10-25 Illustrated assembly guide; fix P17 plate screw length
    - ASSEMBLY.md with a picture per step (tools/render_steps.py, docs/assembly/), new parts in orange
    - P17 plate screws M3 x 12 (M3 x 10 gave only 2 mm engagement; BOM said M3 x 8)
    - BOM: add the M3 x 6 closing screws for a stack without P17
    - Release zip includes ASSEMBLY.md and the step pictures
    - CI check reads the cad-agent package manifest; drop the superseded package_review.py
    - Render helpers moved to tools/renderkit.py
    [BOM.csv, base.3mf, base.step, base_mount.3mf, base_mount.step, chimney_cap.3mf, chimney_cap.step, countersink_coupon.3mf]
2026-10-25 CI check: verify only the printable parts against the manifest (vendor assemblies are not in the repo)
2026-10-25 Add a README with pictures to every folder; exports/README.md is the print index
    tools/write_readmes.py generates them (new readmes step in cad-agent.yaml). The print index shows
    each part as a card with its render, size, GitHub 3D view and 3MF/STL/STEP links, grouped into core
    enclosure, mounting and closures, drive storage, and jigs/fixtures/test coupons. CI fails if a README
    is stale, and ci_check.py now checks the links in every README.
    [cad-agent.yaml]
2026-10-26 Rev 0.7: port windows from modelled mating plugs; print-fit fixes
    - Every front/rear port window is now derived from a model of its mating plug
    (cadagent.connectors via cad/ports.py) and proven by a 3D insertion-sweep
    check (tools/check_ports.py, new "ports" pipeline step and review gate).
    The old windows were sized from receptacle bboxes that included through-hole
    pins, so they sat ~2 mm low; the DC plug (Phoenix MSTB 2,5/2-STF-5,08) could
    not mate at all.
    - DC IN, audio and both RJ45 windows recentred and raised; DC window sized for
    the flanged plug. Labels: "DC IN 12-36V" with +/- marks (polarity inferred,
    verify with a meter), "1GbE" and "10GbE".
    - Lid screw clearance 3.6 m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
    [base.3mf, base.step, base.stl, base_mount.3mf, base_mount.step, base_mount.stl, chimney_cap.3mf, chimney_cap.step]
2026-10-26 WIP Rev 0.8: lower lid, intake ring, star-ribbed roof, topology floor vents; FEA, topology, slicer and heatsink studies (CFD pending)
    [connector-inventory.csv, floor.stl, measurement-register.csv, roof.stl]
2026-10-27 Rev 0.8: D-flat RP-SMA holes (flat on top replaces the teardrop) + P20 fit coupon; site top bar on every page
    The bulkhead thread's milled flat (5.8 across) now keys into a 6.0 mm flat in the 2.5 mm
    antenna wall (Wurth WR-CXASY cutout: D6.5, flat 6.0). On top, the flat is a 3.8 mm bridge
    in place of the teardrop roof. P20 prints the wall with 5.9-6.2 mm flats to pick the fit.
    cad-agent.yaml configures the site and a 10-tab bar that cad-agent site --serve adds to every
    page; docs/milestones.yaml lists the revisions. Engineering review heading reads the revision.
    [cad-agent.yaml]
2026-10-27 thermal: --balance (continue a case until its energy balance closes) and --recalibrate (more fin-calibration rounds from where a case stopped); report and check say plainly when CFD has not settled
    check_sim's 'CFD converged' now needs a settled calibration (it passed on any calibration
    history). The report marks unsettled bare cases as still rising, adds the heat the fins carry
    at their temperature and whether the calibration settled, and explains the plate estimate.
2026-10-27 Rev 0.8 docs and release flow: Rev 0.8 badge and progress (final airflow numbers), dev → main pull requests, CI on dev, rev08 package name; re-breathing is an advisory check
2026-10-27 Fix docs step quote; longer timeouts for clearances and structure steps
    [cad-agent.yaml]
2026-10-27 Rev 0.8: regenerated print files, checks, renders, simulation results and report
    48 checks pass. Sliced: 368.1 g / 11.9 h for the enclosure set (Rev 0.7: 418.9 g / 13.1 h).
    Lid under 300 N: 0.76 mm (Rev 0.7 1.19 mm), SF 2.5. Airflow with the cooler at 40 W: plate
    hot spot about 57 C (Rev 0.7 64 C), fan air 32.1 C (37.6 C), converged (-1.4 % energy balance).
    Advisory: the fan still breathes air 7.1 K above the room (target 3 K).
    [BOM.csv, base.3mf, base.step, base.stl, base_mount.3mf, base_mount.step, base_mount.stl, chimney_cap.3mf]
2026-10-27 Rev 0.8: address review: roof ribs land on solid wall (no lid vent slot under a rib end), lid SF 3.0 at the 99.9th percentile and 0.72 mm; CFD check needs a settled calibration; --recalibrate/--balan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
    [base.3mf, base.step, base_mount.3mf, base_mount.step, chimney_cap.3mf, chimney_cap.step, countersink_coupon.3mf, countersink_coupon.step]
2026-10-27 Add G48R cooler reference assembly and lid clearance study
    [agx_reference.step, agx_reference.stl, cold_plate.step, cold_plate.stl, fan_frame.step, fan_frame.stl, fan_rotor.step, fan_rotor.stl]
2026-10-27 Mark generated cooler CAD as review artifacts
2026-10-28 WIP Rev 0.9: lid for the reComputer mini J501 G48R cooler (flush fan grille, skirt, star ribs), cooler model from S05/S06, lid sweep, riser tool
    [base.3mf, base.step, base_mount.3mf, base_mount.step, chimney_cap.3mf, chimney_cap.step, connector-inventory.csv, countersink_coupon.3mf]
2026-10-28 Rev 0.9: one cooler model, centred on the module; lid tolerates a 3 mm fan-position error
    - cad/hardware.py cooler_and_module() is the only cooler geometry (swept U-bend heat pipes, plates at the real
    pitch, curved blades, standoffs and provisional ears); cad/cooler_reference.py groups it for the fit study;
    cooler-profiles.json folded into parameters.json
    - Photo registration fixed: the first fit had IMG_1852 rotated 180 degrees. The cooler is centred on the module
    (ears on the module holes); spreader finned bar at the front edge
    - Fan pocket 6 mm outside the frame; build.py and tools/cooler_fit_review.py check the exact lid against the fan
    moved 3 mm in eight directions (modelled fr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
    [BOM.csv, connector-inventory.csv, measurement-register.csv, model-search.csv, mount_brackets_provisional.step, mount_brackets_provisional.stl, spacers_provisional.step, spacers_provisional.stl]
2026-10-28 One 3D viewer: printed parts, cooler, carrier board, module and screws as sections
    - tools/view_model.py (pipeline step view) writes the hardware and module context and exports one viewer
    manifest with sections (needs cad-agent feat/view-groups, Valpatel/cad-agent#24)
    - drop the separate Cooler 3D viewer and its meshes; the site's 3D model page shows the cooler as a section
    - the cooler study's module reference is now the module's bounding box: NVIDIA's model is not redistributed
    [agx_reference.stl, cold_plate.stl, fan_frame.stl, fan_rotor.stl, fins.stl, heat_pipes.stl, module_axes_reference.stl, pcb_reference.stl]
2026-10-28 CFD: the fan blows up (exhaust through the lid grille), not down
    The user observed it on the fitted cooler: air comes in from the perimeter and leaves up through the centre of the lid.
    - thermal.fan.axis [0, 0, 1]; notes record the observation
    - with an exhaust fan the air through the fan is the hot outlet: the air into the fins is now the fan air minus the
    fins' heat (T_fan - Q / (rho q cp)); the re-breathing check, figures and report use it
    - wording: the grille is the exhaust, the wall vents and hex cells are the intakes
2026-10-28 AGENTS.md: follow the cad-agent workflow kit (issues, push as you go, draft PRs, remote runs, review)
    Refs #6
2026-10-28 Rev 0.9: regenerate every export, report and render (cad-agent all on the compute host, 23/23 steps pass)
    Cooler study with the module envelope, the unified viewer step, structure FEA, renders and docs from the committed
    sources at 94da39d. The simulation gate still reads the earlier cooled CFD (fan blowing down); the rerun with the fan
    blowing up (#4) replaces it.
    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
    [agx_reference.step, base.3mf, base.step, base.stl, base_mount.3mf, base_mount.step, base_mount.stl, chimney_cap.3mf]
2026-10-28 Rev 0.9: slice report (Bambu Studio, P1S 0.20 Standard, PLA Basic): 375.7 g, 11.75 h for the enclosure set
    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
2026-10-28 Address review of #7: CFD fan check, design metrics, stale notes
    - check_sim: the CFD result must have the design's fan axis and centre (a fan-down run at the old position passed on
    the revision string alone); an air-into-fins estimate below the room is flagged as an estimate
    - design metrics: 106 open hex cells of 216 (the band by the skirt is blind), open area from those; cooler clearance
    to the grille underside (2.442 mm, was 1.942 to the roof); tie-down engagement from the standoff thread start
    (3.0 mm) plus the WS-RDN-601 case; the check sheet draws blind cells grey
    - parameters: axes_status, tim_note (the pad does raise the thread start), centre_note and heatsink_seat_note for th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
2026-10-28 Rev 0.9: cooled CFD with the fan blowing up (#4): converged, steady, calibrated
    4,600 iterations, energy balance -0.5 %. Fan 40.7 m3/h (24.0 CFM, 43 % of free air); air into the fins 25.13 C
    (room 25), exhaust 28.1 C; fins 33.9 C; thermal plate hot spot 35.6 C (44.4 K under the 80 C limit).
    Run: tools/thermal.py cooled --suffix=-0.9 --cell 10 --iterations 2000 --np 20, then --balance 7000, on the compute host.
    Refs #4
2026-10-28 Rev 0.9: regenerate everything with the fan-up CFD (cad-agent all, 23/23, 48 checks pass)
    Final pass on the compute host: tools/thermal_figures.py cooled-0.9, then cad-agent all
    on the committed sources (2e0b82b). Adds the fan-up CFD figures (side sections, walls,
    flow, convergence; the MP4s stay out of git) and refreshes the exports, check sheet,
    measurement register, engineering review and renders that pick up the notes from a442e88.
    [agx_reference.step, base.3mf, base.step, base_mount.3mf, base_mount.step, chimney_cap.3mf, chimney_cap.step, cold_plate.step]
2026-10-28 Rev 0.9: progress page and site notice with the final FEA, slice and fan-up CFD numbers
    Airflow marked done (fan up, 40.7 m3/h, air into the fins 25.1 C, plate hot spot 35.6 C,
    balance -0.5 %); lid FEA from exports/structure/lid_press-0.9.json (roof 0.65 mm, grille
    1.25 mm, SF 2.11 at the 99.9th percentile); filament 375.7 g / 11.75 h, cover 129.2 g.
    The notice now says what was checked.
2026-10-28 Rev 0.9: hex cells are intakes now: chamfer note and lid text (review of #7)
    The fan blows up and out through the grille, so the roof hex cells draw room air in and their
    inside chamfer is on the outlet side. The progress page now counts 106 open cells (of 216
    positions). Evidence (exports/design-metrics.json and the pages built from it) is regenerated
    in the next pipeline run.
2026-10-28 Rev 0.9: rebuild with reproducible 3MFs and re-slice (cad-agent all 23/23, 48 checks; slicer run)
    cad-agent all on the compute host on 0d8a536, with the reproducible 3MF writer
    (Valpatel/cad-agent#49): every 3MF now has fixed zip entry dates, so later rebuilds
    of unchanged geometry keep the slice report current. Re-sliced locally (Bambu
    Studio, P1S 0.20 Standard, PLA Basic): 375.7 g, 11.75 h, as before; the report now
    says the slicer was run. Regenerates design-metrics.json and the pages built from
    it with the hex-cell intake wording.
    [agx_reference.step, base.3mf, base.step, base_mount.3mf, base_mount.step, chimney_cap.3mf, chimney_cap.step, cold_plate.step]
2026-10-29 Cover: cut the lid-screw counterbores and clearance holes after the roof ribs (fixes #9)
    The star ribs run to the lid-screw centres. The counterbores were cut before the ribs were added, so each rib
    refilled about 92 mm3 of its counterbore (found by the owner on the printed lid; confirmed by cad-agent holes:
    four D6.4 counterbores, intrusion centred at z 90.5). Holes are now cut last, and the fixed cover passes (8 holes
    clear). parameters.json records release 0.9.1 and the observation.
2026-10-29 WIP release 0.9.1: hole exceptions, slice every part, the release page config, cad-agent release in package_release.py (#9, #10)
    - cad.holes: the RP-SMA D-holes (base, base_mount, rpsma_coupon) are deliberate, listed with the reason.
    - cad.slicer: every printed part, so each card on the release page has grams and time; sim_report keeps
    comparing the five-part enclosure set.
    - cad.release: parts in three groups with orientation, supports and use notes, the assembly guide, the hardware.
    - tools/package_release.py builds the release with cad-agent release; ci_check accepts the release tag (rev0.9.1).
    CI (ci.yml), the rebuild and the slice follow.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
2026-10-29 Release 0.9.1: rebuild with the lid-screw holes clear; print release from cad-agent release in CI (#9, #10)
    - cad-agent all on the fixed cover: 66 pass / 0 fail, including "Holes clear" for every
    part (exports/hole-checks.json; cover: 8 holes clear).
    - Every part is sliced (18 parts, 1014.5 g, 28.65 h), so the release page shows grams and
    time on every card.
    - CI fetches cad-agent at a pinned commit (CAD_AGENT_SHA) and builds the print release
    (release/j501-agx-rev<release>.zip with index.html); the tag job publishes that zip.
    - package_release.py: the zip name kept the ".1" of 0.9.1 (with_suffix dropped it).
    - AGENTS.md: walk cad-agent's common-issues index in every review; holes are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
    [agx_reference.step, base.step, base_mount.step, chimney_cap.step, cold_plate.step, countersink_coupon.step, cover.3mf, cover.step]
2026-10-29 Review of #11: print-one groups and a one-build total on the release page; rebuild
    - cad-agent.yaml release: base and front plate are pick-one groups. The drive storage
    group is optional. The page's first figure is one build: desktop, no GMSL, no drives,
    377 g and 11 h 46 min (needs Valpatel/cad-agent#89; the CI pin moves to 1184182).
    - The release note says the ribs were found in exports/cover.stl (as reported in #9).
    - The RP-SMA hole exceptions say they cover the coaxial holes in both walls.
    - cad-agent all on rtx4090 after the parameters.json text change: 66 pass / 0 fail,
    Holes clear; the slice report is still current (18 parts, 1014.5 g, 28.65 h).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
    [agx_reference.step, base.step, base_mount.step, chimney_cap.step, cold_plate.step, countersink_coupon.step, cover.step, fan_frame.step]
2026-10-31 Docs sweep: README for release 0.9.1, filament guidance, checks table; lesson for #9
    - README: the download points at the rev0.9.1 print release (index.html in the zip), and
    the status says the Rev 0.9 cover needs a reprint. The filament section says what the
    numbers assume (PLA) and where PLA is not enough (from the CFD air temperatures). The
    checks table has 18 parts and the hole check. The toolkit is cad-agent dev at the CI pin.
    - Release notes (package_release.py): the same filament guidance.
    - .agents: the counterbore lesson (holes cut last, the hole check, its limits).
2026-10-31 CI: Markdown 3.11.1 (fixes GHSA-5wmx-573v-2qwq, Dependabot alert 1, in versions below 3.8.1)
2026-10-31 Milestones: R0.9 done (rev0.9, rev0.9.1); next: a printed fit-check and the CFD fin calibration (#8)
2026-10-31 Reproducible STEP exports: fixed header date, product named after the file (fixes #12)
    The OCCT STEP writer stamped the write time into the header and named each product
    "Open CASCADE STEP translator 7.9 N", where N counts the exports in the process. So
    every rebuild rewrote all 31 tracked STEP files. cad/build.py export_step() fixes both;
    cad/build.py and tools/cooler_fit_review.py use it.
    - cad-agent all on rtx4090: 66 pass / 0 fail, Holes clear, the slice report still current.
    - A second run of build.py and cooler_fit_review.py gave identical sha256 for all 31
    tracked STEP files. Only the git-ignored assembly_gmsl.step still differs.
    - Lesson: .agents/inbox/2026-10-30-reproducible-step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
    [agx_reference.step, base.step, base_mount.step, chimney_cap.step, cold_plate.step, countersink_coupon.step, cover.step, fan_frame.step]
2026-10-31 Review of #13: assembly ids, quoted names, milestones restored, filament wording, slicer_run; rebuild
    - export_step: the NEXT_ASSEMBLY_USAGE_OCCURRENCE ids are numbered from 1 within each file,
    so a multi-solid STEP no longer depends on export order. A quote in the file name is
    doubled as STEP requires. The cooler-study STEPs are regenerated with it.
    - docs/milestones.yaml: restored (R0.9 done; R0.9F and T2 next). The sync back from the
    compute host had reverted it; this time every edit went to the host before the rebuild.
    - README and release notes: the 34 °C is a 40 W, 25 °C-room estimate of air temperature,
    and the CFD fan flow is not calibrated (#8). PETG/ASA for a 60 W module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
    [fan_rotor.step, fins.step, g48r-reference.step, heat_pipes.step, module_axes_reference.step, mount_ears_provisional.step, spacers.step]
2026-11-04 Loop the README banner
    Regenerated with mvalancy/mvalancy#6: the banner replays its intro, holds
    the finished frame for about 4 s, fades and builds again, so a visitor who
    scrolls to it late still sees it draw. Reduced motion still shows the
    finished frame.
2026-11-12 Plan source-backed optional Wi-Fi antenna showcase fragments
2026-11-12 Add original optional Wi-Fi antenna showcase context with provenance checks
    [wifi_1_antenna.stl, wifi_2_antenna.stl]
2026-11-12 Record unchanged print inventory and normal validation results
2026-11-12 Complete optional antenna display with distinct proposed cellular pair
    [cell_1_antenna.stl, cell_2_antenna.stl]
